weiiwang01/magi/README.md

> [!WARNING]  
> The magi project is still heavily in progress right now.
> A new version of magi is in the works.
