weiiwang01/magi/Magi.pdf

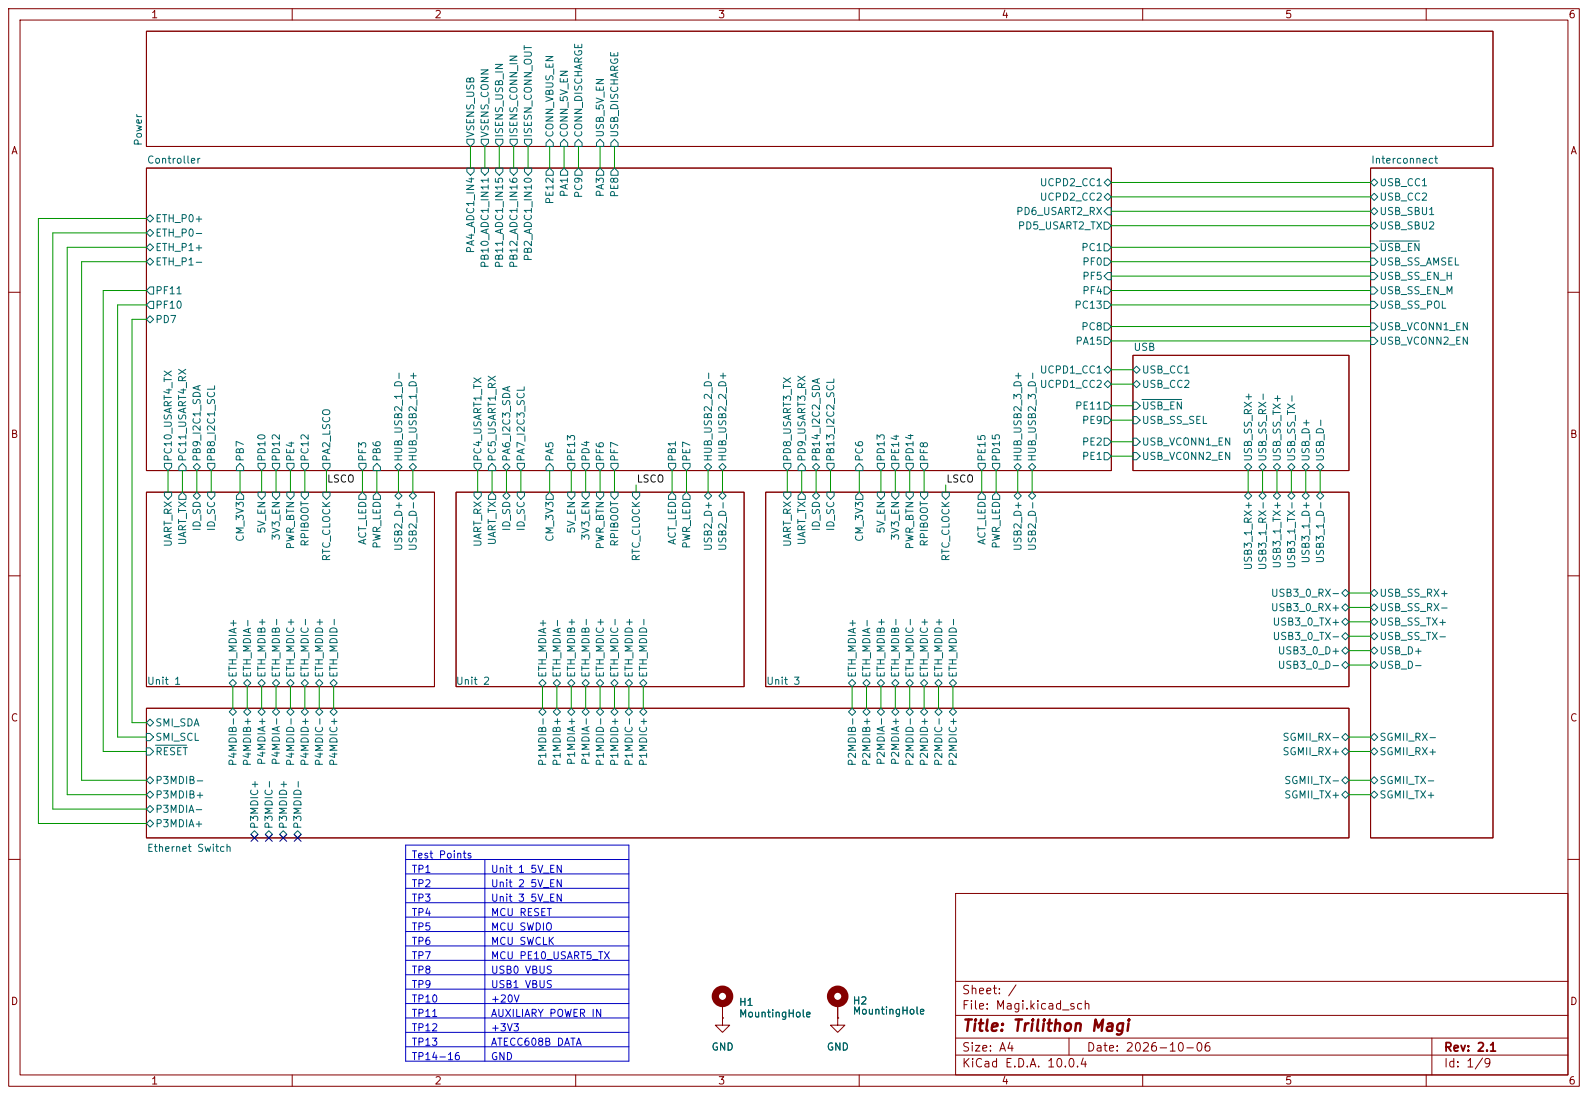
[picture p1: page 1]

TP1 | Unit 1 5V_EN
TP2 | Unit 2 5V_EN
TP3 | Unit 3 5V_EN
TP4 | MCU RESET
TP5 | MCU SWDIO
TP6 | MCU SWCLK
TP7 | MCU PE10_USART5_TX
TP8 | USB0 VBUS
TP9 | USB1 VBUS
TP10 | +20V
TP11 | AUXILIARY POWER IN

TP13 | ATECC608B DATA

Size: A4 | Rev: 2.1
KiCad E.D.A. 10.0.4 | Id: 1/9

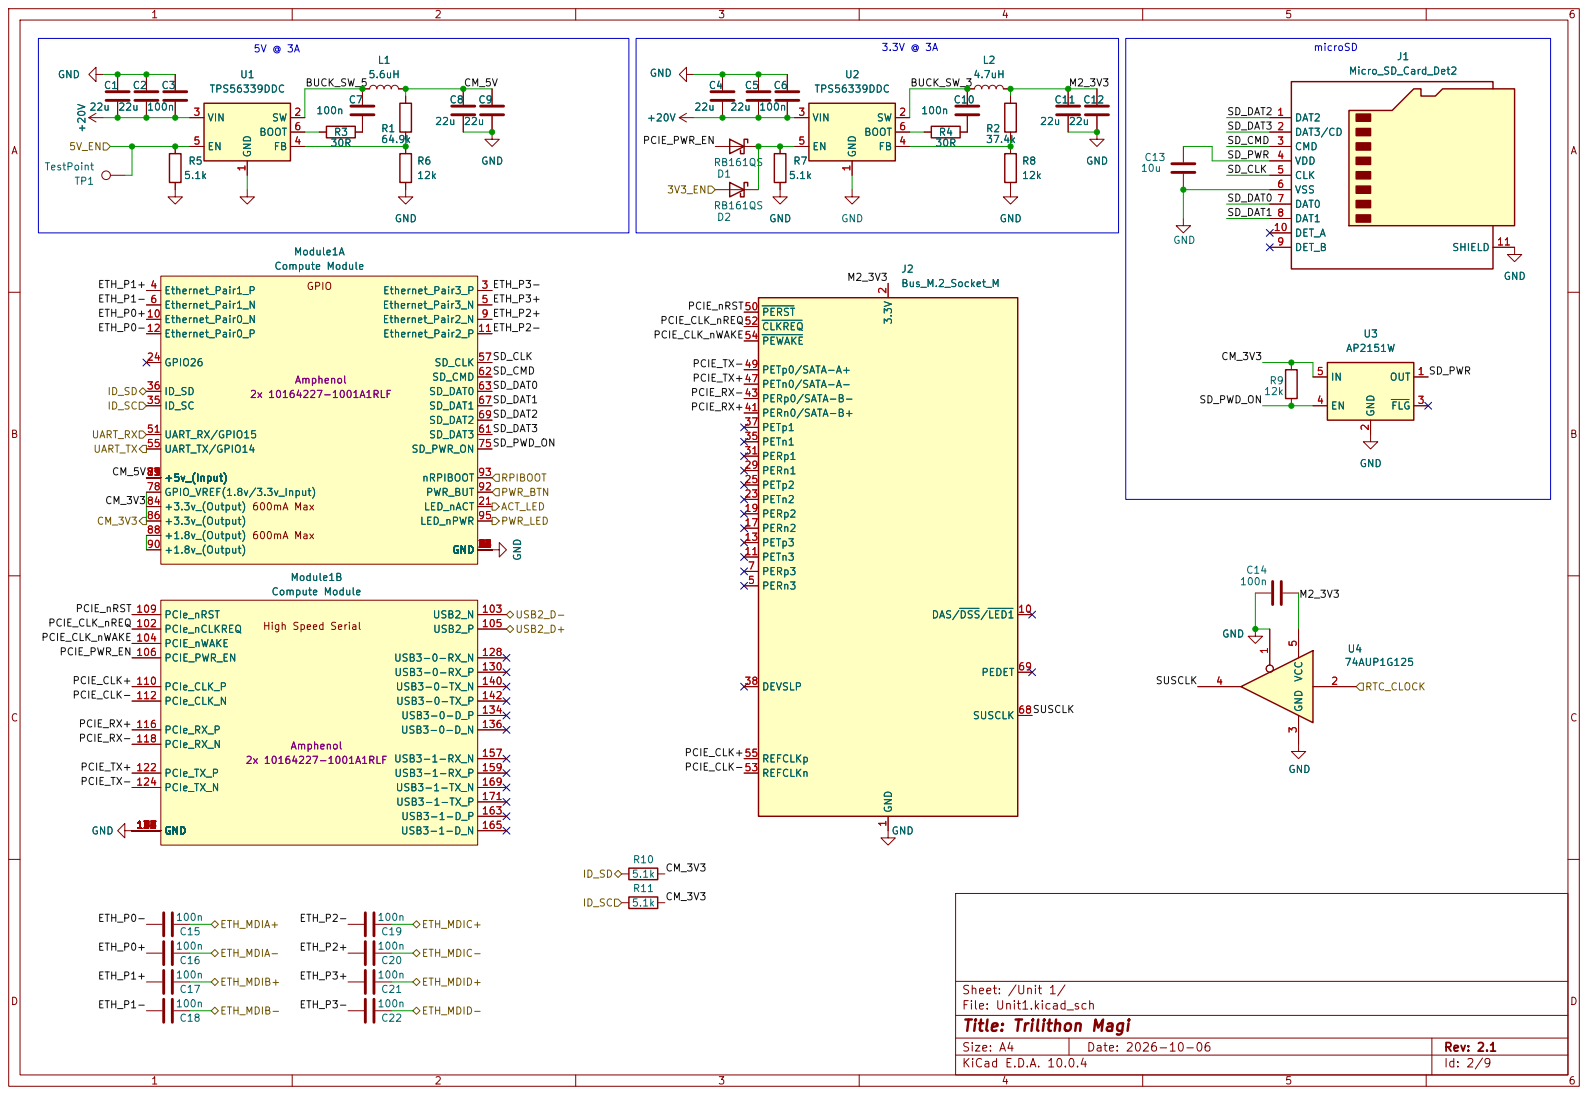
[picture p2: page 2]

1 3.3V 2 PERn3 5 PERp3 7 DAS/DSS/LED1 10 PETn3 11 PETp3 13 PERn2 17 PERp2 19 PETn2 23 PETp2 25 PERn1 29 PERp1 31 PETn1 35 PETp1 37 DEVSLP 38 PERn0/SATA-B+ 41 PERp0/SATA-B- 43 PETn0/SATA-A- 47 PETp0/SATA-A+ 49 PERST 50 CLKREQ 52 REFCLKn 53 PEWAKE 54 REFCLKp 55

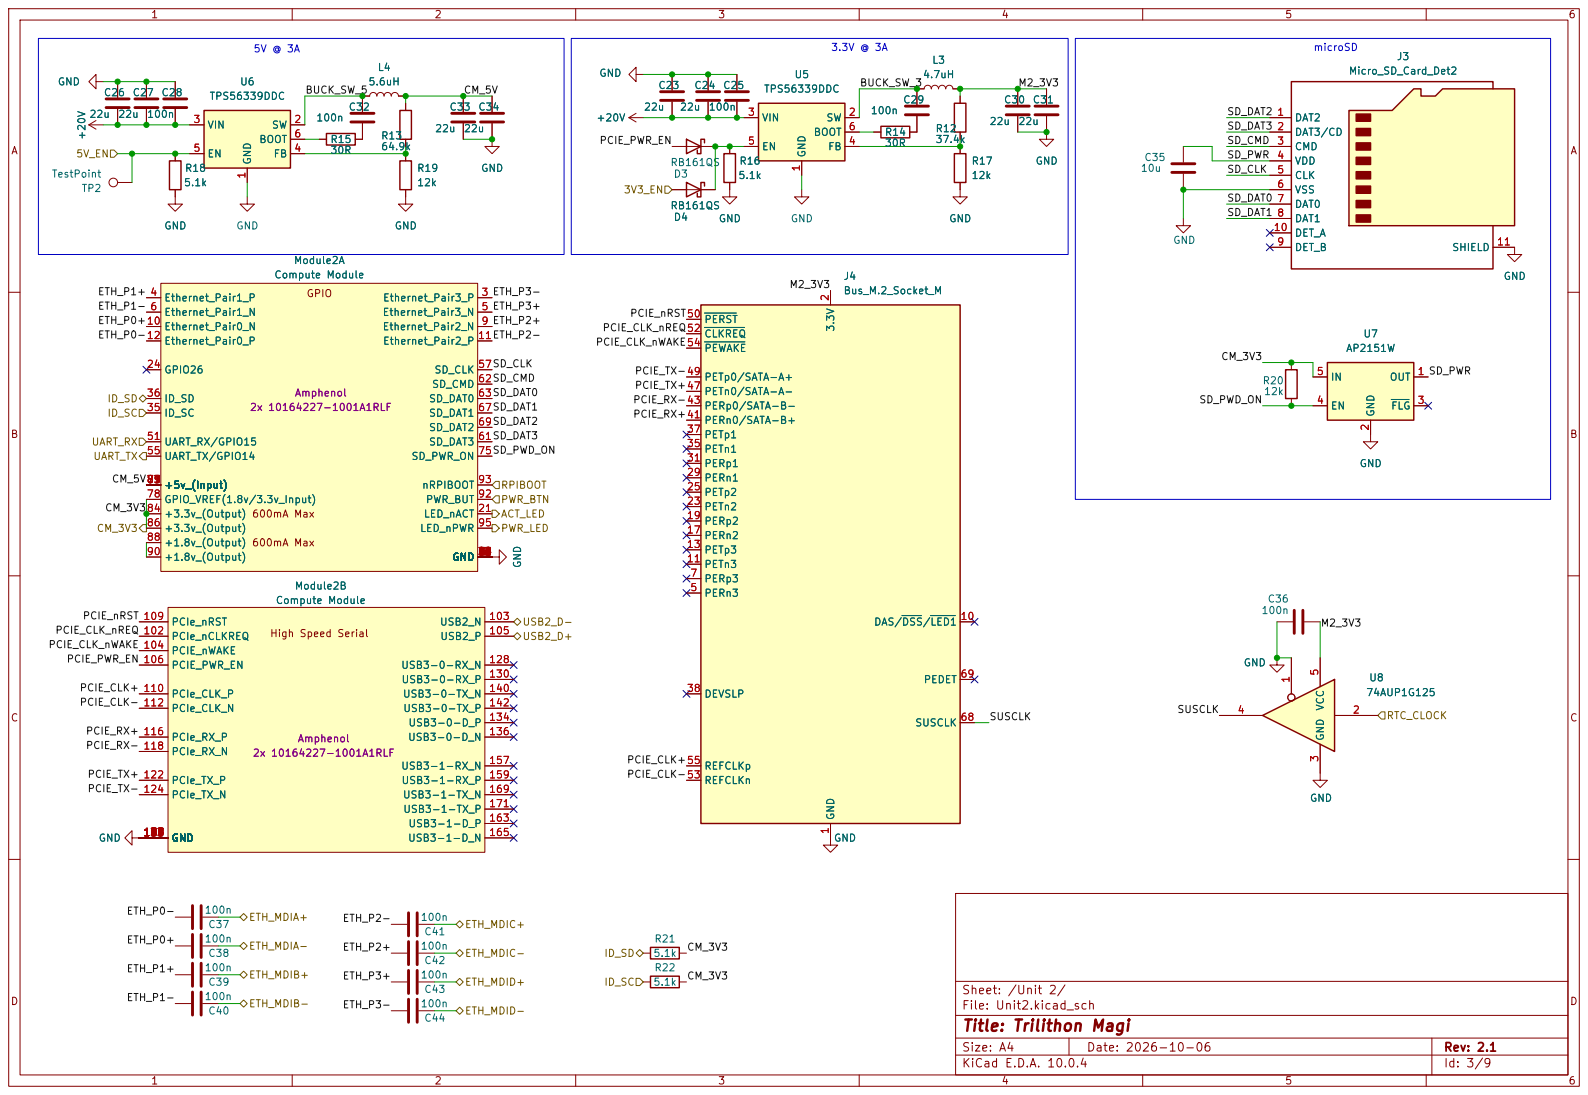
[picture p3: page 3]
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

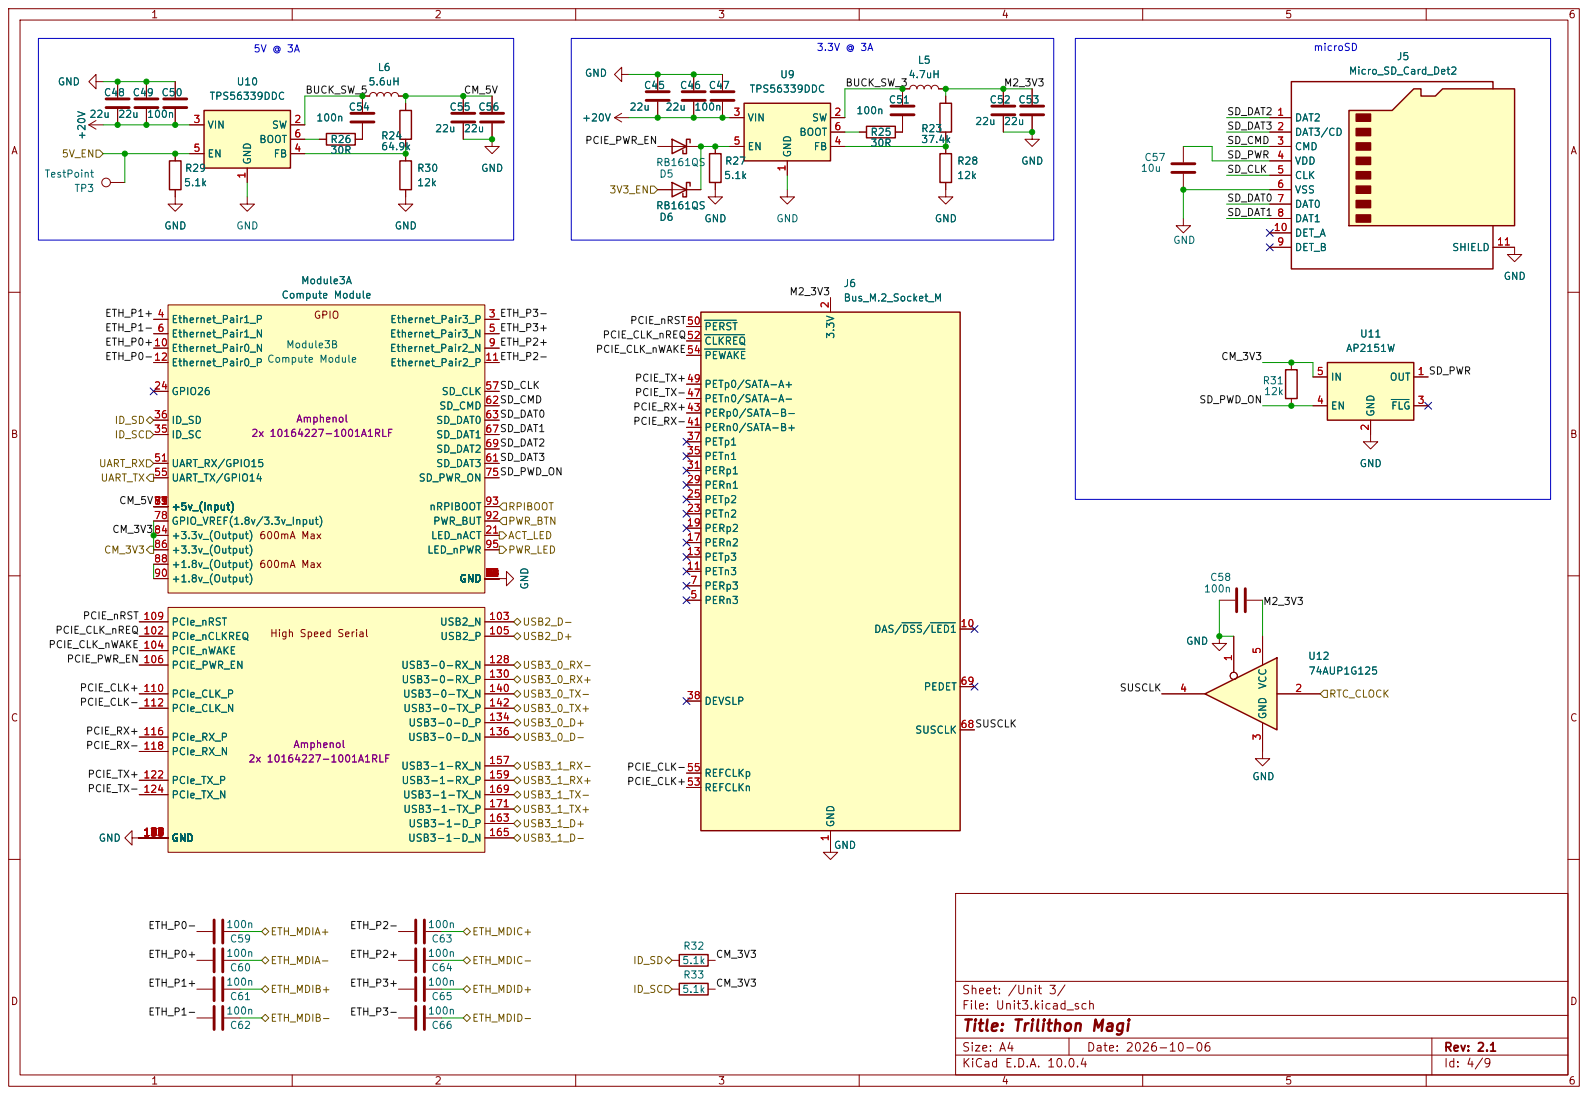
[picture p4: page 4]
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

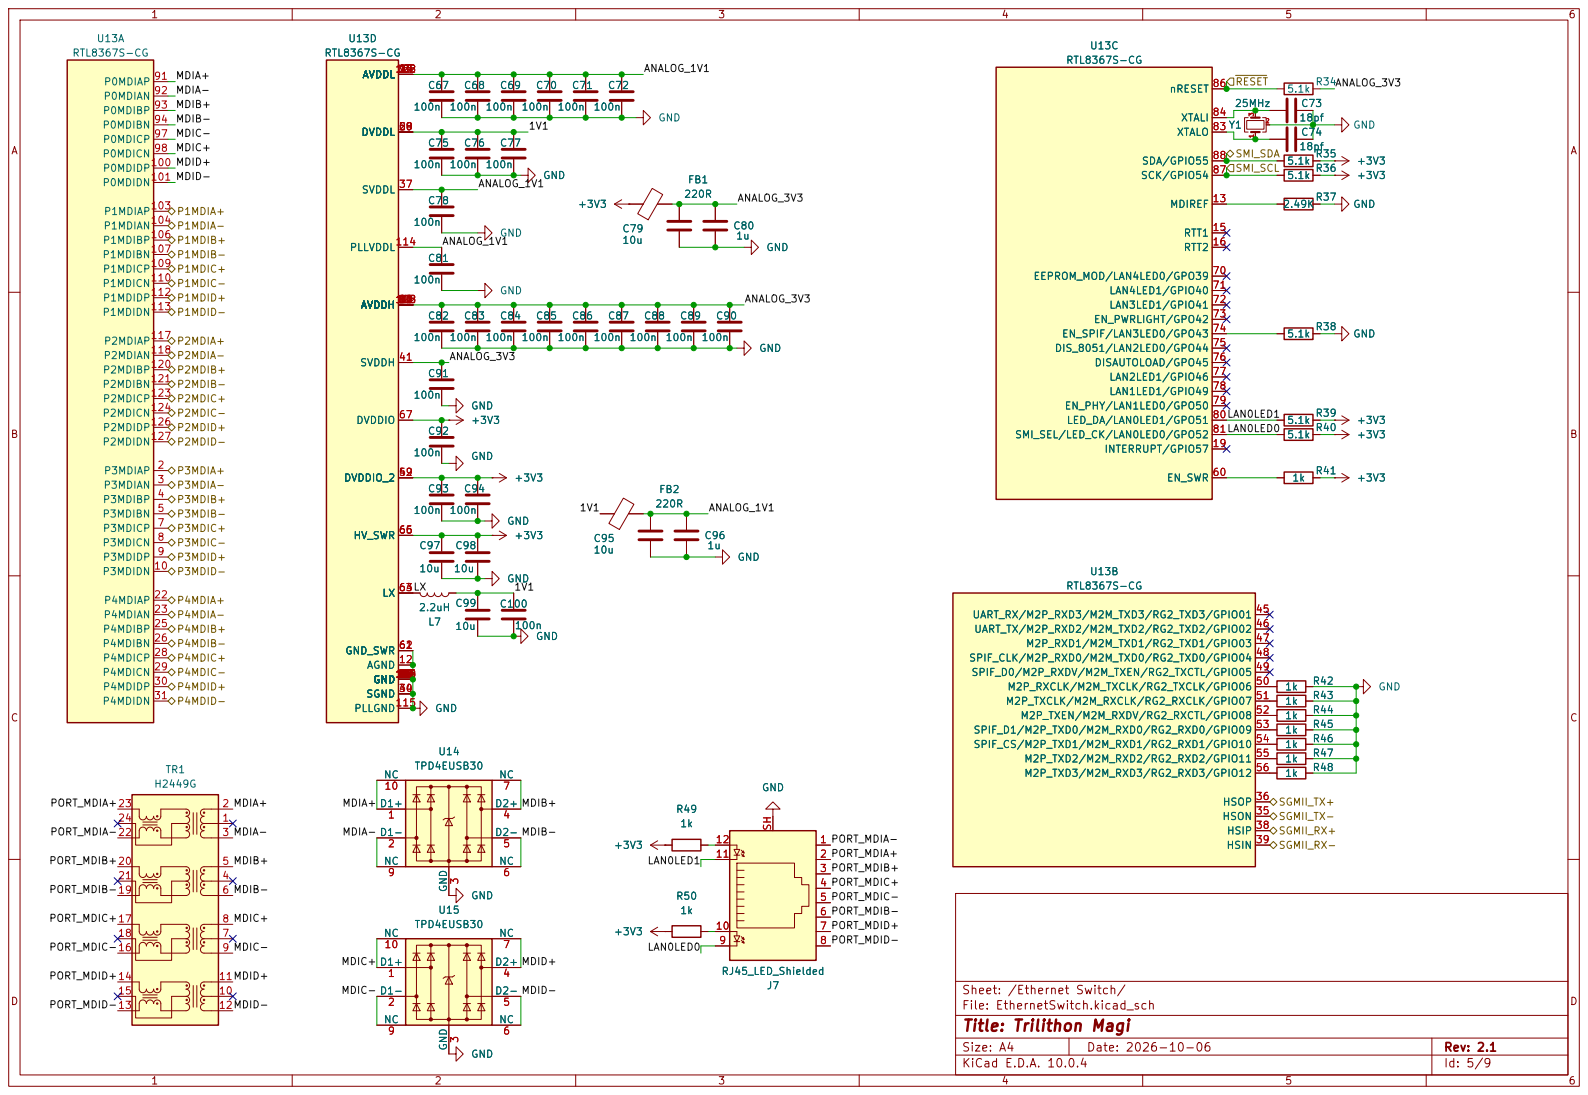
[picture p5: page 5]

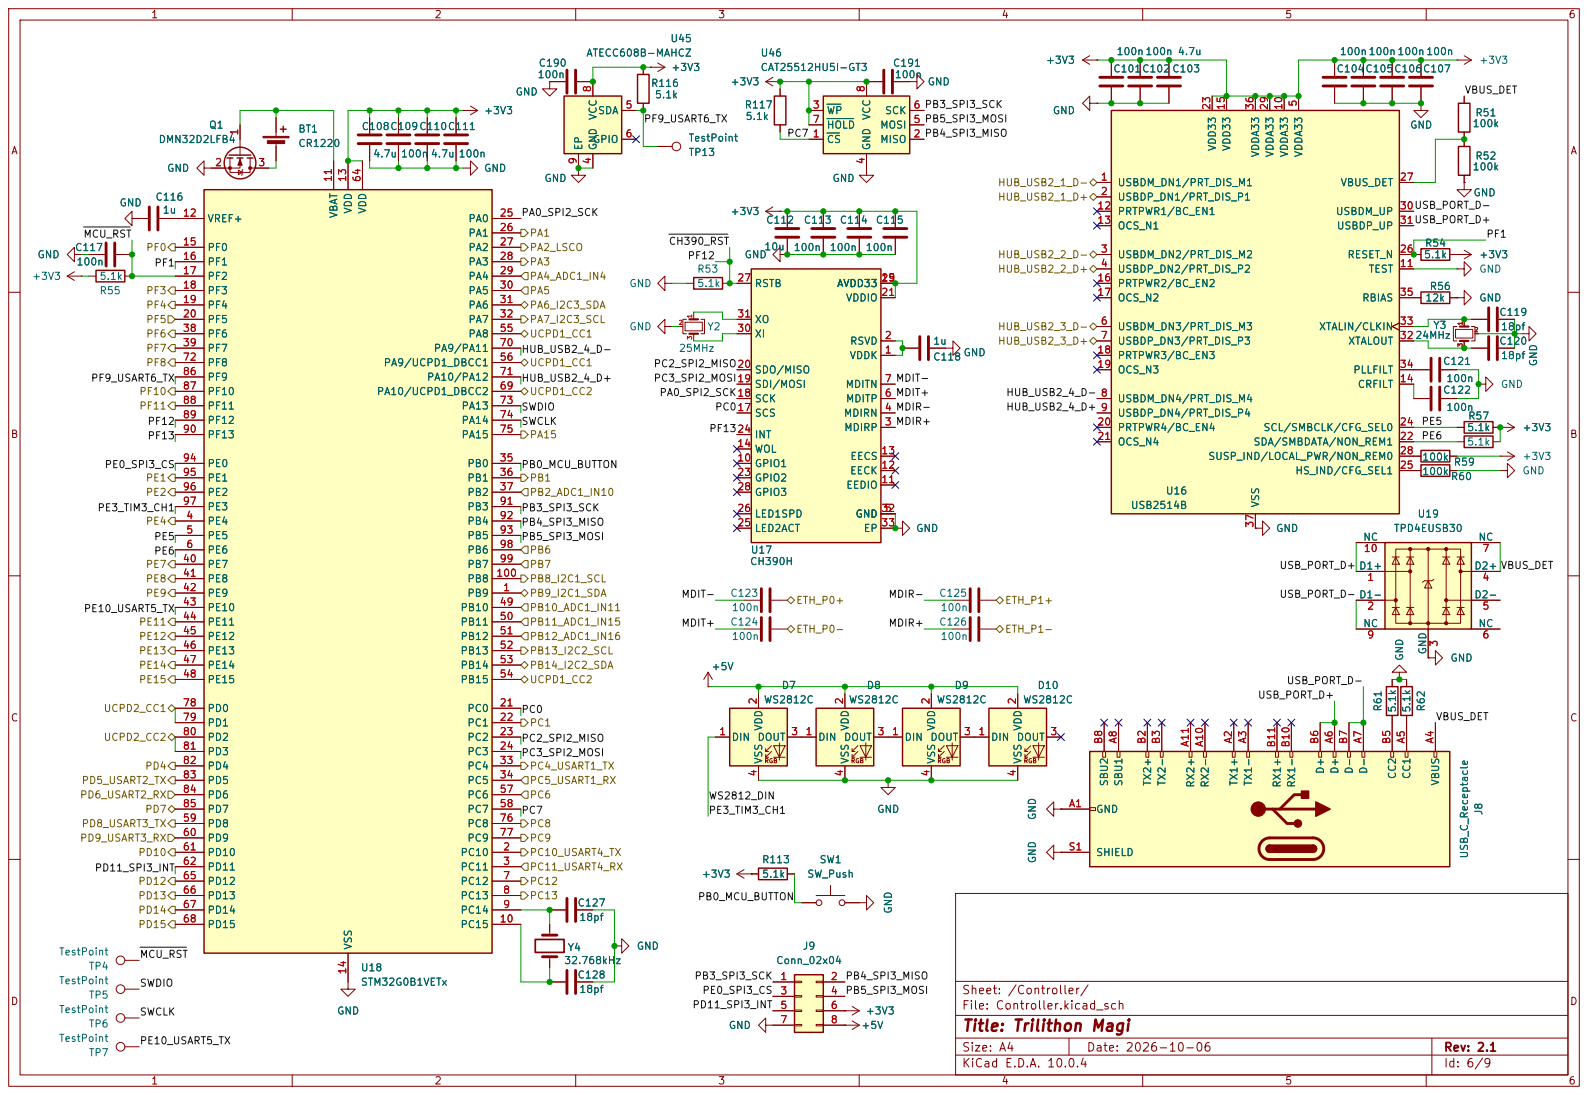
[picture p6: page 6]

SCS 17 SCK 18 SDI/MOSI 19 SDO/MISO 20

7 NC
D1+

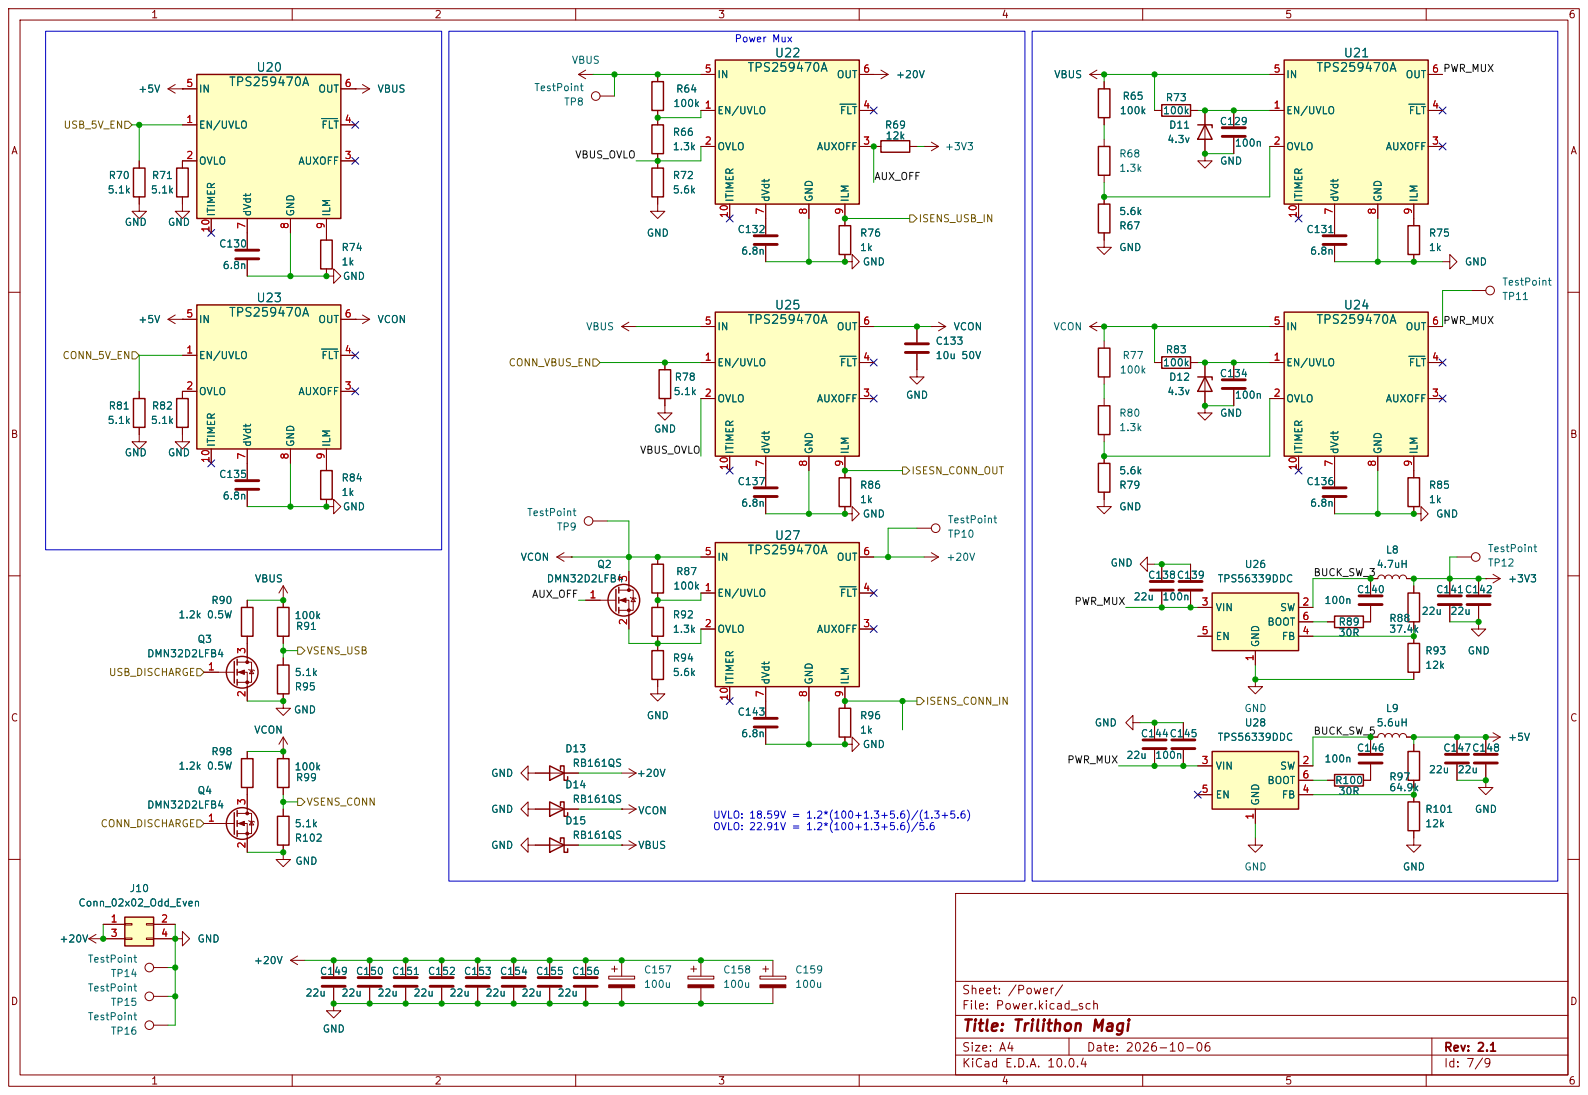
[picture p7: page 7]

PWR_MUX Power Mux UVLO: 18.59V = 1.2*(100+1.3+5.6)/(1.3+5.6) OVLO: 22.91V = 1.2*(100+1.3+5.6)/5.6
TestPoint +20V

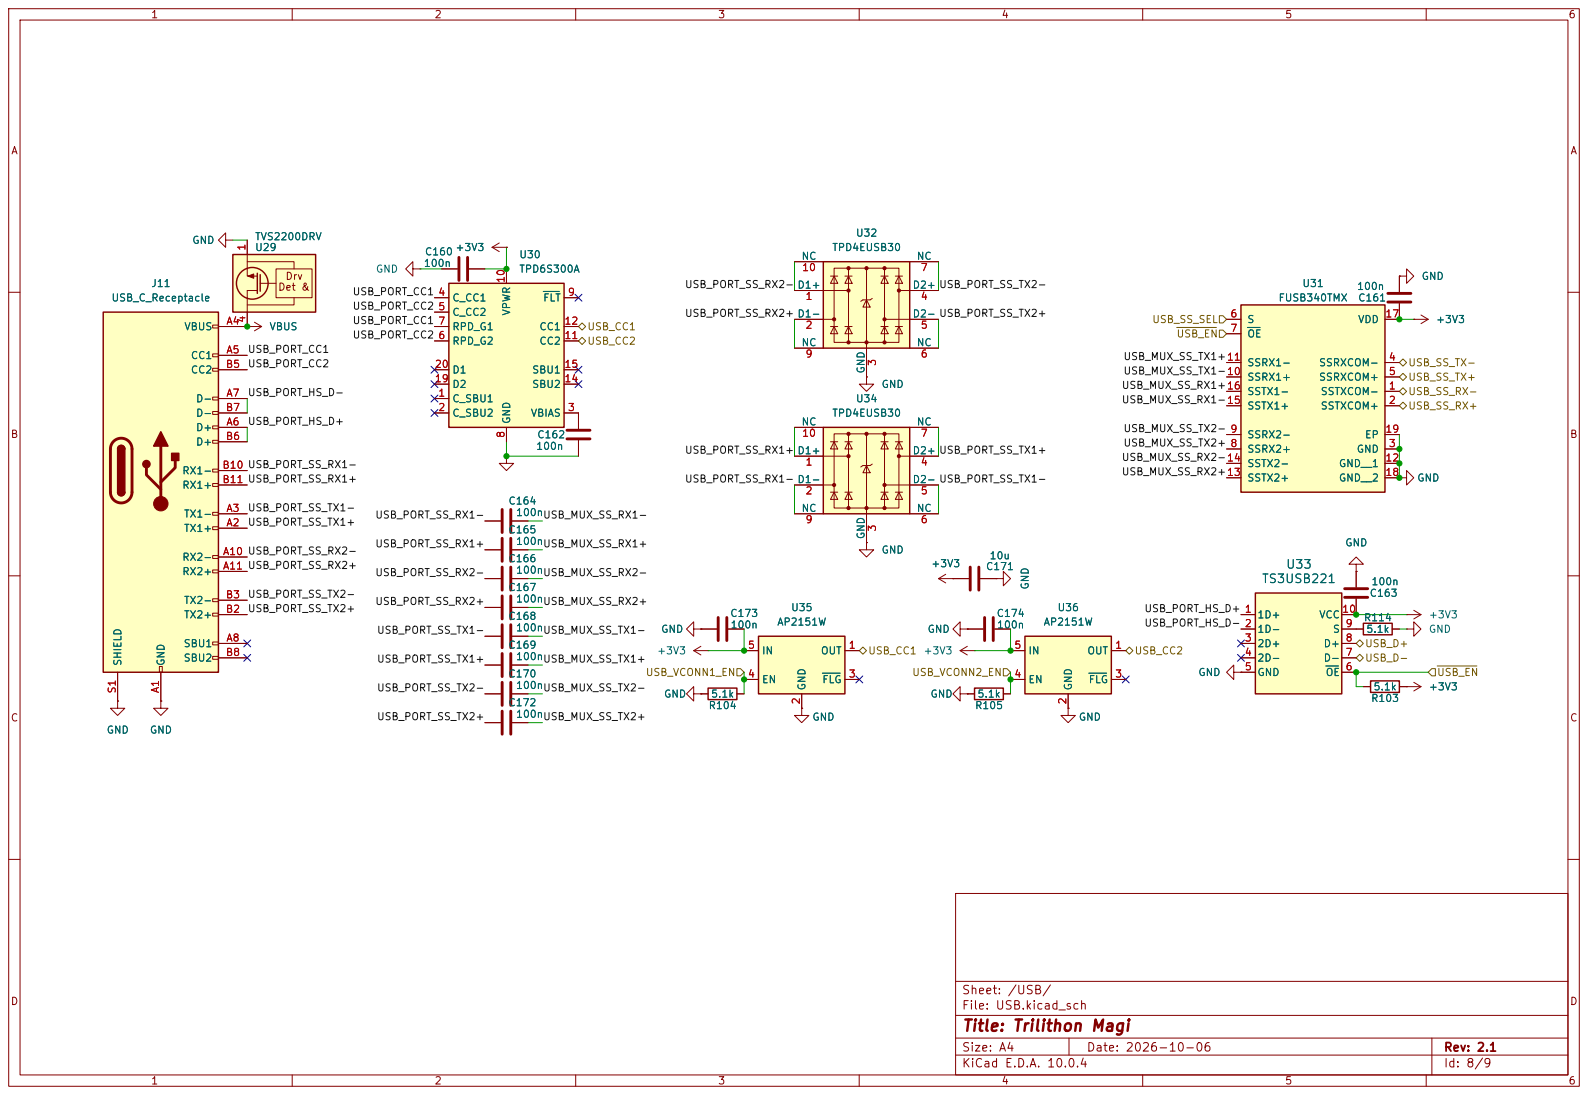
[picture p8: page 8]

TPD4EUSB30 GND | GND U34 | 7 NC

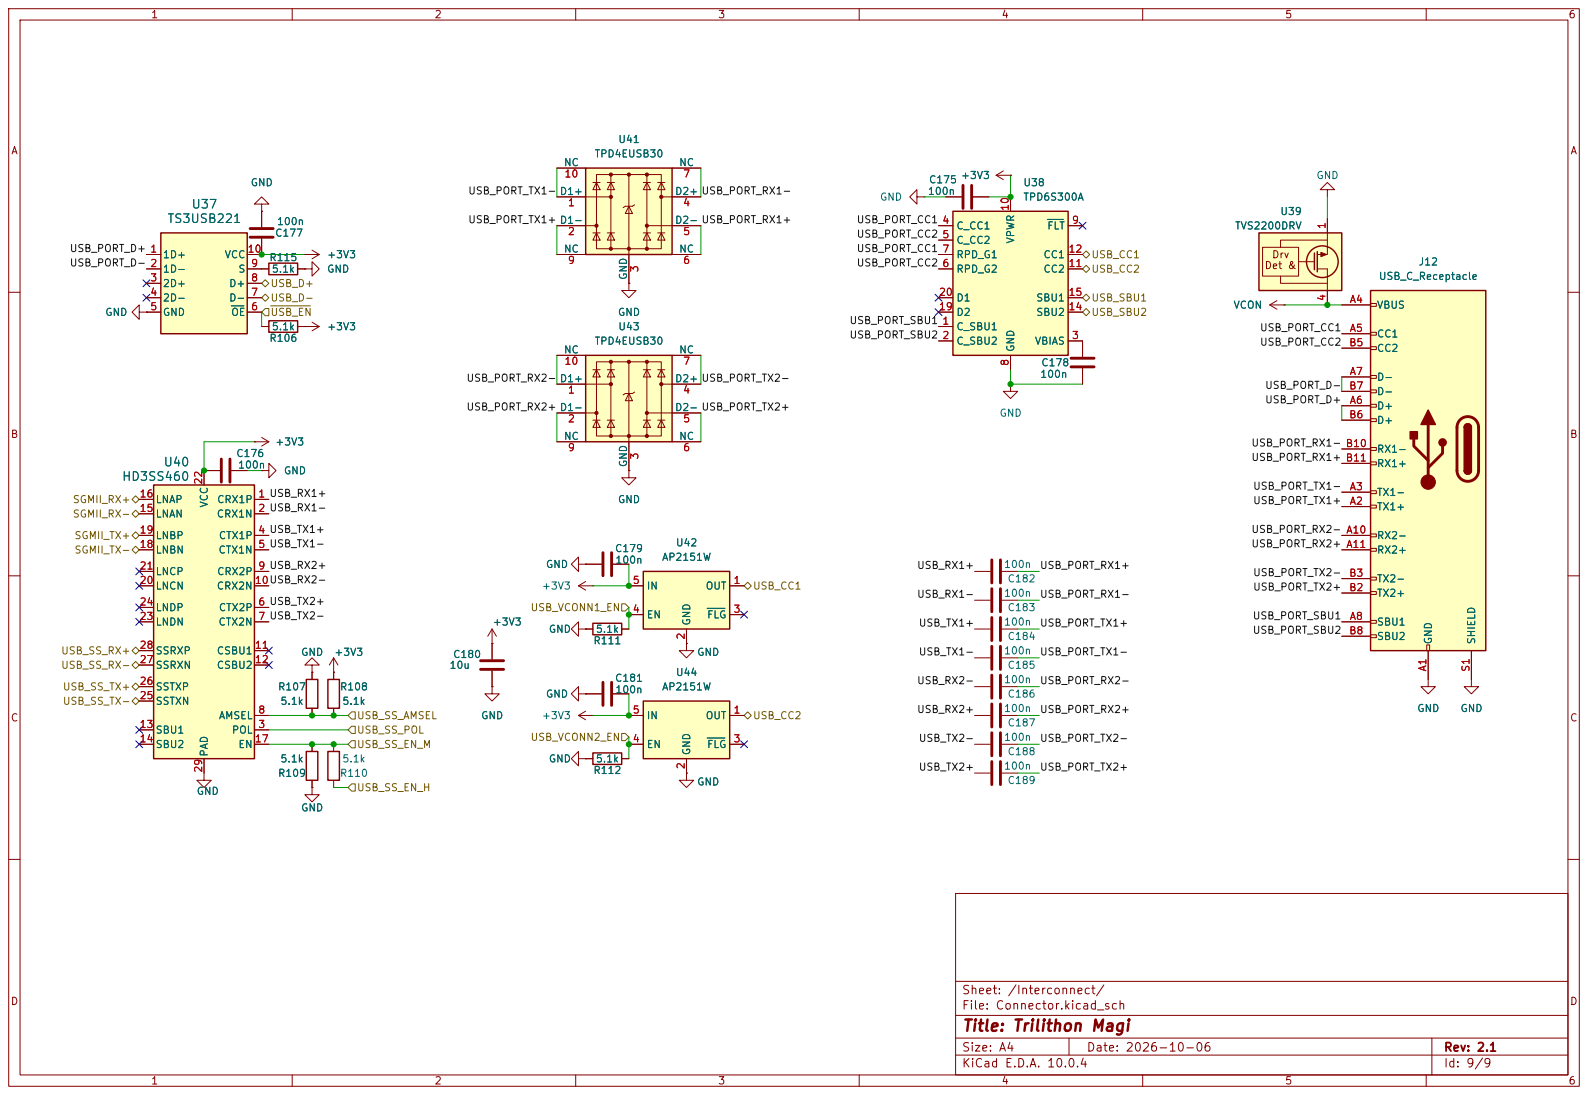
[picture p9: page 9]

7 NC
D1+
