weiiwang01/magi/Magi.kicad_pcb

## KiCad design Magi.kicad_pcb (2026-10-22)

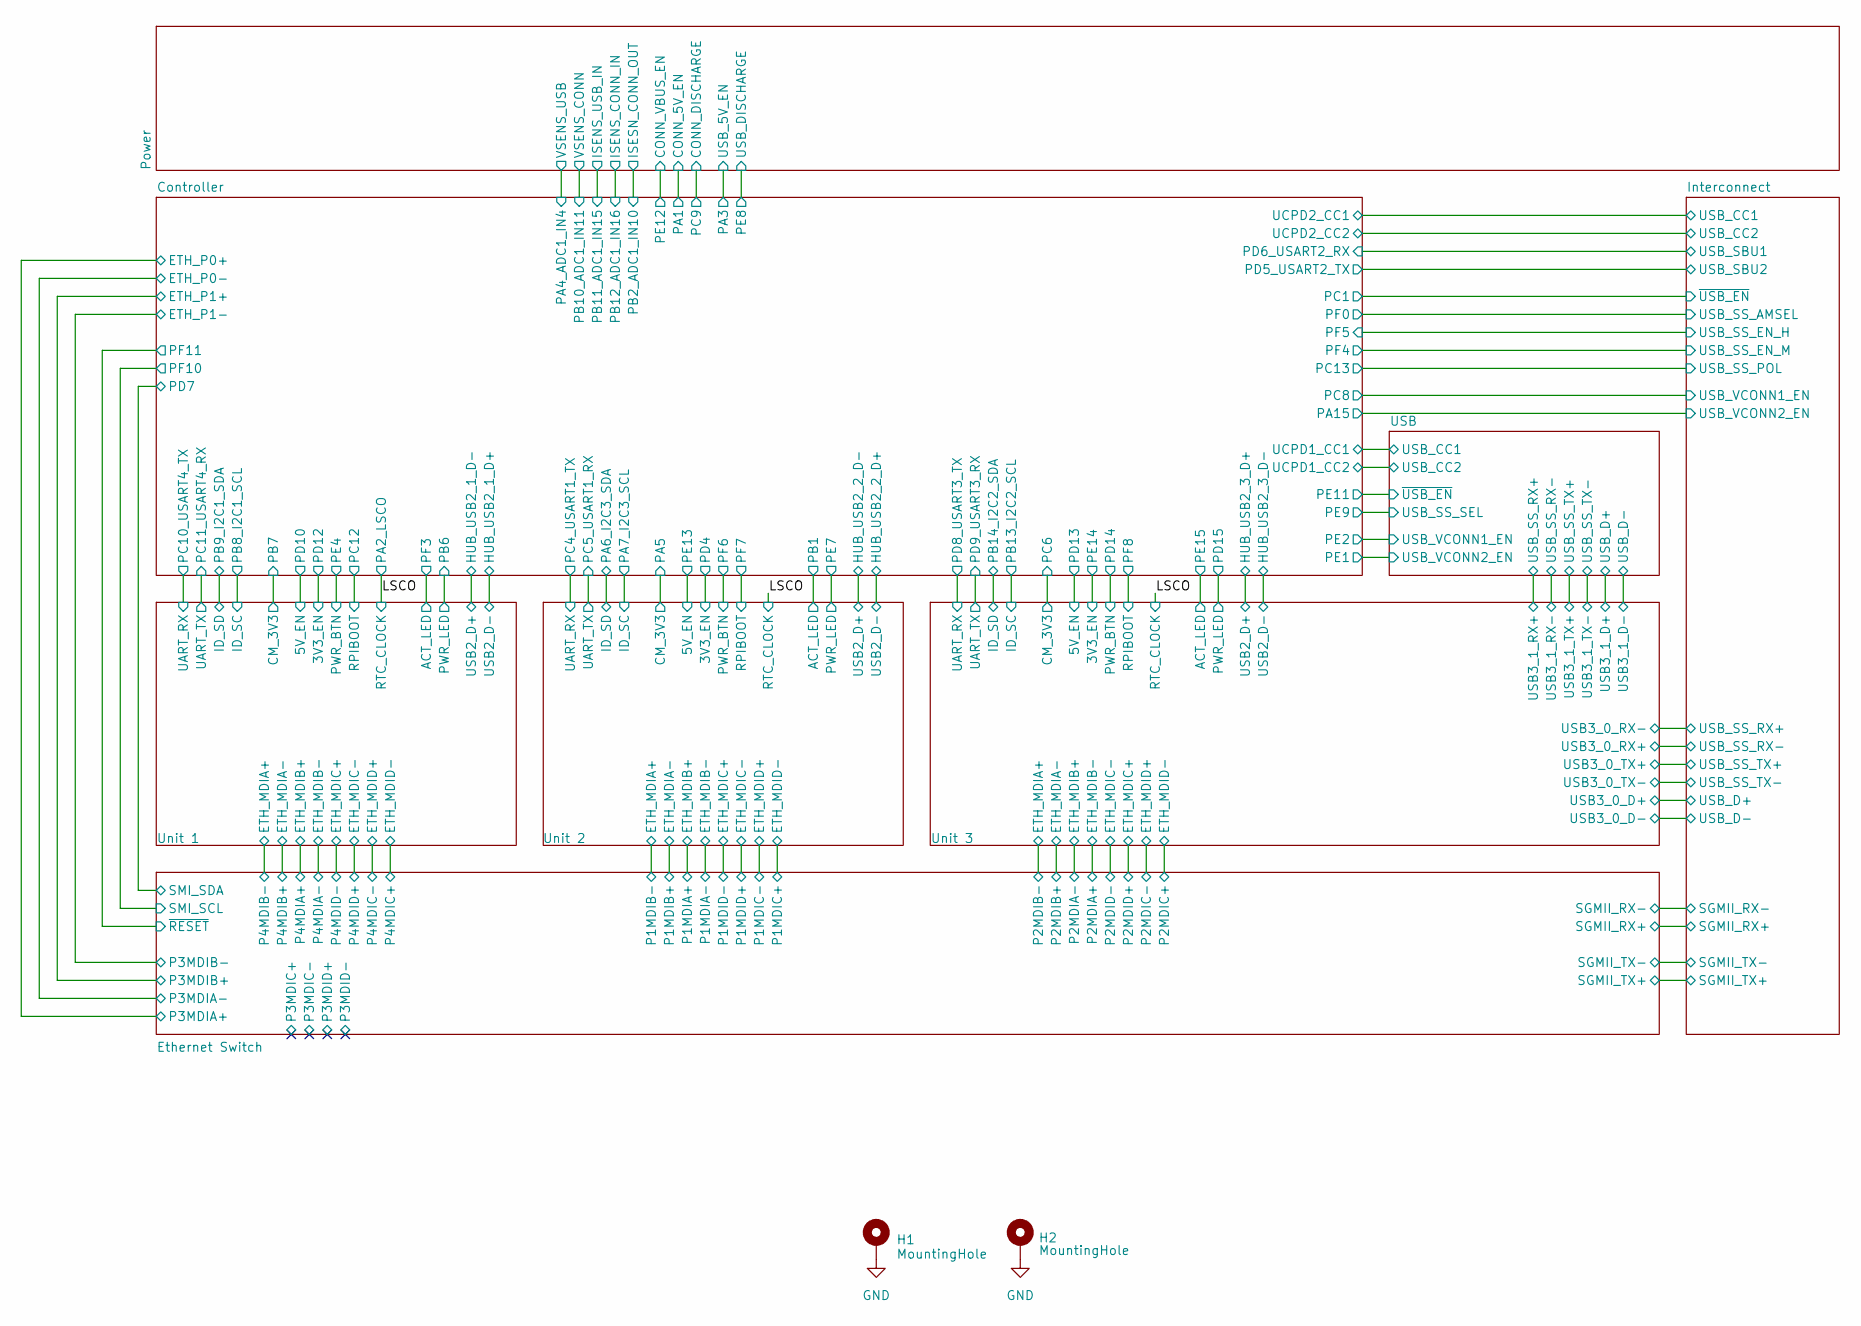
[picture p19: schematic Magi.kicad_sch, Trilithon Magi]

Parts:
H1, H2: MountingHole; MOUNTING-HOLE

Connections:
GND: H1.1 (1_1), H2.1 (1_1); also elsewhere on the board

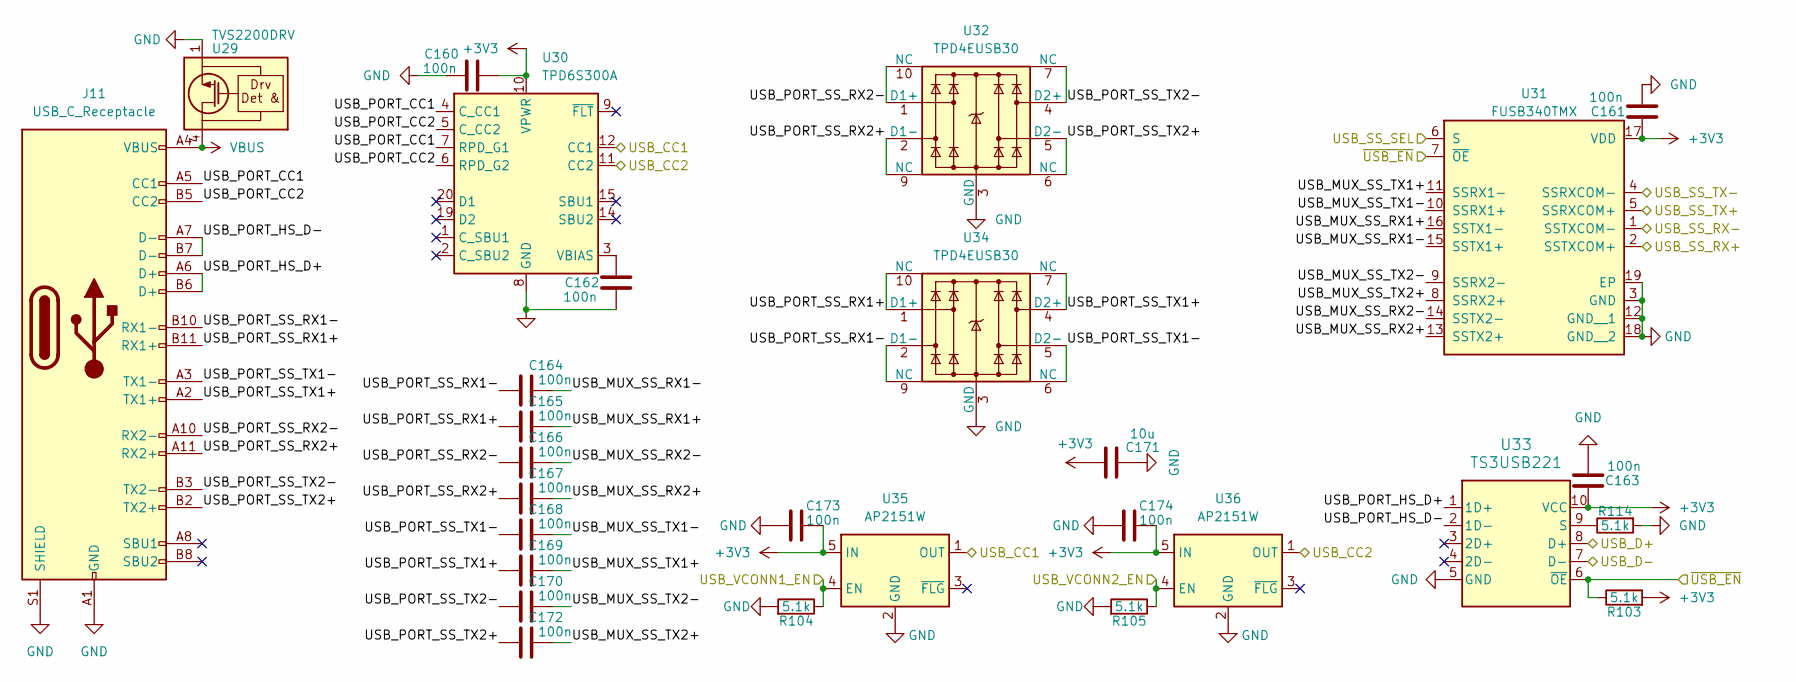
[picture p20: schematic USB.kicad_sch, Trilithon Magi]

Parts:
C160, C161, C162, C163, C164, C165, C166, C167, C168, C169, C170, C172, C173, C174: 100n; C_0402_1005Metric; MPN CL05B104KB54PNC; LCSC C307331
C171: 10u; C_0603_1608Metric; MPN CL10A106MA8NRNC; LCSC C96446
J11: USB_C_Receptacle; USB-C-SMD_TYPE-C-GT-USB-7007C; MPN GT-USB-9007A; LCSC C48533148
R103, R104, R105, R114: 5.1k; R_0402_1005Metric; MPN 0402WGF5101TCE; LCSC C25905
U29: TVS2200DRV; WSON-6-1EP_2x2mm_P0.65mm_EP1x1.6mm; MPN TVS2200DRVR; LCSC C523793
U30: TPD6S300A; WQFN-20-1EP_3x3mm_P0.4mm_EP1.7x1.7mm_ThermalVias; MPN TPD6S300A; LCSC C2876380
U31: FUSB340TMX; QFN-18-1EP_2x2.8mm_P0.4mm_EP1.05x1.85mm; MPN FUSB340TMX; LCSC C478457
U32, U34: TPD4EUSB30; USON-10_2.5x1.0mm_P0.5mm; MPN TPD4EUSB30DQAR; LCSC C90627
U33: TS3USB221; Texas_UQFN-10_1.5x2mm_P0.5mm; MPN TS3USB221ARSER; LCSC C128396
U35, U36: AP2151W; SOT-23-5; MPN AP2151WG-7; LCSC C110464

Connections:
+3V3: C160.1, C161.1, C163.1, C171.1, C173.1, C174.1, R103.2, U30.10 (VPWR), U31.17 (VDD), U33.10 (VCC), U35.5 (IN), U36.5 (IN); also elsewhere on the board
/Controller/PE1: R105.1, U36.4 (EN); also elsewhere on the board
/Controller/PE2: R104.1, U35.4 (EN); also elsewhere on the board
/Controller/PE9: U31.6 (S); also elsewhere on the board
/Controller/PE11: R103.1, U31.7 (~OE), U33.6 (~OE); also elsewhere on the board
/Controller/UCPD1_CC1: U30.12 (CC1), U35.1 (OUT); also elsewhere on the board
/Controller/UCPD1_CC2: U30.11 (CC2), U36.1 (OUT); also elsewhere on the board
/USB/USB_D+: U33.8 (D+); also elsewhere on the board
/USB/USB_D-: U33.7 (D-); also elsewhere on the board
/USB/USB_MUX_SS_RX1+: C165.2, U31.16 (SSTX1-)
/USB/USB_MUX_SS_RX1-: C164.2, U31.15 (SSTX1+)
/USB/USB_MUX_SS_RX2+: C167.2, U31.13 (SSTX2+)
/USB/USB_MUX_SS_RX2-: C166.2, U31.14 (SSTX2-)
/USB/USB_MUX_SS_TX1+: C169.2, U31.11 (SSRX1-)
/USB/USB_MUX_SS_TX1-: C168.2, U31.10 (SSRX1+)
/USB/USB_MUX_SS_TX2+: C172.2, U31.8 (SSRX2+)
/USB/USB_MUX_SS_TX2-: C170.2, U31.9 (SSRX2-)
/USB/USB_PORT_CC1: J11.A5 (CC1), U30.4 (C_CC1), U30.7 (RPD_G1)
/USB/USB_PORT_CC2: J11.B5 (CC2), U30.5 (C_CC2), U30.6 (RPD_G2)
/USB/USB_PORT_HS_D+: J11.A6 (D+), J11.B6 (D+), U33.1 (1D+)
/USB/USB_PORT_HS_D-: J11.A7 (D-), J11.B7 (D-), U33.2 (1D-)
/USB/USB_PORT_SS_RX1+: C165.1, J11.B11 (RX1+), U34.1 (D1+), U34.10 (NC)
/USB/USB_PORT_SS_RX1-: C164.1, J11.B10 (RX1-), U34.2 (D1-), U34.9 (NC)
/USB/USB_PORT_SS_RX2+: C167.1, J11.A11 (RX2+), U32.2 (D1-), U32.9 (NC)
/USB/USB_PORT_SS_RX2-: C166.1, J11.A10 (RX2-), U32.1 (D1+), U32.10 (NC)
/USB/USB_PORT_SS_TX1+: C169.1, J11.A2 (TX1+), U34.4 (D2+), U34.7 (NC)
/USB/USB_PORT_SS_TX1-: C168.1, J11.A3 (TX1-), U34.5 (D2-), U34.6 (NC)
/USB/USB_PORT_SS_TX2+: C172.1, J11.B2 (TX2+), U32.5 (D2-), U32.6 (NC)
/USB/USB_PORT_SS_TX2-: C170.1, J11.B3 (TX2-), U32.4 (D2+), U32.7 (NC)
/USB/USB_SS_RX+: U31.2 (SSTXCOM+); also elsewhere on the board
/USB/USB_SS_RX-: U31.1 (SSTXCOM-); also elsewhere on the board
/USB/USB_SS_TX+: U31.5 (SSRXCOM+); also elsewhere on the board
/USB/USB_SS_TX-: U31.4 (SSRXCOM-); also elsewhere on the board
GND: C160.2, C161.2, C162.2, C163.2, C171.2, C173.2, C174.2, J11.A1 (GND), J11.A12 (GND), J11.B1 (GND), J11.B12 (GND), J11.S1 (SHIELD), R104.2, R105.2, R114.2, U29.1 (GND), U29.2 (GND), U29.3 (GND), U29.7 (GND), U30.8 (GND), U30.13 (GND), U30.16 (GND), U30.17 (GND), U30.18 (GND), U30.21 (GND), U31.3 (GND), U31.12 (GND__1), U31.18 (GND__2), U31.19 (EP), U32.3 (GND), U32.8 (GND), U33.5 (GND), U34.3 (GND), U34.8 (GND), U35.2 (GND), U36.2 (GND); also elsewhere on the board
unnamed: C162.1, U30.3 (VBIAS)
unnamed: R114.1, U33.9 (S)
VBUS: J11.A4 (VBUS), J11.A9 (VBUS), J11.B4 (VBUS), J11.B9 (VBUS), U29.4 (IN), U29.5 (IN), U29.6 (IN); also elsewhere on the board

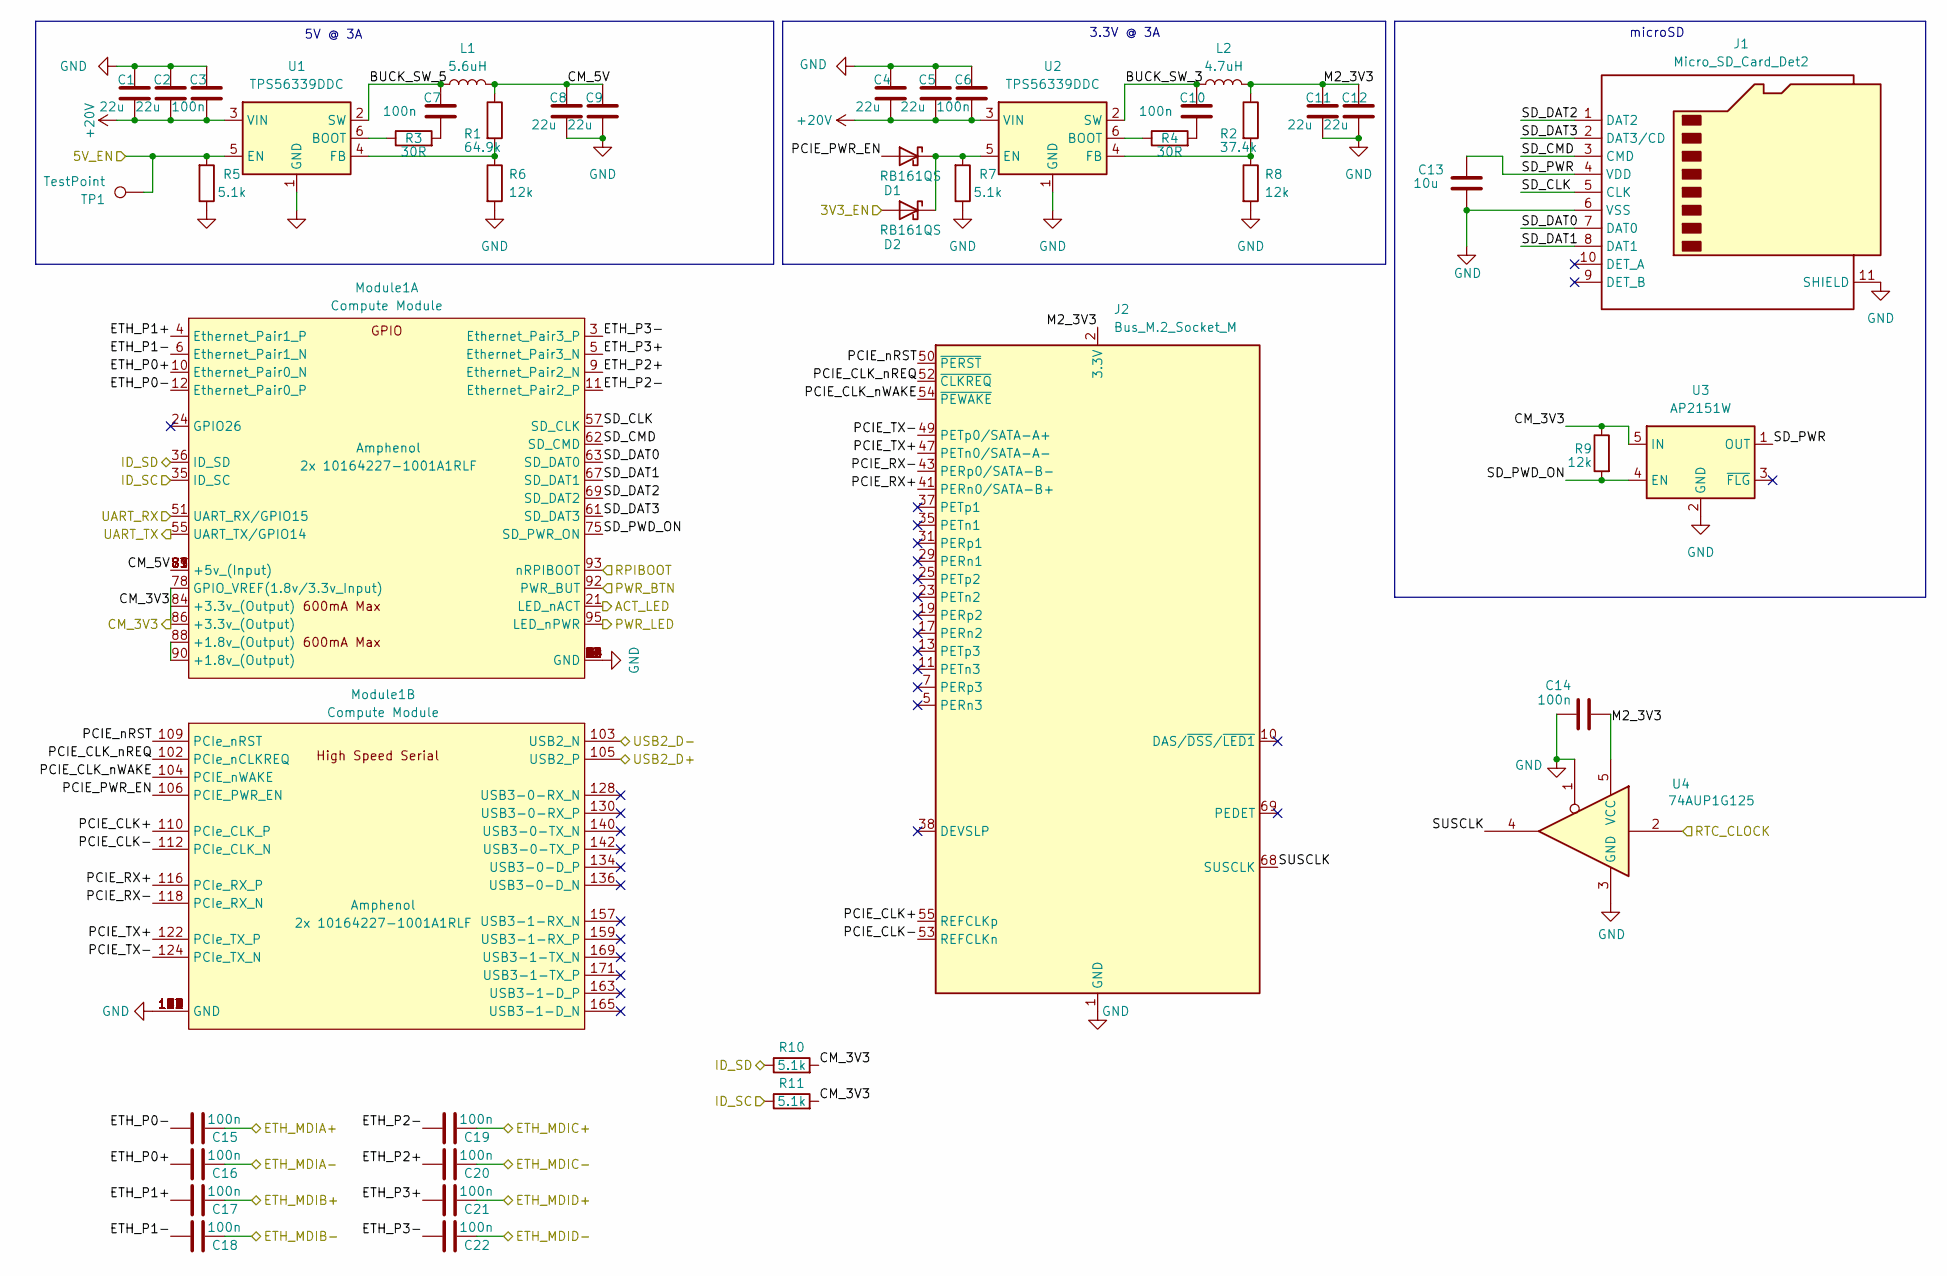
[picture p21: schematic Unit1.kicad_sch, Trilithon Magi]

Parts:
C1, C2, C4, C5, C8, C9, C11, C12: 22u; C_0805_2012Metric; MPN CL21A226MAQNNNE; LCSC C45783
C3, C6, C7, C10, C14, C15, C16, C17, C18, C19, C20, C21, C22: 100n; C_0402_1005Metric; MPN CL05B104KB54PNC; LCSC C307331
C13: 10u; C_0603_1608Metric; MPN CL10A106MA8NRNC; LCSC C96446
D1, D2: RB161QS; D_SOD-882; MPN RB161QS-40; LCSC C28646385
J1: Micro_SD_Card_Det2; SDCARD_MOLEX_503398-1892; MPN 5033981892; LCSC C428492
J2: Bus_M.2_Socket_M; CONN-SMD_APCI0146-P001A; MPN APCI0146-P001A; LCSC C841645
L1: 5.6uH; L_Changjiang_FTC404030S; MPN FTC404030S5R6MBCA; LCSC C53436374
L2: 4.7uH; L_Changjiang_FTC404030S; MPN FTC404030S4R7MGCA; LCSC C39676083
Module1: Compute Module; Raspberry-Pi-4-Compute-Module
R1: 64.9k; R_0402_1005Metric; MPN ERJ2RKF6492X; LCSC C416566
R2: 37.4k; R_0402_1005Metric; MPN RC0402FR-0737K4L; LCSC C185422
R3, R4: 30R; R_0402_1005Metric; MPN 0402WGF300JTCE; LCSC C270617
R5, R7, R10, R11: 5.1k; R_0402_1005Metric; MPN 0402WGF5101TCE; LCSC C25905
R6, R8, R9: 12k; R_0402_1005Metric; MPN 0402WGF1202TCE; LCSC C25752
TP1: TestPoint; TestPoint_Pad_D1.5mm
U1, U2: TPS56339DDC; SOT-23-6; MPN TPS56339DDCR; LCSC C2071106
U3: AP2151W; SOT-23-5; MPN AP2151WG-7; LCSC C110464
U4: 74AUP1G125; Texas_X2SON-5_0.8x0.8mm_P0.48mm; MPN SN74AUP1G125DPWR; LCSC C2861319

Connections:
+20V: C1.2, C2.2, C3.2, C4.2, C5.2, C6.2, U1.3 (VIN), U2.3 (VIN); also elsewhere on the board
/Controller/HUB_USB2_1_D+: Module1.103 (USB2_N); also elsewhere on the board
/Controller/HUB_USB2_1_D-: Module1.105 (USB2_P); also elsewhere on the board
/Controller/PB6: Module1.95 (LED_nPWR); also elsewhere on the board
/Controller/PB8_I2C1_SCL: Module1.35 (ID_SC), R11.1; also elsewhere on the board
/Controller/PB9_I2C1_SDA: Module1.36 (ID_SD), R10.1; also elsewhere on the board
/Controller/PC10_USART4_TX: Module1.51 (UART_RX/GPIO15); also elsewhere on the board
/Controller/PC11_USART4_RX: Module1.55 (UART_TX/GPIO14); also elsewhere on the board
/Controller/PC12: Module1.93 (nRPIBOOT); also elsewhere on the board
/Controller/PD10: R5.2, TP1.1 (1_1), U1.5 (EN); also elsewhere on the board
/Controller/PD12: D2.2 (A); also elsewhere on the board
/Controller/PE4: Module1.92 (PWR_BUT); also elsewhere on the board
/Controller/PF3: Module1.21 (LED_nACT); also elsewhere on the board
/Ethernet Switch/P4MDIA+: C17.1; also elsewhere on the board
/Ethernet Switch/P4MDIA-: C18.1; also elsewhere on the board
/Ethernet Switch/P4MDIB+: C16.1; also elsewhere on the board
/Ethernet Switch/P4MDIB-: C15.1; also elsewhere on the board
/Ethernet Switch/P4MDIC+: C22.1; also elsewhere on the board
/Ethernet Switch/P4MDIC-: C21.1; also elsewhere on the board
/Ethernet Switch/P4MDID+: C20.1; also elsewhere on the board
/Ethernet Switch/P4MDID-: C19.1; also elsewhere on the board
/LSCO: U4.2; also elsewhere on the board
/Unit 1/BUCK_SW_3: C10.1, L2.1, U2.2 (SW)
/Unit 1/BUCK_SW_5: C7.1, L1.1, U1.2 (SW)
/Unit 1/CM_3V3: Module1.78 (GPIO_VREF(1.8v/3.3v_Input)), Module1.84 (+3.3v_(Output)), Module1.86 (+3.3v_(Output)), R9.1, R10.2, R11.2, U3.5 (IN); also elsewhere on the board
/Unit 1/CM_5V: C8.1, C9.1, L1.2, Module1.77 (+5v_(Input)), Module1.79 (+5v_(Input)), Module1.81 (+5v_(Input)), Module1.83 (+5v_(Input)), Module1.85 (+5v_(Input)), Module1.87 (+5v_(Input)), R1.1
/Unit 1/ETH_P0+: C16.2, Module1.10 (Ethernet_Pair0_N)
/Unit 1/ETH_P0-: C15.2, Module1.12 (Ethernet_Pair0_P)
/Unit 1/ETH_P1+: C17.2, Module1.4 (Ethernet_Pair1_P)
/Unit 1/ETH_P1-: C18.2, Module1.6 (Ethernet_Pair1_N)
/Unit 1/ETH_P2+: C20.2, Module1.9 (Ethernet_Pair2_N)
/Unit 1/ETH_P2-: C19.2, Module1.11 (Ethernet_Pair2_P)
/Unit 1/ETH_P3+: C21.2, Module1.5 (Ethernet_Pair3_N)
/Unit 1/ETH_P3-: C22.2, Module1.3 (Ethernet_Pair3_P)
/Unit 1/M2_3V3: C11.1, C12.1, C14.2, J2.2 (3.3V), J2.4 (3.3V), J2.12 (3.3V), J2.14 (3.3V), J2.16 (3.3V), J2.18 (3.3V), J2.70 (3.3V), J2.72 (3.3V), J2.74 (3.3V), L2.2, R2.1, U4.5 (VCC)
/Unit 1/PCIE_CLK+: J2.55 (REFCLKp), Module1.110 (PCIe_CLK_P)
/Unit 1/PCIE_CLK-: J2.53 (REFCLKn), Module1.112 (PCIe_CLK_N)
/Unit 1/PCIE_CLK_nREQ: J2.52 (~CLKREQ), Module1.102 (PCIe_nCLKREQ)
/Unit 1/PCIE_CLK_nWAKE: J2.54 (~PEWAKE), Module1.104 (PCIE_nWAKE)
/Unit 1/PCIE_PWR_EN: D1.2 (A), Module1.106 (PCIE_PWR_EN)
/Unit 1/PCIE_RX+: J2.41 (PERn0/SATA-B+), Module1.116 (PCIe_RX_P)
/Unit 1/PCIE_RX-: J2.43 (PERp0/SATA-B-), Module1.118 (PCIe_RX_N)
/Unit 1/PCIE_TX+: J2.47 (PETn0/SATA-A-), Module1.122 (PCIe_TX_P)
/Unit 1/PCIE_TX-: J2.49 (PETp0/SATA-A+), Module1.124 (PCIe_TX_N)
/Unit 1/PCIE_nRST: J2.50 (~PERST), Module1.109 (PCIe_nRST)
/Unit 1/SD_CLK: J1.5 (CLK), Module1.57 (SD_CLK)
/Unit 1/SD_CMD: J1.3 (CMD), Module1.62 (SD_CMD)
/Unit 1/SD_DAT0: J1.7 (DAT0), Module1.63 (SD_DAT0)
/Unit 1/SD_DAT1: J1.8 (DAT1), Module1.67 (SD_DAT1)
/Unit 1/SD_DAT2: J1.1 (DAT2), Module1.69 (SD_DAT2)
/Unit 1/SD_DAT3: J1.2 (DAT3/CD), Module1.61 (SD_DAT3)
/Unit 1/SD_PWD_ON: Module1.75 (SD_PWR_ON), R9.2, U3.4 (EN)
/Unit 1/SD_PWR: C13.1, J1.4 (VDD), U3.1 (OUT)
/Unit 1/SUSCLK: J2.68 (SUSCLK), U4.4
GND: C1.1, C2.1, C3.1, C4.1, C5.1, C6.1, C8.2, C9.2, C11.2, C12.2, C13.2, C14.1, J1.6 (VSS), J1.11 (SHIELD), J2.1 (GND), J2.3 (GND), J2.9 (GND), J2.15 (GND), J2.21 (GND), J2.27 (GND), J2.33 (GND), J2.39 (GND), J2.45 (GND), J2.51 (GND), J2.57 (GND), J2.71 (GND), J2.73 (GND), J2.75 (GND), Module1.1 (GND), Module1.2 (GND), Module1.7 (GND), Module1.8 (GND), Module1.13 (GND), Module1.14 (GND), Module1.22 (GND), Module1.23 (GND), Module1.32 (GND), Module1.33 (GND), Module1.42 (GND), Module1.43 (GND), Module1.52 (GND), Module1.53 (GND), Module1.59 (GND), Module1.60 (GND), Module1.65 (GND), Module1.66 (GND), Module1.71 (GND), Module1.74 (GND), Module1.98 (GND), Module1.107 (GND), Module1.108 (GND), Module1.113 (GND), Module1.114 (GND), Module1.119 (GND), Module1.120 (GND), Module1.125 (GND), Module1.126 (GND), Module1.131 (GND), Module1.132 (GND), Module1.137 (GND), Module1.138 (GND), Module1.144 (GND), Module1.150 (GND), Module1.155 (GND), Module1.156 (GND), Module1.161 (GND), Module1.162 (GND), Module1.167 (GND), Module1.168 (GND), Module1.173 (GND), Module1.174 (GND), Module1.179 (GND), Module1.180 (GND), Module1.185 (GND), Module1.186 (GND), Module1.191 (GND), Module1.192 (GND), Module1.197 (GND), Module1.198 (GND), R5.1, R6.2, R7.1, R8.2, U1.1 (GND), U2.1 (GND), U3.2 (GND), U4.1, U4.3 (GND); also elsewhere on the board
unnamed: C7.2, R3.2
unnamed: C10.2, R4.2
unnamed: D1.1 (K), D2.1 (K), Module1.56 (GPIO3), R7.2, U2.5 (EN)
unnamed: Module1.88 (+1.8v_(Output)), Module1.90 (+1.8v_(Output))
unnamed: R3.1, U1.6 (BOOT)
unnamed: R1.2, R6.1, U1.4 (FB)
unnamed: R4.1, U2.6 (BOOT)
unnamed: R2.2, R8.1, U2.4 (FB)

Notes on the sheet:
5V @ 3A
3.3V @ 3A
microSD

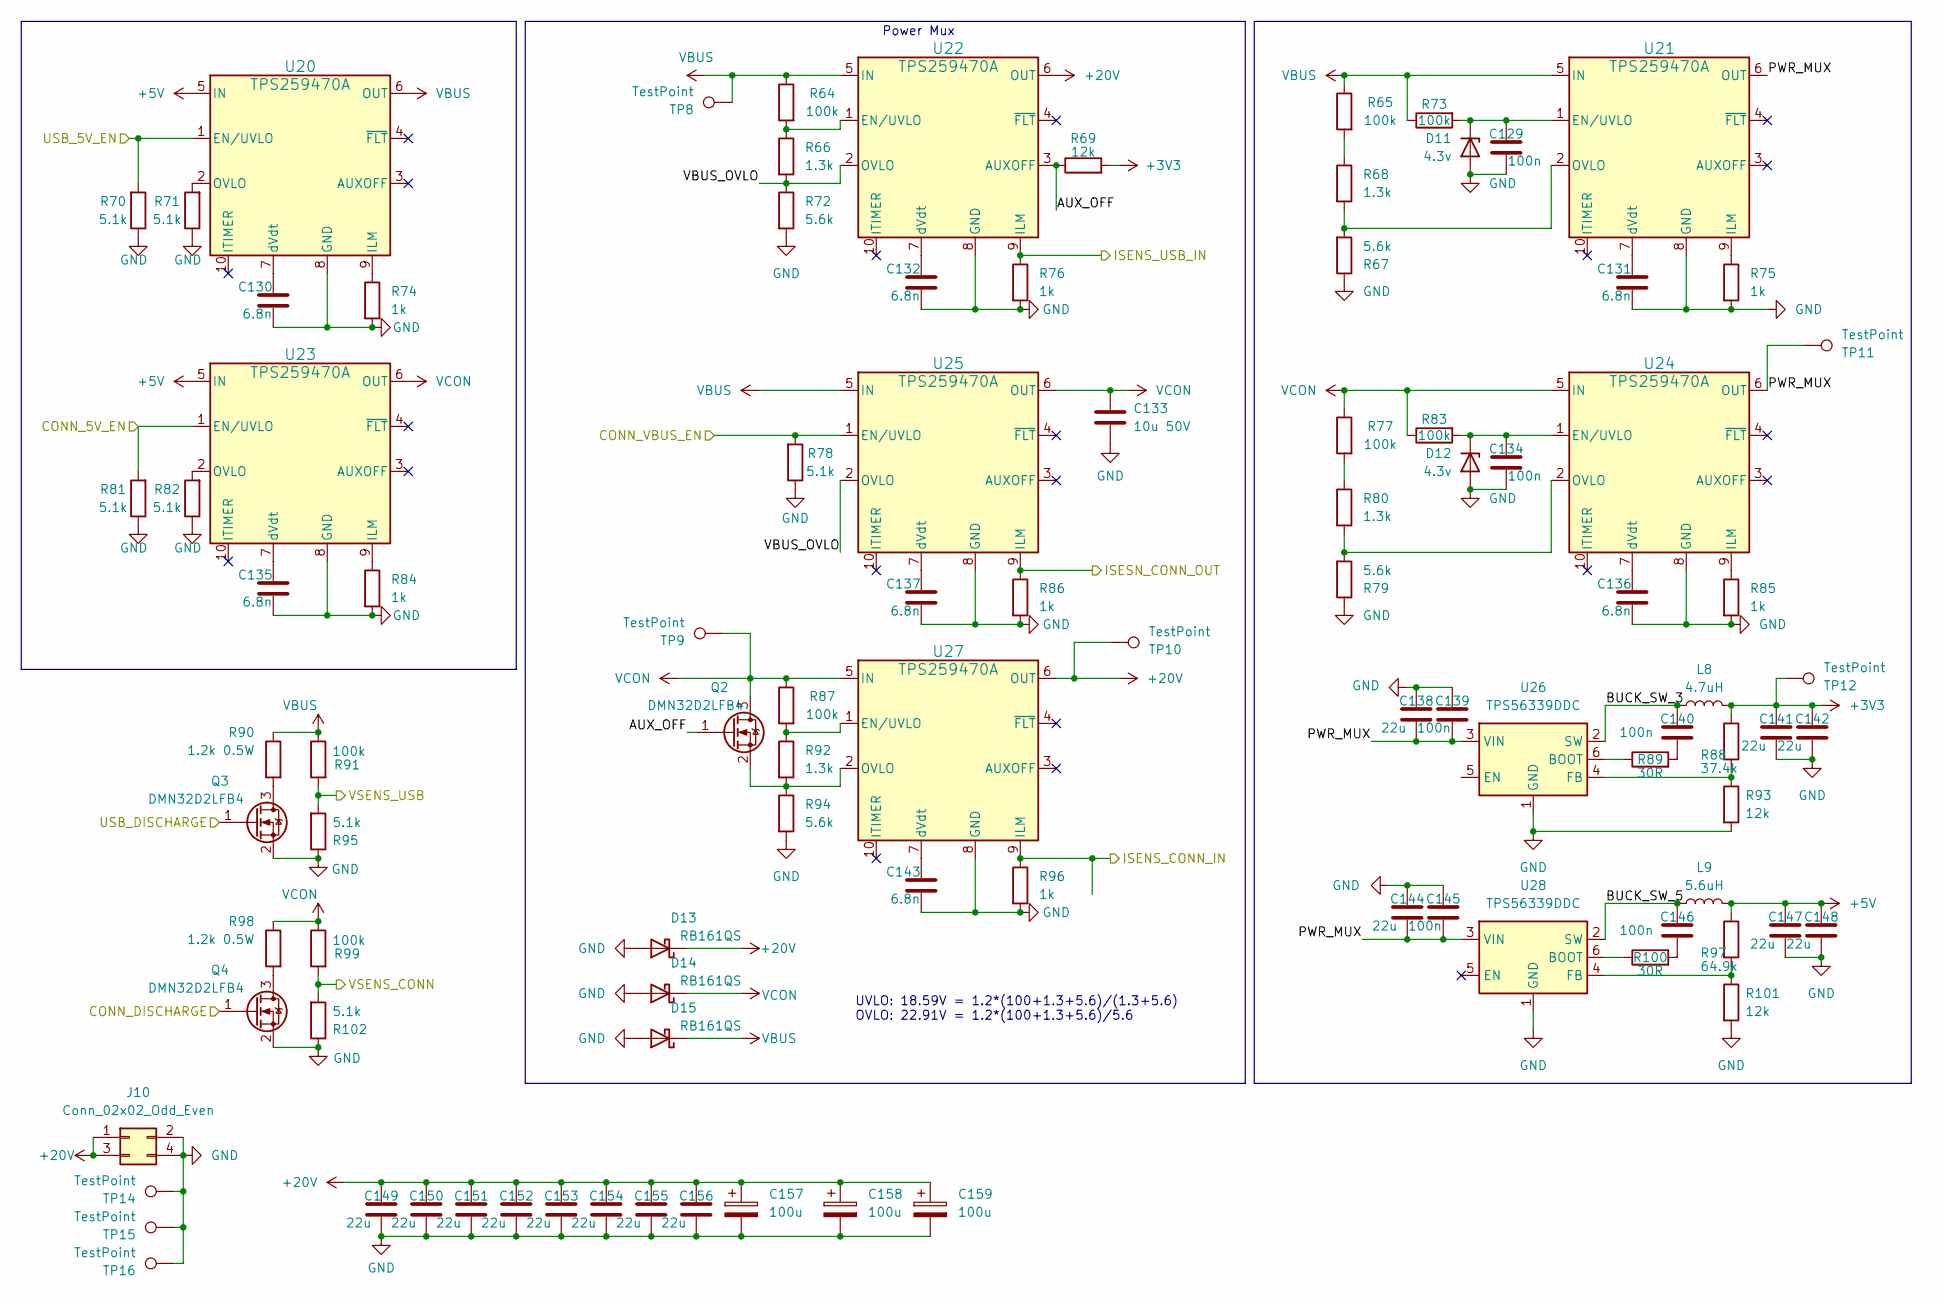
[picture p22: schematic Power.kicad_sch, Trilithon Magi]

Parts:
C129, C134, C139, C140, C145, C146: 100n; C_0402_1005Metric; MPN CL05B104KB54PNC; LCSC C307331
C130, C131, C132, C135, C136, C137, C143: 6.8n; C_0402_1005Metric; MPN GRM1555C1H682JE01D; LCSC C1518206
C133: 10u 50V; C_1210_3225Metric; MPN GCM32EC71H106KA03L; LCSC C126612
C138, C141, C142, C144, C147, C148, C149, C150, C151, C152, C153, C154, C155, C156: 22u; C_0805_2012Metric; MPN CL21A226MAQNNNE; LCSC C45783
C157, C158, C159: 100u; CP_Elec_6.3x5.7; MPN A768EB107M1ELAS036; LCSC C1517616
D11, D12: 4.3v; D_SOD-523; MPN BZX584C4V3; LCSC C46641695
D13, D14, D15: RB161QS; D_SOD-882; MPN RB161QS-40; LCSC C28646385
J10: Conn_02x02_Odd_Even; PinHeader_2x02_P2.54mm_Vertical
L8: 4.7uH; L_Changjiang_FTC404030S; MPN FTC404030S4R7MGCA; LCSC C39676083
L9: 5.6uH; L_Changjiang_FTC404030S; MPN FTC404030S5R6MBCA; LCSC C53436374
Q2, Q3, Q4: DMN32D2LFB4; Diodes_DFN1006-3; MPN DMN32D2LFB4-7; LCSC C151382
R64, R65, R73, R77, R83, R87, R91, R99: 100k; R_0402_1005Metric; MPN 0402WGF1003TCE; LCSC C25741
R66, R68, R80, R92: 1.3k; R_0402_1005Metric; MPN 0402WGF1301TCE; LCSC C25866
R67, R72, R79, R94: 5.6k; R_0402_1005Metric; MPN RC0402FR-075K6L; LCSC C409920
R69, R93, R101: 12k; R_0402_1005Metric; MPN 0402WGF1202TCE; LCSC C25752
R70, R71, R78, R81, R82, R95, R102: 5.1k; R_0402_1005Metric; MPN 0402WGF5101TCE; LCSC C25905
R74, R75, R76, R84, R85, R86, R96: 1k; R_0402_1005Metric; MPN 0402WGF1001TCE; LCSC C11702
R88: 37.4k; R_0402_1005Metric; MPN RC0402FR-0737K4L; LCSC C185422
R89, R100: 30R; R_0402_1005Metric; MPN 0402WGF300JTCE; LCSC C270617
R90, R98: 1.2k 0.5W; R_1206_3216Metric; MPN FRP1206F1201TS; LCSC C7468365
R97: 64.9k; R_0402_1005Metric; MPN ERJ2RKF6492X; LCSC C416566
TP8, TP9, TP10, TP11, TP12, TP14, TP15, TP16: TestPoint; TestPoint_Pad_D1.5mm
U20, U21, U22, U23, U24, U25, U27: TPS259470A; RPW0010A-MFG; MPN TPS259470ARPWR; LCSC C3662799
U26, U28: TPS56339DDC; SOT-23-6; MPN TPS56339DDCR; LCSC C2071106

Connections:
+3V3: C141.1, C142.1, L8.2, R69.2, R88.1, TP12.1 (1_1); also elsewhere on the board
+5V: C147.1, C148.1, L9.2, R97.1, U20.5 (IN), U23.5 (IN); also elsewhere on the board
+20V: C149.1, C150.1, C151.1, C152.1, C153.1, C154.1, C155.1, C156.1, C157.1, C158.1, C159.1, D13.1 (K), J10.1, J10.3, TP10.1 (1_1), U22.6 (OUT), U27.6 (OUT); also elsewhere on the board
/Controller/PA1: R81.2, U23.1 (EN/UVLO); also elsewhere on the board
/Controller/PA3: R70.2, U20.1 (EN/UVLO); also elsewhere on the board
/Controller/PA4_ADC1_IN4: R91.2, R95.2; also elsewhere on the board
/Controller/PB2_ADC1_IN10: R86.1, U25.9 (ILM); also elsewhere on the board
/Controller/PB10_ADC1_IN11: R99.2, R102.2; also elsewhere on the board
/Controller/PB11_ADC1_IN15: R76.1, U22.9 (ILM); also elsewhere on the board
/Controller/PB12_ADC1_IN16: R96.1, U27.9 (ILM); also elsewhere on the board
/Controller/PC9: Q4.1 (G); also elsewhere on the board
/Controller/PE8: Q3.1 (G); also elsewhere on the board
/Controller/PE12: R78.2, U25.1 (EN/UVLO); also elsewhere on the board
/Power/AUX_OFF: Q2.1 (G), R69.1, U22.3 (AUXOFF)
/Power/BUCK_SW_3: C140.1, L8.1, U26.2 (SW)
/Power/BUCK_SW_5: C146.1, L9.1, U28.2 (SW)
/Power/PWR_MUX: C138.2, C139.2, C144.2, C145.2, TP11.1 (1_1), U21.6 (OUT), U24.6 (OUT), U26.3 (VIN), U28.3 (VIN)
/Power/VBUS_OVLO: R66.2, R72.1, U22.2 (OVLO), U25.2 (OVLO)
GND: C129.2, C130.2, C131.2, C132.2, C133.2, C134.2, C135.2, C136.2, C137.2, C138.1, C139.1, C141.2, C142.2, C143.2, C144.1, C145.1, C147.2, C148.2, C149.2, C150.2, C151.2, C152.2, C153.2, C154.2, C155.2, C156.2, C157.2, C158.2, C159.2, D11.2 (A), D12.2 (A), D13.2 (A), D14.2 (A), D15.2 (A), J10.2, J10.4, Q3.2 (S), Q4.2 (S), R67.1, R70.1, R71.1, R72.2, R74.2, R75.2, R76.2, R78.1, R79.1, R81.1, R82.1, R84.2, R85.2, R86.2, R93.2, R94.2, R95.1, R96.2, R101.2, R102.1, TP14.1 (1_1), TP15.1 (1_1), TP16.1 (1_1), U20.8 (GND), U21.8 (GND), U22.8 (GND), U23.8 (GND), U24.8 (GND), U25.8 (GND), U26.1 (GND), U27.8 (GND), U28.1 (GND); also elsewhere on the board
unnamed: C140.2, R89.2
unnamed: C146.2, R100.2
unnamed: C129.1, D11.1 (K), R73.2, U21.1 (EN/UVLO)
unnamed: C134.1, D12.1 (K), R83.2, U24.1 (EN/UVLO)
unnamed: Q2.2 (S), R92.2, R94.1, U27.2 (OVLO)
unnamed: Q3.3 (D), R90.2
unnamed: Q4.3 (D), R98.2
unnamed: R65.2, R68.1
unnamed: R77.2, R80.1
unnamed: R74.1, U20.9 (ILM)
unnamed: R71.2, U20.2 (OVLO)
unnamed: C130.1, U20.7 (dVdt)
unnamed: R75.1, U21.9 (ILM)
unnamed: R67.2, R68.2, U21.2 (OVLO)
unnamed: C131.1, U21.7 (dVdt)
unnamed: R64.2, R66.1, U22.1 (EN/UVLO)
unnamed: C132.1, U22.7 (dVdt)
unnamed: R84.1, U23.9 (ILM)
unnamed: R82.2, U23.2 (OVLO)
unnamed: C135.1, U23.7 (dVdt)
unnamed: R85.1, U24.9 (ILM)
unnamed: R79.2, R80.2, U24.2 (OVLO)
unnamed: C136.1, U24.7 (dVdt)
unnamed: C137.1, U25.7 (dVdt)
unnamed: R89.1, U26.6 (BOOT)
unnamed: R88.2, R93.1, U26.4 (FB)
unnamed: R87.2, R92.1, U27.1 (EN/UVLO)
unnamed: C143.1, U27.7 (dVdt)
unnamed: R100.1, U28.6 (BOOT)
unnamed: R97.2, R101.1, U28.4 (FB)
VBUS: D15.1 (K), R64.1, R65.1, R73.1, R90.1, R91.1, TP8.1 (1_1), U20.6 (OUT), U21.5 (IN), U22.5 (IN), U25.5 (IN); also elsewhere on the board
VCON: C133.1, D14.1 (K), Q2.3 (D), R77.1, R83.1, R87.1, R98.1, R99.1, TP9.1 (1_1), U23.6 (OUT), U24.5 (IN), U25.6 (OUT), U27.5 (IN); also elsewhere on the board

Notes on the sheet:
UVLO: 18.59V = 1.2*(100+1.3+5.6)/(1.3+5.6) OVLO: 22.91V = 1.2*(100+1.3+5.6)/5.6
Power Mux
