weiiwang01/magi/Magi.kicad_pcb

## KiCad design Magi.kicad_pcb (continued)

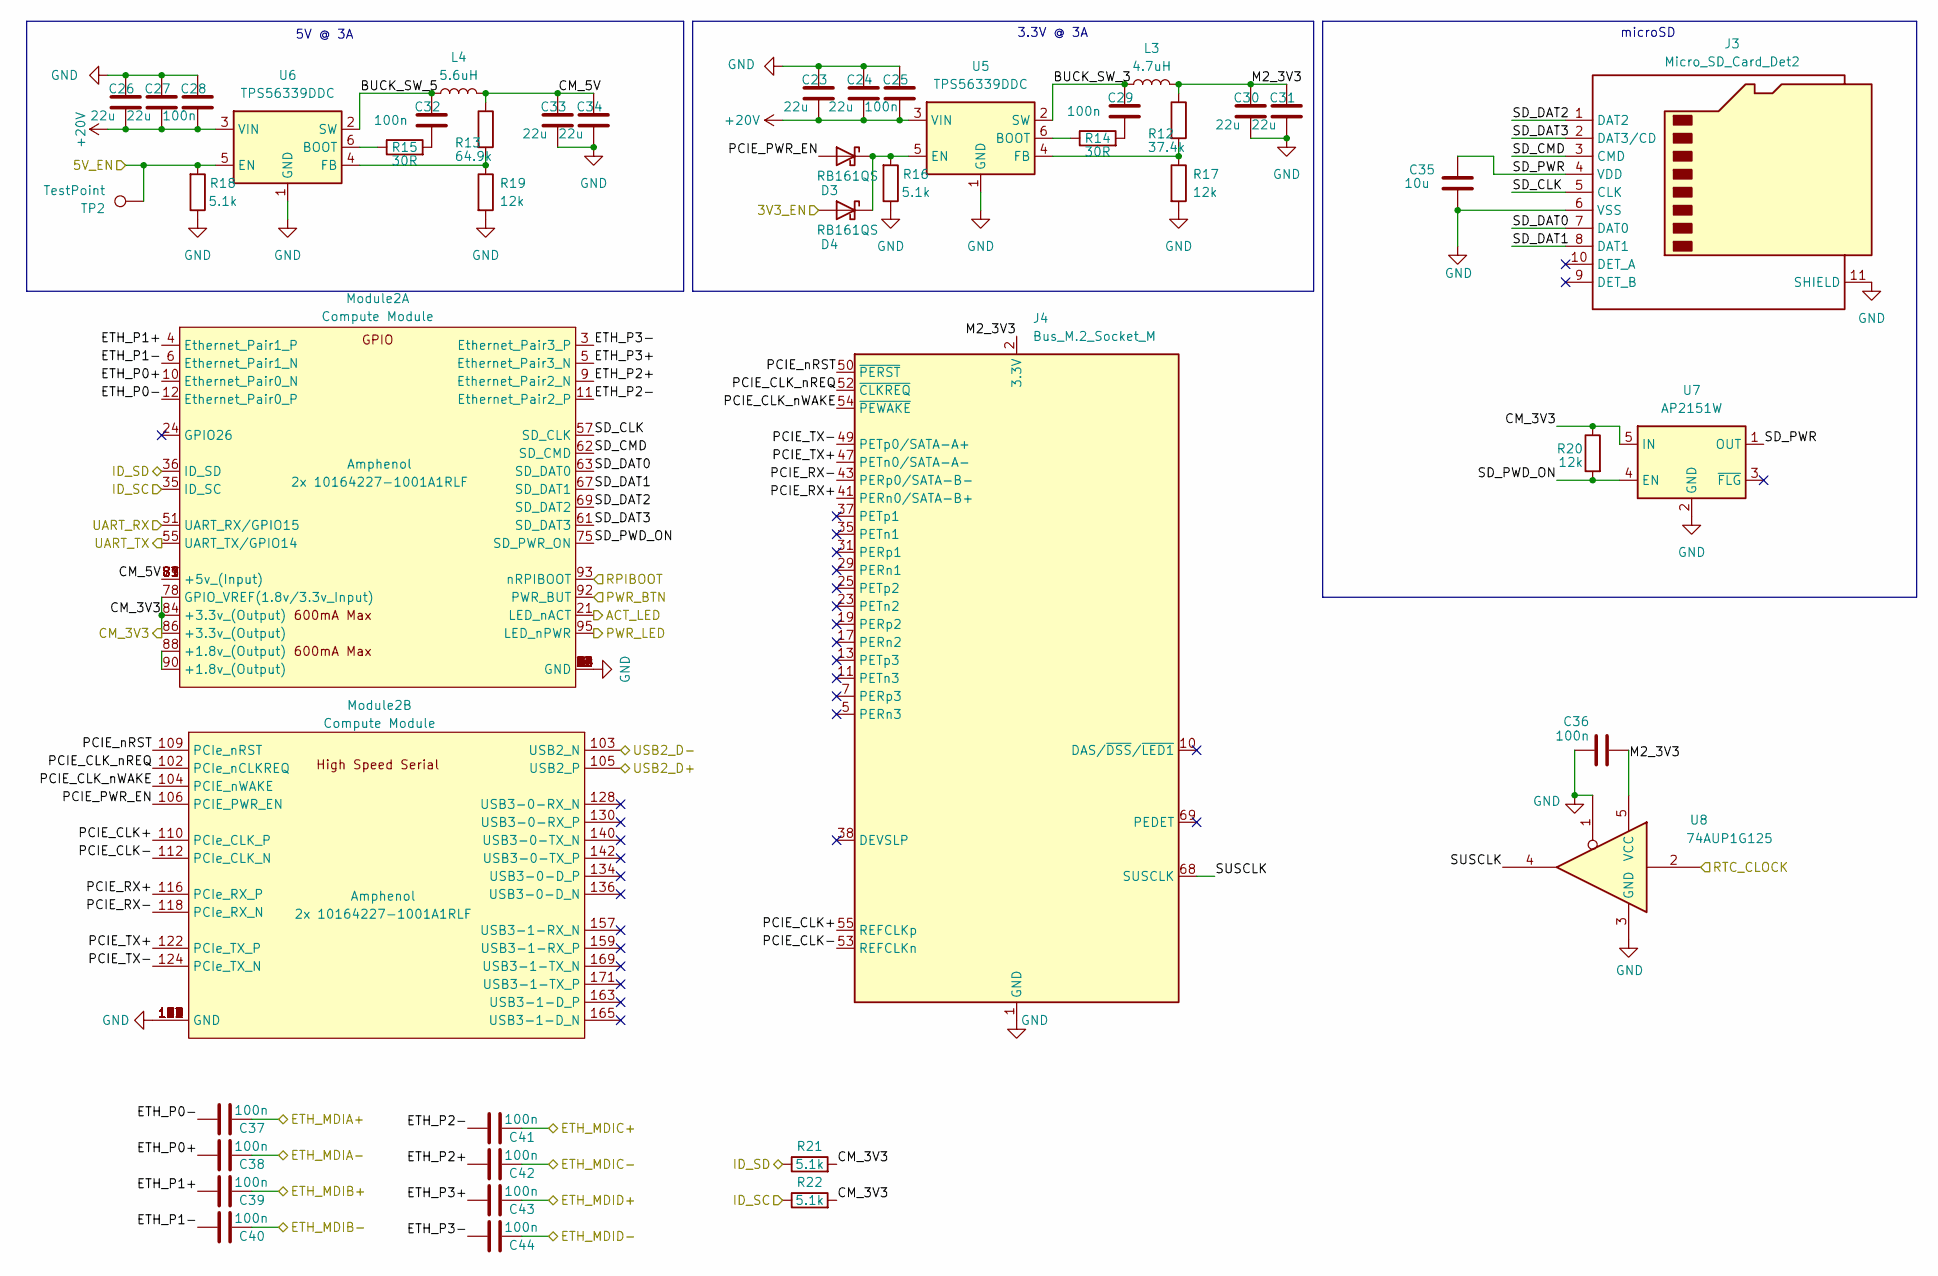
[picture p23: schematic Unit2.kicad_sch, Trilithon Magi]

Parts:
C23, C24, C26, C27, C30, C31, C33, C34: 22u; C_0805_2012Metric; MPN CL21A226MAQNNNE; LCSC C45783
C25, C28, C29, C32, C36, C37, C38, C39, C40, C41, C42, C43, C44: 100n; C_0402_1005Metric; MPN CL05B104KB54PNC; LCSC C307331
C35: 10u; C_0603_1608Metric; MPN CL10A106MA8NRNC; LCSC C96446
D3, D4: RB161QS; D_SOD-882; MPN RB161QS-40; LCSC C28646385
J3: Micro_SD_Card_Det2; SDCARD_MOLEX_503398-1892; MPN 5033981892; LCSC C428492
J4: Bus_M.2_Socket_M; CONN-SMD_APCI0146-P001A; MPN APCI0146-P001A; LCSC C841645
L3: 4.7uH; L_Changjiang_FTC404030S; MPN FTC404030S4R7MGCA; LCSC C39676083
L4: 5.6uH; L_Changjiang_FTC404030S; MPN FTC404030S5R6MBCA; LCSC C53436374
Module2: Compute Module; Raspberry-Pi-4-Compute-Module
R12: 37.4k; R_0402_1005Metric; MPN RC0402FR-0737K4L; LCSC C185422
R13: 64.9k; R_0402_1005Metric; MPN ERJ2RKF6492X; LCSC C416566
R14, R15: 30R; R_0402_1005Metric; MPN 0402WGF300JTCE; LCSC C270617
R16, R18, R21, R22: 5.1k; R_0402_1005Metric; MPN 0402WGF5101TCE; LCSC C25905
R17, R19, R20: 12k; R_0402_1005Metric; MPN 0402WGF1202TCE; LCSC C25752
TP2: TestPoint; TestPoint_Pad_D1.5mm
U5, U6: TPS56339DDC; SOT-23-6; MPN TPS56339DDCR; LCSC C2071106
U7: AP2151W; SOT-23-5; MPN AP2151WG-7; LCSC C110464
U8: 74AUP1G125; Texas_X2SON-5_0.8x0.8mm_P0.48mm; MPN SN74AUP1G125DPWR; LCSC C2861319

Connections:
+20V: C23.2, C24.2, C25.2, C26.2, C27.2, C28.2, U5.3 (VIN), U6.3 (VIN); also elsewhere on the board
/Controller/HUB_USB2_2_D+: Module2.103 (USB2_N); also elsewhere on the board
/Controller/HUB_USB2_2_D-: Module2.105 (USB2_P); also elsewhere on the board
/Controller/PA6_I2C3_SDA: Module2.36 (ID_SD), R21.1; also elsewhere on the board
/Controller/PA7_I2C3_SCL: Module2.35 (ID_SC), R22.1; also elsewhere on the board
/Controller/PB1: Module2.21 (LED_nACT); also elsewhere on the board
/Controller/PC4_USART1_TX: Module2.51 (UART_RX/GPIO15); also elsewhere on the board
/Controller/PC5_USART1_RX: Module2.55 (UART_TX/GPIO14); also elsewhere on the board
/Controller/PD4: D4.2 (A); also elsewhere on the board
/Controller/PE7: Module2.95 (LED_nPWR); also elsewhere on the board
/Controller/PE13: R18.2, TP2.1 (1_1), U6.5 (EN); also elsewhere on the board
/Controller/PF6: Module2.92 (PWR_BUT); also elsewhere on the board
/Controller/PF7: Module2.93 (nRPIBOOT); also elsewhere on the board
/Ethernet Switch/P1MDIA+: C39.1; also elsewhere on the board
/Ethernet Switch/P1MDIA-: C40.1; also elsewhere on the board
/Ethernet Switch/P1MDIB+: C38.1; also elsewhere on the board
/Ethernet Switch/P1MDIB-: C37.1; also elsewhere on the board
/Ethernet Switch/P1MDIC+: C44.1; also elsewhere on the board
/Ethernet Switch/P1MDIC-: C43.1; also elsewhere on the board
/Ethernet Switch/P1MDID+: C42.1; also elsewhere on the board
/Ethernet Switch/P1MDID-: C41.1; also elsewhere on the board
/LSCO: U8.2; also elsewhere on the board
/Unit 2/BUCK_SW_3: C29.1, L3.1, U5.2 (SW)
/Unit 2/BUCK_SW_5: C32.1, L4.1, U6.2 (SW)
/Unit 2/CM_3V3: Module2.78 (GPIO_VREF(1.8v/3.3v_Input)), Module2.84 (+3.3v_(Output)), Module2.86 (+3.3v_(Output)), R20.1, R21.2, R22.2, U7.5 (IN); also elsewhere on the board
/Unit 2/CM_5V: C33.1, C34.1, L4.2, Module2.77 (+5v_(Input)), Module2.79 (+5v_(Input)), Module2.81 (+5v_(Input)), Module2.83 (+5v_(Input)), Module2.85 (+5v_(Input)), Module2.87 (+5v_(Input)), R13.1
/Unit 2/ETH_P0+: C38.2, Module2.10 (Ethernet_Pair0_N)
/Unit 2/ETH_P0-: C37.2, Module2.12 (Ethernet_Pair0_P)
/Unit 2/ETH_P1+: C39.2, Module2.4 (Ethernet_Pair1_P)
/Unit 2/ETH_P1-: C40.2, Module2.6 (Ethernet_Pair1_N)
/Unit 2/ETH_P2+: C42.2, Module2.9 (Ethernet_Pair2_N)
/Unit 2/ETH_P2-: C41.2, Module2.11 (Ethernet_Pair2_P)
/Unit 2/ETH_P3+: C43.2, Module2.5 (Ethernet_Pair3_N)
/Unit 2/ETH_P3-: C44.2, Module2.3 (Ethernet_Pair3_P)
/Unit 2/M2_3V3: C30.1, C31.1, C36.2, J4.2 (3.3V), J4.4 (3.3V), J4.12 (3.3V), J4.14 (3.3V), J4.16 (3.3V), J4.18 (3.3V), J4.70 (3.3V), J4.72 (3.3V), J4.74 (3.3V), L3.2, R12.1, U8.5 (VCC)
/Unit 2/PCIE_CLK+: J4.55 (REFCLKp), Module2.110 (PCIe_CLK_P)
/Unit 2/PCIE_CLK-: J4.53 (REFCLKn), Module2.112 (PCIe_CLK_N)
/Unit 2/PCIE_CLK_nREQ: J4.52 (~CLKREQ), Module2.102 (PCIe_nCLKREQ)
/Unit 2/PCIE_CLK_nWAKE: J4.54 (~PEWAKE), Module2.104 (PCIE_nWAKE)
/Unit 2/PCIE_PWR_EN: D3.2 (A), Module2.106 (PCIE_PWR_EN)
/Unit 2/PCIE_RX+: J4.41 (PERn0/SATA-B+), Module2.116 (PCIe_RX_P)
/Unit 2/PCIE_RX-: J4.43 (PERp0/SATA-B-), Module2.118 (PCIe_RX_N)
/Unit 2/PCIE_TX+: J4.47 (PETn0/SATA-A-), Module2.122 (PCIe_TX_P)
/Unit 2/PCIE_TX-: J4.49 (PETp0/SATA-A+), Module2.124 (PCIe_TX_N)
/Unit 2/PCIE_nRST: J4.50 (~PERST), Module2.109 (PCIe_nRST)
/Unit 2/SD_CLK: J3.5 (CLK), Module2.57 (SD_CLK)
/Unit 2/SD_CMD: J3.3 (CMD), Module2.62 (SD_CMD)
/Unit 2/SD_DAT0: J3.7 (DAT0), Module2.63 (SD_DAT0)
/Unit 2/SD_DAT1: J3.8 (DAT1), Module2.67 (SD_DAT1)
/Unit 2/SD_DAT2: J3.1 (DAT2), Module2.69 (SD_DAT2)
/Unit 2/SD_DAT3: J3.2 (DAT3/CD), Module2.61 (SD_DAT3)
/Unit 2/SD_PWD_ON: Module2.75 (SD_PWR_ON), R20.2, U7.4 (EN)
/Unit 2/SD_PWR: C35.1, J3.4 (VDD), U7.1 (OUT)
/Unit 2/SUSCLK: J4.68 (SUSCLK), U8.4
GND: C23.1, C24.1, C25.1, C26.1, C27.1, C28.1, C30.2, C31.2, C33.2, C34.2, C35.2, C36.1, J3.6 (VSS), J3.11 (SHIELD), J4.1 (GND), J4.3 (GND), J4.9 (GND), J4.15 (GND), J4.21 (GND), J4.27 (GND), J4.33 (GND), J4.39 (GND), J4.45 (GND), J4.51 (GND), J4.57 (GND), J4.71 (GND), J4.73 (GND), J4.75 (GND), Module2.1 (GND), Module2.2 (GND), Module2.7 (GND), Module2.8 (GND), Module2.13 (GND), Module2.14 (GND), Module2.22 (GND), Module2.23 (GND), Module2.32 (GND), Module2.33 (GND), Module2.42 (GND), Module2.43 (GND), Module2.52 (GND), Module2.53 (GND), Module2.59 (GND), Module2.60 (GND), Module2.65 (GND), Module2.66 (GND), Module2.71 (GND), Module2.74 (GND), Module2.98 (GND), Module2.107 (GND), Module2.108 (GND), Module2.113 (GND), Module2.114 (GND), Module2.119 (GND), Module2.120 (GND), Module2.125 (GND), Module2.126 (GND), Module2.131 (GND), Module2.132 (GND), Module2.137 (GND), Module2.138 (GND), Module2.144 (GND), Module2.150 (GND), Module2.155 (GND), Module2.156 (GND), Module2.161 (GND), Module2.162 (GND), Module2.167 (GND), Module2.168 (GND), Module2.173 (GND), Module2.174 (GND), Module2.179 (GND), Module2.180 (GND), Module2.185 (GND), Module2.186 (GND), Module2.191 (GND), Module2.192 (GND), Module2.197 (GND), Module2.198 (GND), R16.1, R17.2, R18.1, R19.2, U5.1 (GND), U6.1 (GND), U7.2 (GND), U8.1, U8.3 (GND); also elsewhere on the board
unnamed: C29.2, R14.2
unnamed: C32.2, R15.2
unnamed: D3.1 (K), D4.1 (K), R16.2, U5.5 (EN)
unnamed: Module2.88 (+1.8v_(Output)), Module2.90 (+1.8v_(Output))
unnamed: R14.1, U5.6 (BOOT)
unnamed: R12.2, R17.1, U5.4 (FB)
unnamed: R15.1, U6.6 (BOOT)
unnamed: R13.2, R19.1, U6.4 (FB)

Notes on the sheet:
microSD
5V @ 3A
3.3V @ 3A

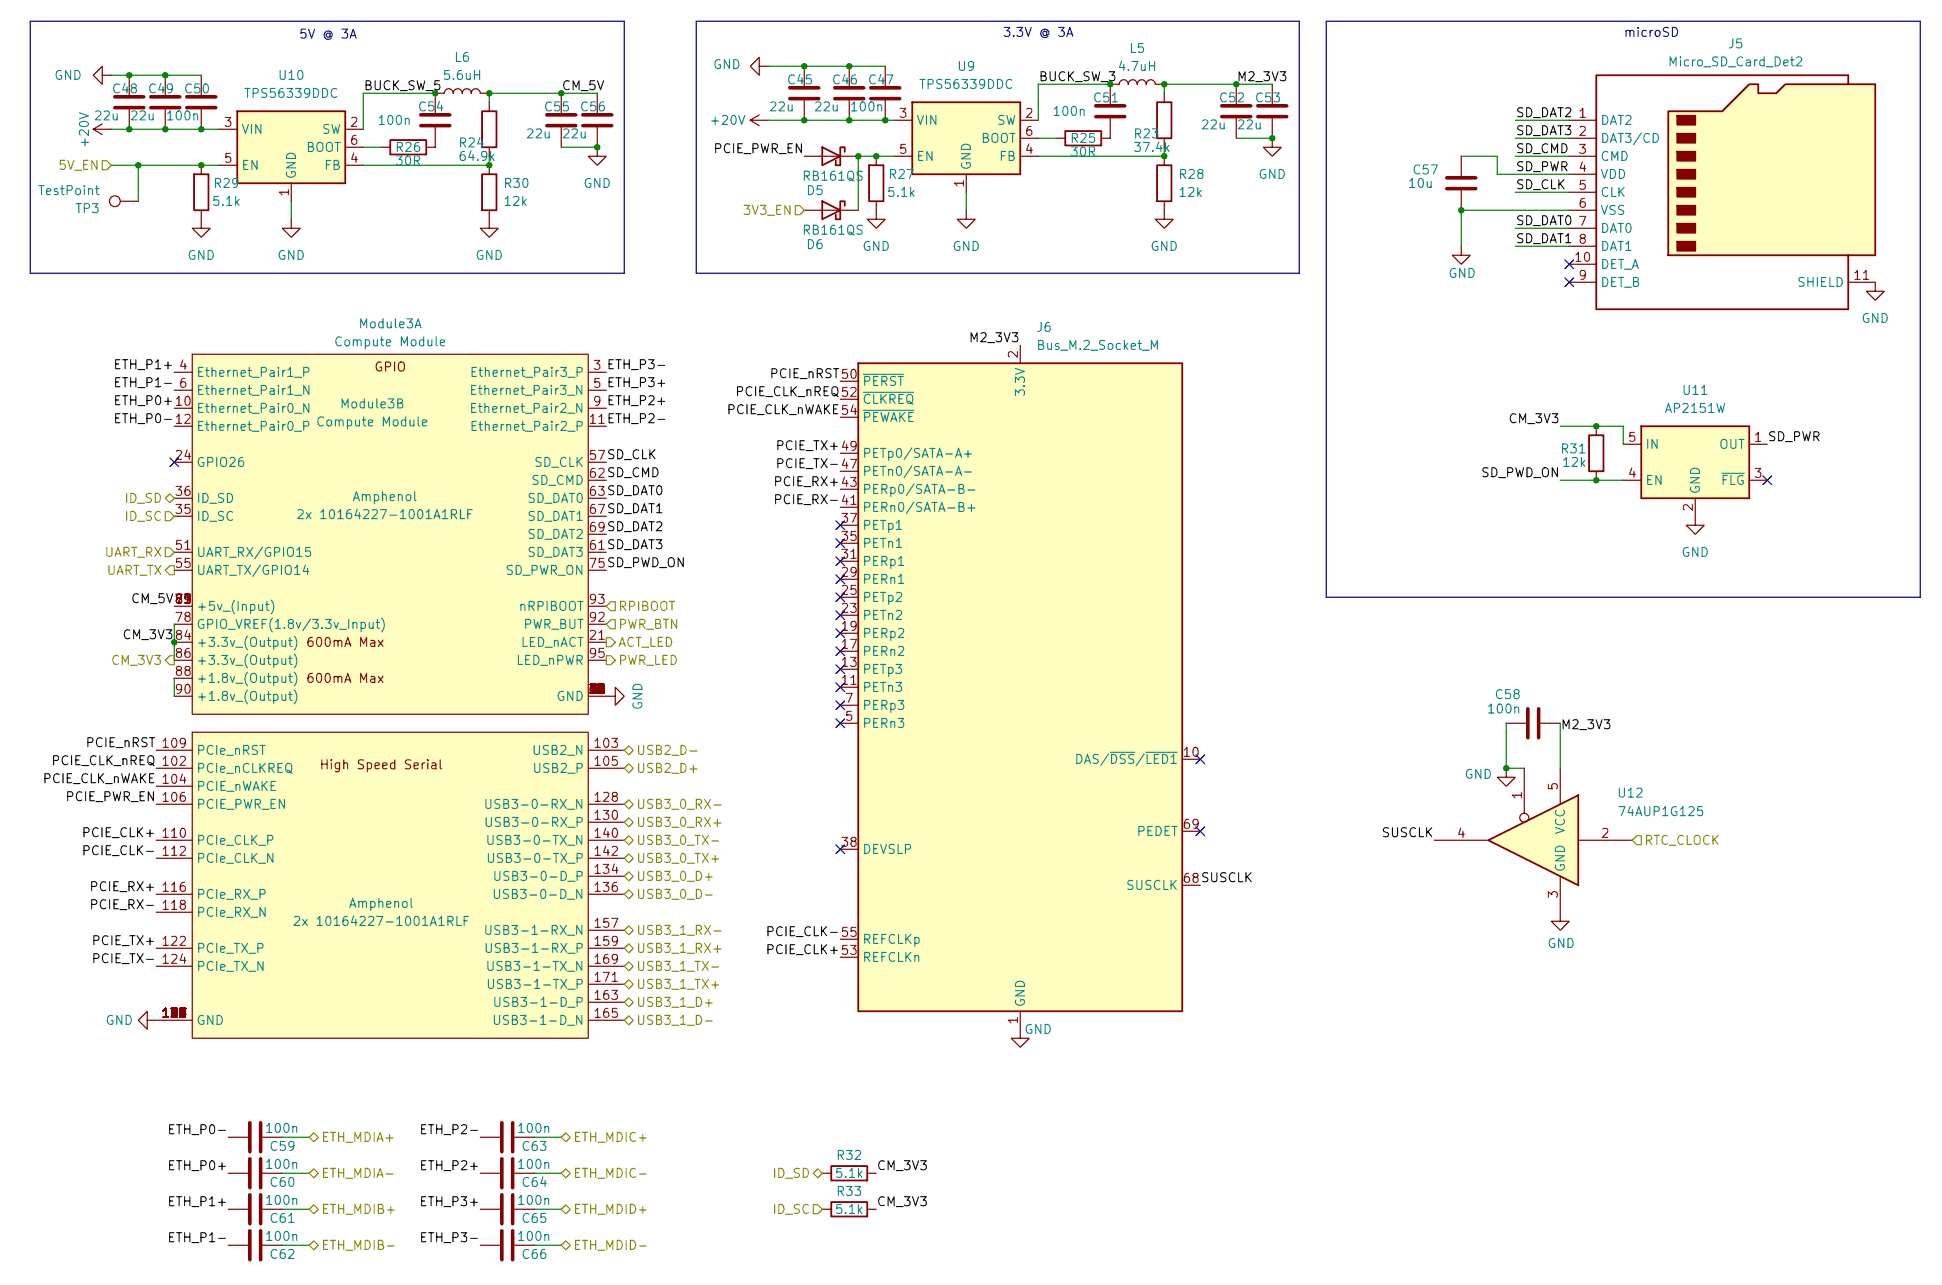
[picture p24: schematic Unit3.kicad_sch, Trilithon Magi]

Parts:
C45, C46, C48, C49, C52, C53, C55, C56: 22u; C_0805_2012Metric; MPN CL21A226MAQNNNE; LCSC C45783
C47, C50, C51, C54, C58, C59, C60, C61, C62, C63, C64, C65, C66: 100n; C_0402_1005Metric; MPN CL05B104KB54PNC; LCSC C307331
C57: 10u; C_0603_1608Metric; MPN CL10A106MA8NRNC; LCSC C96446
D5, D6: RB161QS; D_SOD-882; MPN RB161QS-40; LCSC C28646385
J5: Micro_SD_Card_Det2; SDCARD_MOLEX_503398-1892; MPN 5033981892; LCSC C428492
J6: Bus_M.2_Socket_M; CONN-SMD_APCI0146-P001A; MPN APCI0146-P001A; LCSC C841645
L5: 4.7uH; L_Changjiang_FTC404030S; MPN FTC404030S4R7MGCA; LCSC C39676083
L6: 5.6uH; L_Changjiang_FTC404030S; MPN FTC404030S5R6MBCA; LCSC C53436374
Module3: Compute Module; Raspberry-Pi-4-Compute-Module
R23: 37.4k; R_0402_1005Metric; MPN RC0402FR-0737K4L; LCSC C185422
R24: 64.9k; R_0402_1005Metric; MPN ERJ2RKF6492X; LCSC C416566
R25, R26: 30R; R_0402_1005Metric; MPN 0402WGF300JTCE; LCSC C270617
R27, R29, R32, R33: 5.1k; R_0402_1005Metric; MPN 0402WGF5101TCE; LCSC C25905
R28, R30, R31: 12k; R_0402_1005Metric; MPN 0402WGF1202TCE; LCSC C25752
TP3: TestPoint; TestPoint_Pad_D1.5mm
U9, U10: TPS56339DDC; SOT-23-6; MPN TPS56339DDCR; LCSC C2071106
U11: AP2151W; SOT-23-5; MPN AP2151WG-7; LCSC C110464
U12: 74AUP1G125; Texas_X2SON-5_0.8x0.8mm_P0.48mm; MPN SN74AUP1G125DPWR; LCSC C2861319

Connections:
+20V: C45.2, C46.2, C47.2, C48.2, C49.2, C50.2, U9.3 (VIN), U10.3 (VIN); also elsewhere on the board
/Controller/HUB_USB2_3_D+: Module3.105 (USB2_P); also elsewhere on the board
/Controller/HUB_USB2_3_D-: Module3.103 (USB2_N); also elsewhere on the board
/Controller/PB13_I2C2_SCL: Module3.35 (ID_SC), R33.1; also elsewhere on the board
/Controller/PB14_I2C2_SDA: Module3.36 (ID_SD), R32.1; also elsewhere on the board
/Controller/PD8_USART3_TX: Module3.51 (UART_RX/GPIO15); also elsewhere on the board
/Controller/PD9_USART3_RX: Module3.55 (UART_TX/GPIO14); also elsewhere on the board
/Controller/PD13: R29.2, TP3.1 (1_1), U10.5 (EN); also elsewhere on the board
/Controller/PD14: Module3.92 (PWR_BUT); also elsewhere on the board
/Controller/PD15: Module3.95 (LED_nPWR); also elsewhere on the board
/Controller/PE14: D6.2 (A); also elsewhere on the board
/Controller/PE15: Module3.21 (LED_nACT); also elsewhere on the board
/Controller/PF8: Module3.93 (nRPIBOOT); also elsewhere on the board
/Ethernet Switch/P2MDIA+: C62.1; also elsewhere on the board
/Ethernet Switch/P2MDIA-: C61.1; also elsewhere on the board
/Ethernet Switch/P2MDIB+: C60.1; also elsewhere on the board
/Ethernet Switch/P2MDIB-: C59.1; also elsewhere on the board
/Ethernet Switch/P2MDIC+: C66.1; also elsewhere on the board
/Ethernet Switch/P2MDIC-: C65.1; also elsewhere on the board
/Ethernet Switch/P2MDID+: C63.1; also elsewhere on the board
/Ethernet Switch/P2MDID-: C64.1; also elsewhere on the board
/Interconnect/USB_D+: Module3.134 (USB3-0-D_P); also elsewhere on the board
/Interconnect/USB_D-: Module3.136 (USB3-0-D_N); also elsewhere on the board
/Interconnect/USB_SS_RX+: Module3.128 (USB3-0-RX_N); also elsewhere on the board
/Interconnect/USB_SS_RX-: Module3.130 (USB3-0-RX_P); also elsewhere on the board
/Interconnect/USB_SS_TX+: Module3.142 (USB3-0-TX_P); also elsewhere on the board
/Interconnect/USB_SS_TX-: Module3.140 (USB3-0-TX_N); also elsewhere on the board
/LSCO: U12.2; also elsewhere on the board
/USB/USB_D+: Module3.163 (USB3-1-D_P); also elsewhere on the board
/USB/USB_D-: Module3.165 (USB3-1-D_N); also elsewhere on the board
/USB/USB_SS_RX+: Module3.159 (USB3-1-RX_P); also elsewhere on the board
/USB/USB_SS_RX-: Module3.157 (USB3-1-RX_N); also elsewhere on the board
/USB/USB_SS_TX+: Module3.171 (USB3-1-TX_P); also elsewhere on the board
/USB/USB_SS_TX-: Module3.169 (USB3-1-TX_N); also elsewhere on the board
/Unit 3/BUCK_SW_3: C51.1, L5.1, U9.2 (SW)
/Unit 3/BUCK_SW_5: C54.1, L6.1, U10.2 (SW)
/Unit 3/CM_3V3: Module3.78 (GPIO_VREF(1.8v/3.3v_Input)), Module3.84 (+3.3v_(Output)), Module3.86 (+3.3v_(Output)), R31.1, R32.2, R33.2, U11.5 (IN); also elsewhere on the board
/Unit 3/CM_5V: C55.1, C56.1, L6.2, Module3.77 (+5v_(Input)), Module3.79 (+5v_(Input)), Module3.81 (+5v_(Input)), Module3.83 (+5v_(Input)), Module3.85 (+5v_(Input)), Module3.87 (+5v_(Input)), R24.1
/Unit 3/ETH_P0+: C60.2, Module3.10 (Ethernet_Pair0_N)
/Unit 3/ETH_P0-: C59.2, Module3.12 (Ethernet_Pair0_P)
/Unit 3/ETH_P1+: C61.2, Module3.4 (Ethernet_Pair1_P)
/Unit 3/ETH_P1-: C62.2, Module3.6 (Ethernet_Pair1_N)
/Unit 3/ETH_P2+: C64.2, Module3.9 (Ethernet_Pair2_N)
/Unit 3/ETH_P2-: C63.2, Module3.11 (Ethernet_Pair2_P)
/Unit 3/ETH_P3+: C65.2, Module3.5 (Ethernet_Pair3_N)
/Unit 3/ETH_P3-: C66.2, Module3.3 (Ethernet_Pair3_P)
/Unit 3/M2_3V3: C52.1, C53.1, C58.2, J6.2 (3.3V), J6.4 (3.3V), J6.12 (3.3V), J6.14 (3.3V), J6.16 (3.3V), J6.18 (3.3V), J6.70 (3.3V), J6.72 (3.3V), J6.74 (3.3V), L5.2, R23.1, U12.5 (VCC)
/Unit 3/PCIE_CLK+: J6.53 (REFCLKn), Module3.110 (PCIe_CLK_P)
/Unit 3/PCIE_CLK-: J6.55 (REFCLKp), Module3.112 (PCIe_CLK_N)
/Unit 3/PCIE_CLK_nREQ: J6.52 (~CLKREQ), Module3.102 (PCIe_nCLKREQ)
/Unit 3/PCIE_CLK_nWAKE: J6.54 (~PEWAKE), Module3.104 (PCIE_nWAKE)
/Unit 3/PCIE_PWR_EN: D5.2 (A), Module3.106 (PCIE_PWR_EN)
/Unit 3/PCIE_RX+: J6.43 (PERp0/SATA-B-), Module3.116 (PCIe_RX_P)
/Unit 3/PCIE_RX-: J6.41 (PERn0/SATA-B+), Module3.118 (PCIe_RX_N)
/Unit 3/PCIE_TX+: J6.49 (PETp0/SATA-A+), Module3.122 (PCIe_TX_P)
/Unit 3/PCIE_TX-: J6.47 (PETn0/SATA-A-), Module3.124 (PCIe_TX_N)
/Unit 3/PCIE_nRST: J6.50 (~PERST), Module3.109 (PCIe_nRST)
/Unit 3/SD_CLK: J5.5 (CLK), Module3.57 (SD_CLK)
/Unit 3/SD_CMD: J5.3 (CMD), Module3.62 (SD_CMD)
/Unit 3/SD_DAT0: J5.7 (DAT0), Module3.63 (SD_DAT0)
/Unit 3/SD_DAT1: J5.8 (DAT1), Module3.67 (SD_DAT1)
/Unit 3/SD_DAT2: J5.1 (DAT2), Module3.69 (SD_DAT2)
/Unit 3/SD_DAT3: J5.2 (DAT3/CD), Module3.61 (SD_DAT3)
/Unit 3/SD_PWD_ON: Module3.75 (SD_PWR_ON), R31.2, U11.4 (EN)
/Unit 3/SD_PWR: C57.1, J5.4 (VDD), U11.1 (OUT)
/Unit 3/SUSCLK: J6.68 (SUSCLK), U12.4
GND: C45.1, C46.1, C47.1, C48.1, C49.1, C50.1, C52.2, C53.2, C55.2, C56.2, C57.2, C58.1, J5.6 (VSS), J5.11 (SHIELD), J6.1 (GND), J6.3 (GND), J6.9 (GND), J6.15 (GND), J6.21 (GND), J6.27 (GND), J6.33 (GND), J6.39 (GND), J6.45 (GND), J6.51 (GND), J6.57 (GND), J6.71 (GND), J6.73 (GND), J6.75 (GND), Module3.1 (GND), Module3.2 (GND), Module3.7 (GND), Module3.8 (GND), Module3.13 (GND), Module3.14 (GND), Module3.22 (GND), Module3.23 (GND), Module3.32 (GND), Module3.33 (GND), Module3.42 (GND), Module3.43 (GND), Module3.52 (GND), Module3.53 (GND), Module3.56 (GPIO3), Module3.58 (GPIO2), Module3.59 (GND), Module3.60 (GND), Module3.65 (GND), Module3.66 (GND), Module3.71 (GND), Module3.74 (GND), Module3.98 (GND), Module3.107 (GND), Module3.108 (GND), Module3.113 (GND), Module3.114 (GND), Module3.119 (GND), Module3.120 (GND), Module3.125 (GND), Module3.126 (GND), Module3.131 (GND), Module3.132 (GND), Module3.137 (GND), Module3.138 (GND), Module3.144 (GND), Module3.150 (GND), Module3.155 (GND), Module3.156 (GND), Module3.161 (GND), Module3.162 (GND), Module3.167 (GND), Module3.168 (GND), Module3.173 (GND), Module3.174 (GND), Module3.179 (GND), Module3.180 (GND), Module3.185 (GND), Module3.186 (GND), Module3.191 (GND), Module3.192 (GND), Module3.197 (GND), Module3.198 (GND), R27.1, R28.2, R29.1, R30.2, U9.1 (GND), U10.1 (GND), U11.2 (GND), U12.1, U12.3 (GND); also elsewhere on the board
unnamed: C51.2, R25.2
unnamed: C54.2, R26.2
unnamed: D5.1 (K), D6.1 (K), R27.2, U9.5 (EN)
unnamed: Module3.88 (+1.8v_(Output)), Module3.90 (+1.8v_(Output))
unnamed: R25.1, U9.6 (BOOT)
unnamed: R23.2, R28.1, U9.4 (FB)
unnamed: R26.1, U10.6 (BOOT)
unnamed: R24.2, R30.1, U10.4 (FB)

Notes on the sheet:
microSD
3.3V @ 3A
5V @ 3A

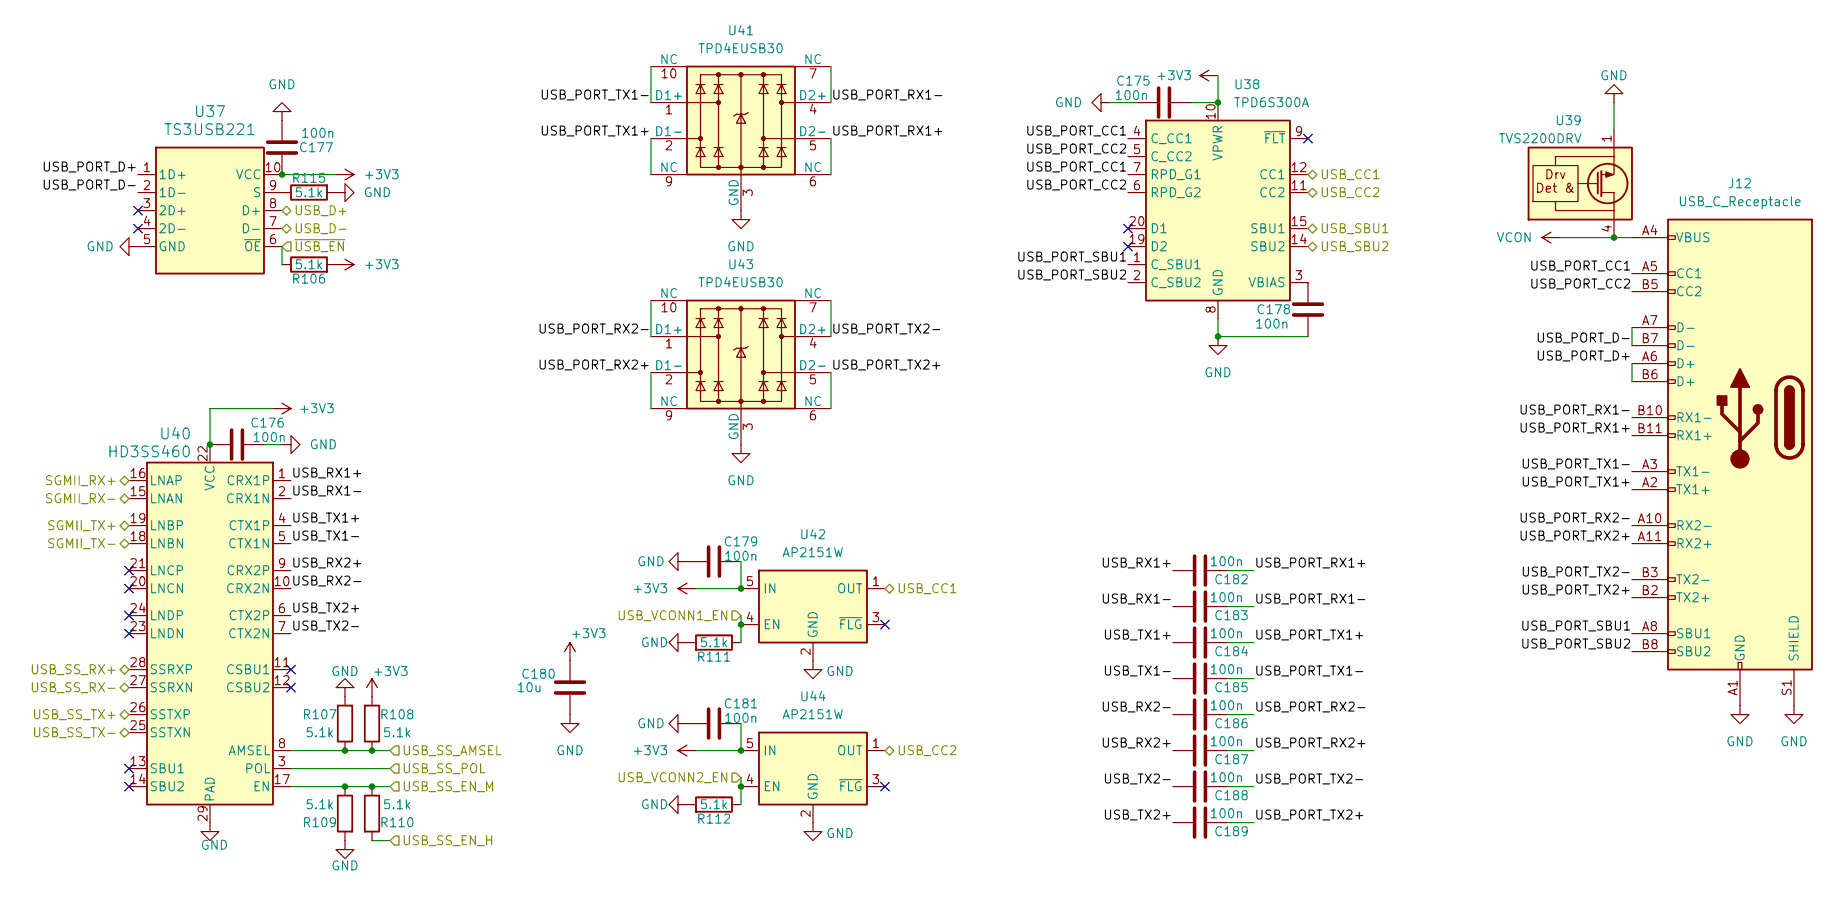
[picture p25: schematic Connector.kicad_sch, Trilithon Magi]

Parts:
C175, C176, C177, C178, C179, C181, C182, C183, C184, C185, C186, C187, C188, C189: 100n; C_0402_1005Metric; MPN CL05B104KB54PNC; LCSC C307331
C180: 10u; C_0603_1608Metric; MPN CL10A106MA8NRNC; LCSC C96446
J12: USB_C_Receptacle; USB-C-SMD_TYPE-C-GT-USB-7007C; MPN GT-USB-9007A; LCSC C48533148
R106, R107, R108, R109, R110, R111, R112, R115: 5.1k; R_0402_1005Metric; MPN 0402WGF5101TCE; LCSC C25905
U37: TS3USB221; Texas_UQFN-10_1.5x2mm_P0.5mm; MPN TS3USB221ARSER; LCSC C128396
U38: TPD6S300A; WQFN-20-1EP_3x3mm_P0.4mm_EP1.7x1.7mm_ThermalVias; MPN TPD6S300A; LCSC C2876380
U39: TVS2200DRV; WSON-6-1EP_2x2mm_P0.65mm_EP1x1.6mm; MPN TVS2200DRVR; LCSC C523793
U40: HD3SS460; WQFN-28-1EP_3.5x5.5mm_P0.5mm_EP2.05x4.05mm_ThermalVias_Sing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; MPN HD3SS460RHRT; LCSC C2150882
U41, U43: TPD4EUSB30; USON-10_2.5x1.0mm_P0.5mm; MPN TPD4EUSB30DQAR; LCSC C90627
U42, U44: AP2151W; SOT-23-5; MPN AP2151WG-7; LCSC C110464

Connections:
+3V3: C175.1, C176.1, C177.1, C179.1, C180.1, C181.1, R106.2, R108.2, U37.10 (VCC), U38.10 (VPWR), U40.22 (VCC), U42.5 (IN), U44.5 (IN); also elsewhere on the board
/Controller/PA15: R112.1, U44.4 (EN); also elsewhere on the board
/Controller/PC1: R106.1, U37.6 (~OE); also elsewhere on the board
/Controller/PC8: R111.1, U42.4 (EN); also elsewhere on the board
/Controller/PC13: U40.3 (POL); also elsewhere on the board
/Controller/PD5_USART2_TX: U38.14 (SBU2); also elsewhere on the board
/Controller/PD6_USART2_RX: U38.15 (SBU1); also elsewhere on the board
/Controller/PF0: R107.1, R108.1, U40.8 (AMSEL); also elsewhere on the board
/Controller/PF4: R109.1, R110.1, U40.17 (EN); also elsewhere on the board
/Controller/PF5: R110.2; also elsewhere on the board
/Controller/UCPD2_CC1: U38.12 (CC1), U42.1 (OUT); also elsewhere on the board
/Controller/UCPD2_CC2: U38.11 (CC2), U44.1 (OUT); also elsewhere on the board
/Ethernet Switch/SGMII_RX+: U40.16 (LNAP); also elsewhere on the board
/Ethernet Switch/SGMII_RX-: U40.15 (LNAN); also elsewhere on the board
/Ethernet Switch/SGMII_TX+: U40.19 (LNBP); also elsewhere on the board
/Ethernet Switch/SGMII_TX-: U40.18 (LNBN); also elsewhere on the board
/Interconnect/USB_D+: U37.8 (D+); also elsewhere on the board
/Interconnect/USB_D-: U37.7 (D-); also elsewhere on the board
/Interconnect/USB_PORT_CC1: J12.A5 (CC1), U38.4 (C_CC1), U38.7 (RPD_G1)
/Interconnect/USB_PORT_CC2: J12.B5 (CC2), U38.5 (C_CC2), U38.6 (RPD_G2)
/Interconnect/USB_PORT_D+: J12.A6 (D+), J12.B6 (D+), U37.1 (1D+)
/Interconnect/USB_PORT_D-: J12.A7 (D-), J12.B7 (D-), U37.2 (1D-)
/Interconnect/USB_PORT_RX1+: C182.1, J12.B11 (RX1+), U41.5 (D2-), U41.6 (NC)
/Interconnect/USB_PORT_RX1-: C183.1, J12.B10 (RX1-), U41.4 (D2+), U41.7 (NC)
/Interconnect/USB_PORT_RX2+: C187.1, J12.A11 (RX2+), U43.2 (D1-), U43.9 (NC)
/Interconnect/USB_PORT_RX2-: C186.1, J12.A10 (RX2-), U43.1 (D1+), U43.10 (NC)
/Interconnect/USB_PORT_SBU1: J12.A8 (SBU1), U38.1 (C_SBU1)
/Interconnect/USB_PORT_SBU2: J12.B8 (SBU2), U38.2 (C_SBU2)
/Interconnect/USB_PORT_TX1+: C184.1, J12.A2 (TX1+), U41.2 (D1-), U41.9 (NC)
/Interconnect/USB_PORT_TX1-: C185.1, J12.A3 (TX1-), U41.1 (D1+), U41.10 (NC)
/Interconnect/USB_PORT_TX2+: C189.1, J12.B2 (TX2+), U43.5 (D2-), U43.6 (NC)
/Interconnect/USB_PORT_TX2-: C188.1, J12.B3 (TX2-), U43.4 (D2+), U43.7 (NC)
/Interconnect/USB_RX1+: C182.2, U40.1 (CRX1P)
/Interconnect/USB_RX1-: C183.2, U40.2 (CRX1N)
/Interconnect/USB_RX2+: C187.2, U40.9 (CRX2P)
/Interconnect/USB_RX2-: C186.2, U40.10 (CRX2N)
/Interconnect/USB_SS_RX+: U40.28 (SSRXP); also elsewhere on the board
/Interconnect/USB_SS_RX-: U40.27 (SSRXN); also elsewhere on the board
/Interconnect/USB_SS_TX+: U40.26 (SSTXP); also elsewhere on the board
/Interconnect/USB_SS_TX-: U40.25 (SSTXN); also elsewhere on the board
/Interconnect/USB_TX1+: C184.2, U40.4 (CTX1P)
/Interconnect/USB_TX1-: C185.2, U40.5 (CTX1N)
/Interconnect/USB_TX2+: C189.2, U40.6 (CTX2P)
/Interconnect/USB_TX2-: C188.2, U40.7 (CTX2N)
GND: C175.2, C176.2, C177.2, C178.2, C179.2, C180.2, C181.2, J12.A1 (GND), J12.A12 (GND), J12.B1 (GND), J12.B12 (GND), J12.S1 (SHIELD), R107.2, R109.2, R111.2, R112.2, R115.2, U37.5 (GND), U38.8 (GND), U38.13 (GND), U38.16 (GND), U38.17 (GND), U38.18 (GND), U38.21 (GND), U39.1 (GND), U39.2 (GND), U39.3 (GND), U39.7 (GND), U40.29 (PAD), U41.3 (GND), U41.8 (GND), U42.2 (GND), U43.3 (GND), U43.8 (GND), U44.2 (GND); also elsewhere on the board
unnamed: R115.1, U37.9 (S)
unnamed: C178.1, U38.3 (VBIAS)
VCON: J12.A4 (VBUS), J12.A9 (VBUS), J12.B4 (VBUS), J12.B9 (VBUS), U39.4 (IN), U39.5 (IN), U39.6 (IN); also elsewhere on the board
