weiiwang01/magi/Magi.kicad_pcb

## KiCad design Magi.kicad_pcb (continued)

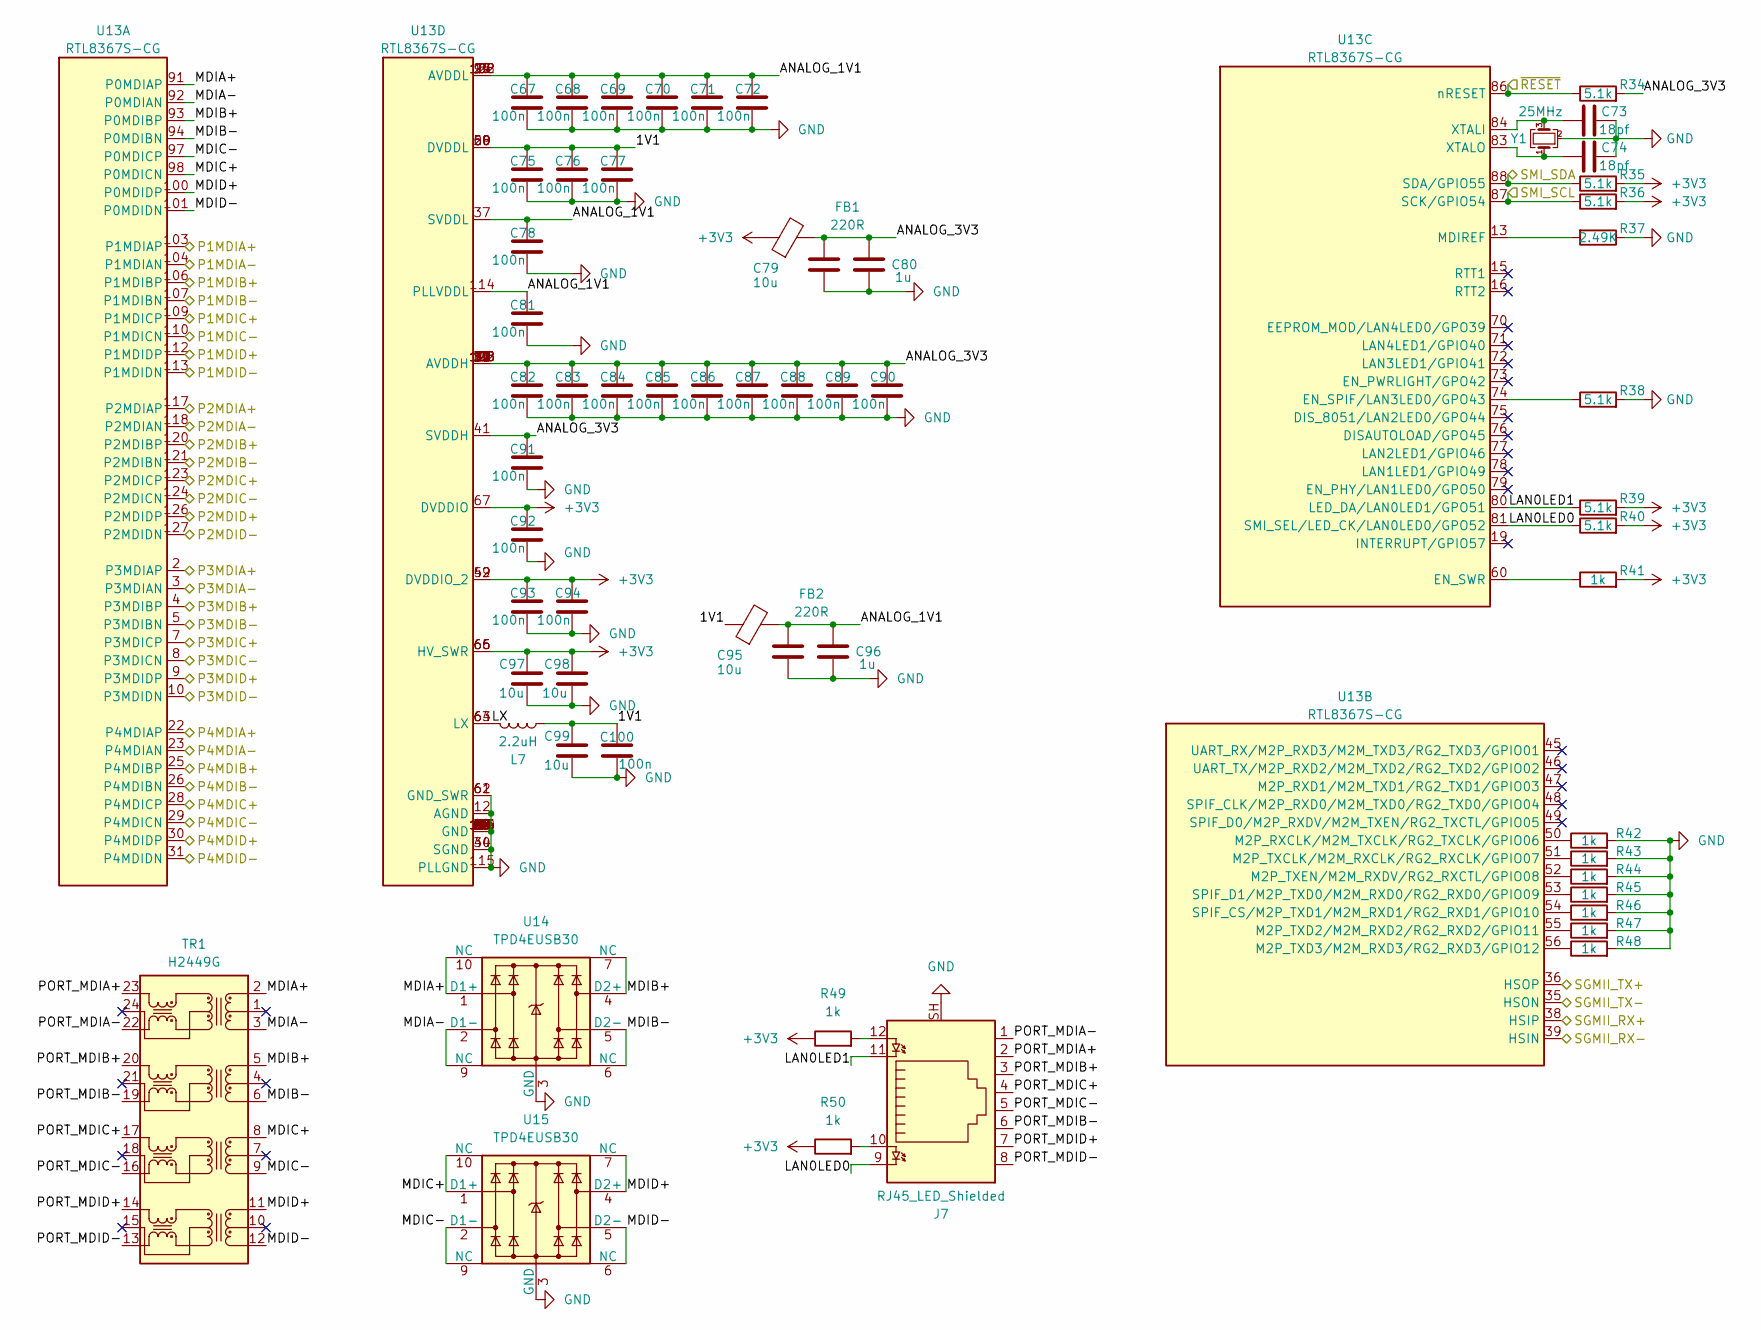
[picture p26: schematic EthernetSwitch.kicad_sch, Trilithon Magi]

Parts:
C67, C68, C69, C70, C71, C72, C75, C76, C77, C78, C81, C82, C83, C84, C85, C86, C87, C88, C89, C90, C91, C92, C93, C94, C100: 100n; C_0402_1005Metric; MPN CL05B104KB54PNC; LCSC C307331
C73, C74: 18pf; C_0402_1005Metric; MPN 0402CG180J500NT; LCSC C1549
C79, C95, C97, C98, C99: 10u; C_0603_1608Metric; MPN CL10A106MA8NRNC; LCSC C96446
C80, C96: 1u; C_0402_1005Metric; MPN CL05A105KO5NNNC; LCSC C29266
FB1, FB2: 220R; L_0603_1608Metric; MPN BLM18PG121SN1D; LCSC C14709
J7: RJ45_LED_Shielded; RJ45-TH_RJ45-005-202-11; MPN RJ45-005-202-11; LCSC C7421405
L7: 2.2uH; L_Changjiang_FTC404030S; MPN FTC404030S2R2MGCA; LCSC C39676081
R34, R35, R36, R38, R39, R40: 5.1k; R_0402_1005Metric; MPN 0402WGF5101TCE; LCSC C25905
R37: 2.49K; R_0402_1005Metric; MPN 0402WGF2491TCE; LCSC C25884
R41, R42, R43, R44, R45, R46, R47, R48, R49, R50: 1k; R_0402_1005Metric; MPN 0402WGF1001TCE; LCSC C11702
TR1: H2449G; RJ45-SMD_24P_L15.6-W8.7_H24308C; MPN H2449G; LCSC C5464748
U13: RTL8367S-CG; LQFP-128_14x14mm_P0.4mm; MPN RTL8367S-CG; LCSC C2760849
U14, U15: TPD4EUSB30; USON-10_2.5x1.0mm_P0.5mm; MPN TPD4EUSB30DQAR; LCSC C90627
Y1: 25MHz; Crystal_SMD_2016-4Pin_2.0x1.6mm; MPN XL7EL89COI-111YLC-25M; LCSC C20617996

Connections:
+3V3: C92.1, C93.1, C94.1, C97.1, C98.1, FB1.1, R35.2, R36.2, R39.2, R40.2, R41.2, R49.1, R50.1, U13.42 (DVDDIO_2), U13.59 (DVDDIO_2), U13.65 (HV_SWR), U13.66 (HV_SWR), U13.67 (DVDDIO); also elsewhere on the board
/Controller/ETH_P0+: U13.2 (P3MDIAP); also elsewhere on the board
/Controller/ETH_P0-: U13.3 (P3MDIAN); also elsewhere on the board
/Controller/ETH_P1+: U13.4 (P3MDIBP); also elsewhere on the board
/Controller/ETH_P1-: U13.5 (P3MDIBN); also elsewhere on the board
/Controller/PD7: R35.1, U13.88 (SDA/GPIO55); also elsewhere on the board
/Controller/PF10: R36.1, U13.87 (SCK/GPIO54); also elsewhere on the board
/Controller/PF11: R34.1, U13.86 (nRESET); also elsewhere on the board
/Ethernet Switch/1V1: C75.1, C76.1, C77.1, C99.1, C100.1, FB2.1, L7.2, U13.20 (DVDDL), U13.58 (DVDDL), U13.69 (DVDDL)
/Ethernet Switch/ANALOG_1V1: C67.1, C68.1, C69.1, C70.1, C71.1, C72.1, C78.1, C81.1, C95.1, C96.1, FB2.2, U13.6 (AVDDL), U13.14 (AVDDL), U13.27 (AVDDL), U13.37 (SVDDL), U13.95 (AVDDL), U13.108 (AVDDL), U13.114 (PLLVDDL), U13.122 (AVDDL)
/Ethernet Switch/ANALOG_3V3: C79.1, C80.1, C82.1, C83.1, C84.1, C85.1, C86.1, C87.1, C88.1, C89.1, C90.1, C91.1, FB1.2, R34.2, U13.11 (AVDDH), U13.17 (AVDDH), U13.21 (AVDDH), U13.33 (AVDDH), U13.41 (SVDDH), U13.82 (AVDDH), U13.90 (AVDDH), U13.102 (AVDDH), U13.116 (AVDDH), U13.128 (AVDDH)
/Ethernet Switch/LAN0LED0: J7.9, R40.1, U13.81 (SMI_SEL/LED_CK/LAN0LED0/GPO52)
/Ethernet Switch/LAN0LED1: J7.11, R39.1, U13.80 (LED_DA/LAN0LED1/GPO51)
/Ethernet Switch/LX: L7.1, U13.63 (LX), U13.64 (LX)
/Ethernet Switch/MDIA+: TR1.2 (TD1+), U13.91 (P0MDIAP), U14.1 (D1+), U14.10 (NC)
/Ethernet Switch/MDIA-: TR1.3 (TD1-), U13.92 (P0MDIAN), U14.2 (D1-), U14.9 (NC)
/Ethernet Switch/MDIB+: TR1.5 (TD2+), U13.93 (P0MDIBP), U14.4 (D2+), U14.7 (NC)
/Ethernet Switch/MDIB-: TR1.6 (TD2-), U13.94 (P0MDIBN), U14.5 (D2-), U14.6 (NC)
/Ethernet Switch/MDIC+: TR1.8 (TD3+), U13.98 (P0MDICN), U15.1 (D1+), U15.10 (NC)
/Ethernet Switch/MDIC-: TR1.9 (TD3-), U13.97 (P0MDICP), U15.2 (D1-), U15.9 (NC)
/Ethernet Switch/MDID+: TR1.11 (TD4+), U13.100 (P0MDIDP), U15.4 (D2+), U15.7 (NC)
/Ethernet Switch/MDID-: TR1.12 (TD4-), U13.101 (P0MDIDN), U15.5 (D2-), U15.6 (NC)
/Ethernet Switch/P1MDIA+: U13.103 (P1MDIAP); also elsewhere on the board
/Ethernet Switch/P1MDIA-: U13.104 (P1MDIAN); also elsewhere on the board
/Ethernet Switch/P1MDIB+: U13.106 (P1MDIBP); also elsewhere on the board
/Ethernet Switch/P1MDIB-: U13.107 (P1MDIBN); also elsewhere on the board
/Ethernet Switch/P1MDIC+: U13.109 (P1MDICP); also elsewhere on the board
/Ethernet Switch/P1MDIC-: U13.110 (P1MDICN); also elsewhere on the board
/Ethernet Switch/P1MDID+: U13.112 (P1MDIDP); also elsewhere on the board
/Ethernet Switch/P1MDID-: U13.113 (P1MDIDN); also elsewhere on the board
/Ethernet Switch/P2MDIA+: U13.117 (P2MDIAP); also elsewhere on the board
/Ethernet Switch/P2MDIA-: U13.118 (P2MDIAN); also elsewhere on the board
/Ethernet Switch/P2MDIB+: U13.120 (P2MDIBP); also elsewhere on the board
/Ethernet Switch/P2MDIB-: U13.121 (P2MDIBN); also elsewhere on the board
/Ethernet Switch/P2MDIC+: U13.123 (P2MDICP); also elsewhere on the board
/Ethernet Switch/P2MDIC-: U13.124 (P2MDICN); also elsewhere on the board
/Ethernet Switch/P2MDID+: U13.126 (P2MDIDP); also elsewhere on the board
/Ethernet Switch/P2MDID-: U13.127 (P2MDIDN); also elsewhere on the board
/Ethernet Switch/P3MDIC+: U13.7 (P3MDICP)
/Ethernet Switch/P3MDIC-: U13.8 (P3MDICN)
/Ethernet Switch/P3MDID+: U13.9 (P3MDIDP)
/Ethernet Switch/P3MDID-: U13.10 (P3MDIDN)
/Ethernet Switch/P4MDIA+: U13.22 (P4MDIAP); also elsewhere on the board
/Ethernet Switch/P4MDIA-: U13.23 (P4MDIAN); also elsewhere on the board
/Ethernet Switch/P4MDIB+: U13.25 (P4MDIBP); also elsewhere on the board
/Ethernet Switch/P4MDIB-: U13.26 (P4MDIBN); also elsewhere on the board
/Ethernet Switch/P4MDIC+: U13.28 (P4MDICP); also elsewhere on the board
/Ethernet Switch/P4MDIC-: U13.29 (P4MDICN); also elsewhere on the board
/Ethernet Switch/P4MDID+: U13.30 (P4MDIDP); also elsewhere on the board
/Ethernet Switch/P4MDID-: U13.31 (P4MDIDN); also elsewhere on the board
/Ethernet Switch/PORT_MDIA+: J7.2, TR1.23 (MX1+)
/Ethernet Switch/PORT_MDIA-: J7.1, TR1.22 (MX1-)
/Ethernet Switch/PORT_MDIB+: J7.3, TR1.20 (MX2+)
/Ethernet Switch/PORT_MDIB-: J7.6, TR1.19 (MX2-)
/Ethernet Switch/PORT_MDIC+: J7.4, TR1.17 (MX3+)
/Ethernet Switch/PORT_MDIC-: J7.5, TR1.16 (MX3-)
/Ethernet Switch/PORT_MDID+: J7.7, TR1.14 (MX4+)
/Ethernet Switch/PORT_MDID-: J7.8, TR1.13 (MX4-)
/Ethernet Switch/SGMII_RX+: U13.38 (HSIP); also elsewhere on the board
/Ethernet Switch/SGMII_RX-: U13.39 (HSIN); also elsewhere on the board
/Ethernet Switch/SGMII_TX+: U13.36 (HSOP); also elsewhere on the board
/Ethernet Switch/SGMII_TX-: U13.35 (HSON); also elsewhere on the board
GND: C67.2, C68.2, C69.2, C70.2, C71.2, C72.2, C73.1, C74.1, C75.2, C76.2, C77.2, C78.2, C79.2, C80.2, C81.2, C82.2, C83.2, C84.2, C85.2, C86.2, C87.2, C88.2, C89.2, C90.2, C91.2, C92.2, C93.2, C94.2, C95.2, C96.2, C97.2, C98.2, C99.2, C100.2, J7.SH, R37.1, R38.2, R42.2, R43.2, R44.2, R45.2, R46.2, R47.2, R48.2, U13.1 (GND), U13.12 (AGND), U13.18 (GND), U13.24 (GND), U13.32 (GND), U13.34 (SGND), U13.40 (SGND), U13.43 (GND), U13.44 (GND), U13.57 (GND), U13.61 (GND_SWR), U13.62 (GND_SWR), U13.68 (GND), U13.85 (GND), U13.89 (GND), U13.96 (GND), U13.99 (GND), U13.105 (GND), U13.111 (GND), U13.115 (PLLGND), U13.119 (GND), U13.125 (GND), U14.3 (GND), U14.8 (GND), U15.3 (GND), U15.8 (GND), Y1.2 (G), Y1.4 (G); also elsewhere on the board
unnamed: J7.10, R50.2
unnamed: J7.12, R49.2
unnamed: R42.1, U13.50 (M2P_RXCLK/M2M_TXCLK/RG2_TXCLK/GPIO06)
unnamed: R43.1, U13.51 (M2P_TXCLK/M2M_RXCLK/RG2_RXCLK/GPIO07)
unnamed: R47.1, U13.55 (M2P_TXD2/M2M_RXD2/RG2_RXD2/GPIO11)
unnamed: R48.1, U13.56 (M2P_TXD3/M2M_RXD3/RG2_RXD3/GPIO12)
unnamed: R44.1, U13.52 (M2P_TXEN/M2M_RXDV/RG2_RXCTL/GPIO08)
unnamed: R46.1, U13.54 (SPIF_CS/M2P_TXD1/M2M_RXD1/RG2_RXD1/GPIO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)
unnamed: R45.1, U13.53 (SPIF_D1/M2P_TXD0/M2M_RXD0/RG2_RXD0/GPIO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)
unnamed: R38.1, U13.74 (EN_SPIF/LAN3LED0/GPO43)
unnamed: R41.1, U13.60 (EN_SWR)
unnamed: R37.2, U13.13 (MDIREF)
unnamed: C73.2, U13.84 (XTALI), Y1.3
unnamed: C74.2, U13.83 (XTALO), Y1.1

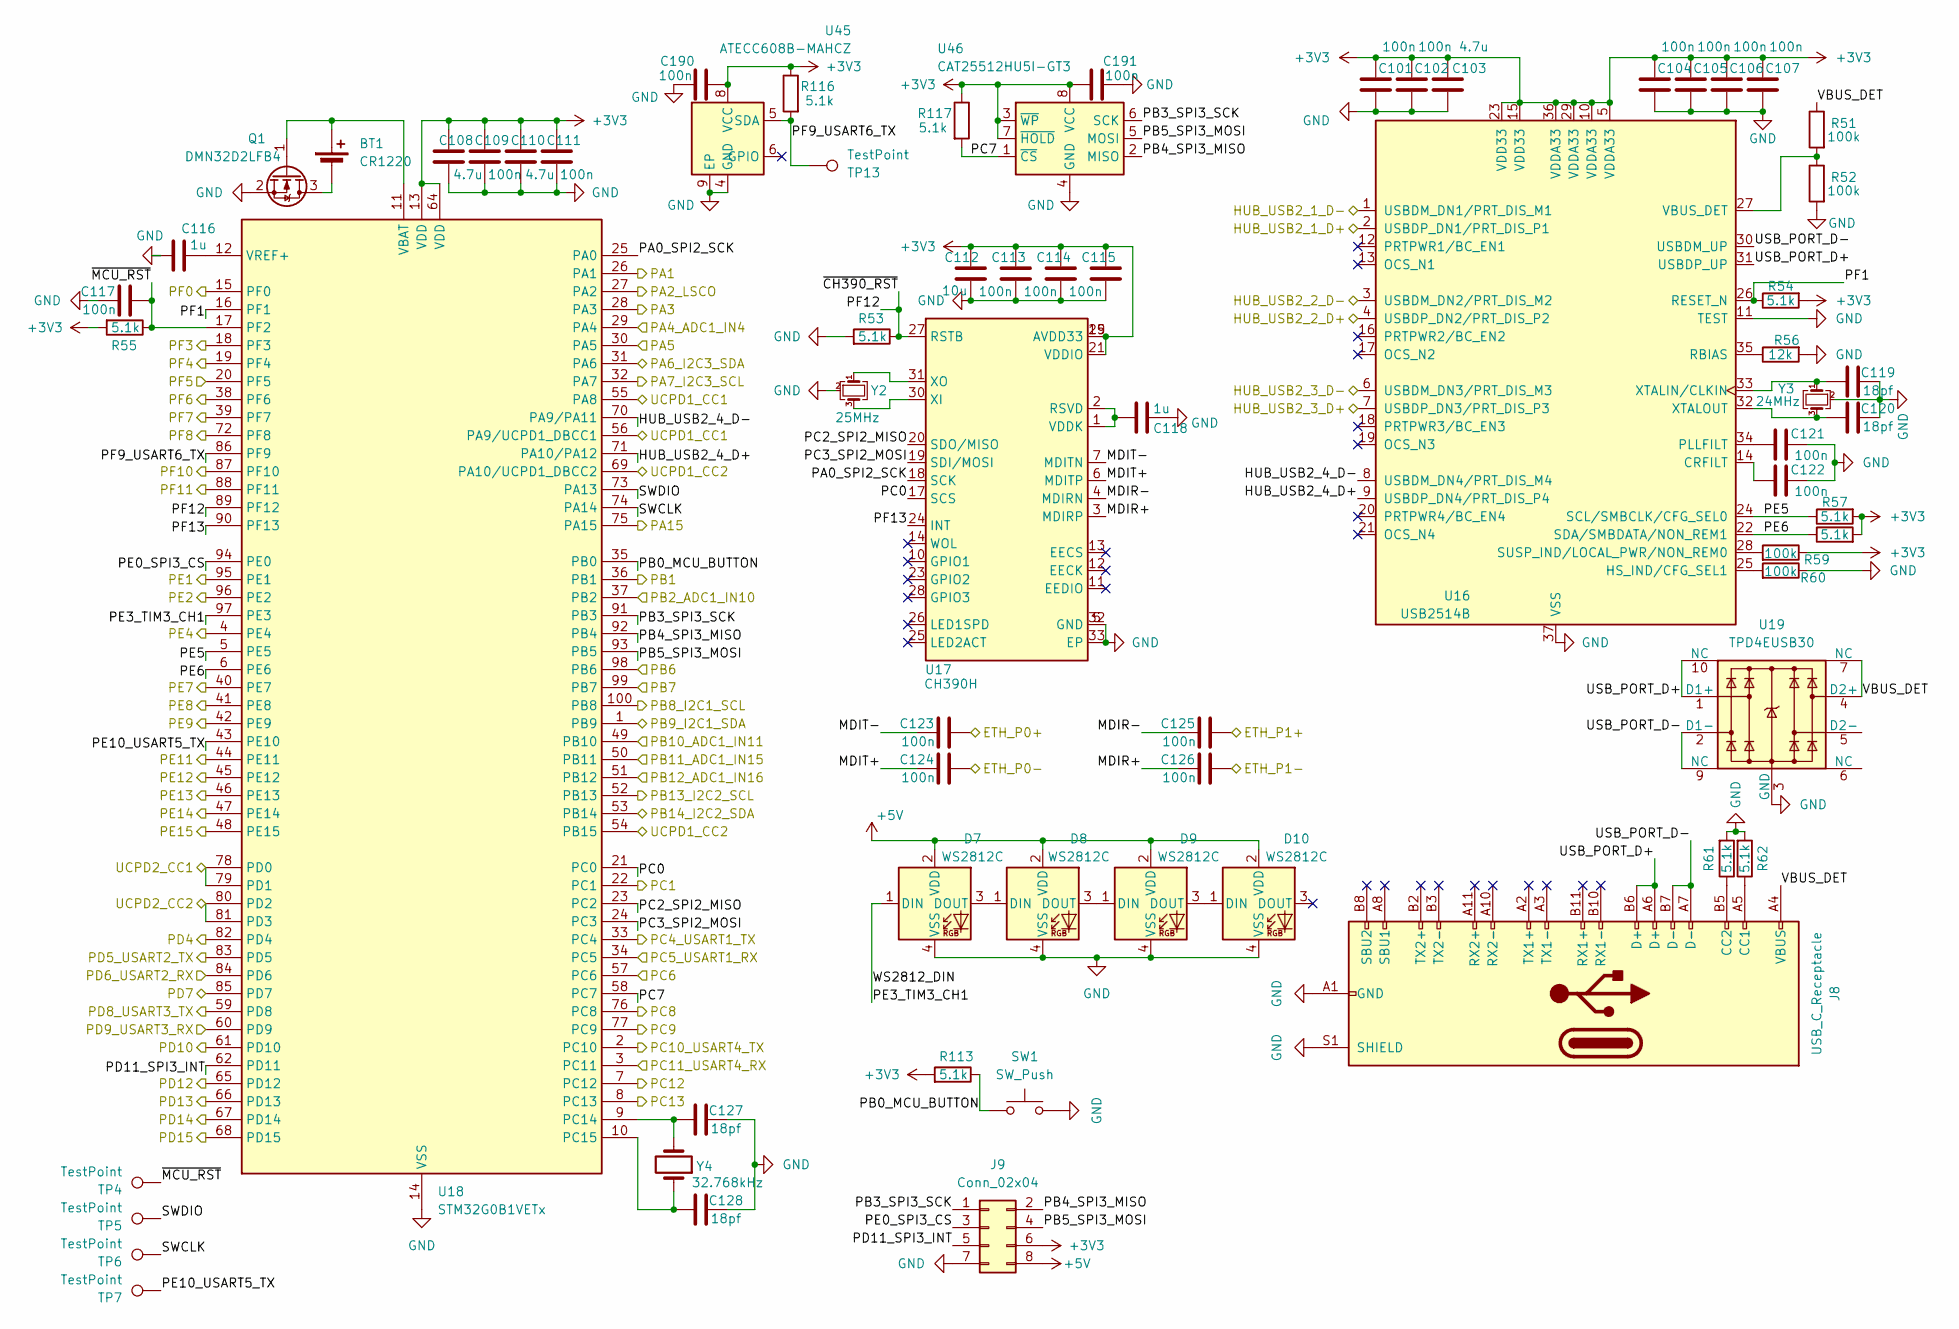
[picture p27: schematic Controller.kicad_sch, Trilithon Magi]

Parts:
BT1: CR1220; BAT-SMD_MY-1220-03; MPN MY-1220-04; LCSC C2979172
C101, C102, C104, C105, C106, C107, C109, C111, C113, C114, C115, C117, C121, C122, C123, C124, C125, C126, C190, C191: 100n; C_0402_1005Metric; MPN CL05B104KB54PNC; LCSC C307331
C103, C108, C110: 4.7u; C_0603_1608Metric; MPN CL10A475KO8NNNC; LCSC C19666
C112: 10u; C_0603_1608Metric; MPN CL10A106MA8NRNC; LCSC C96446
C116, C118: 1u; C_0402_1005Metric; MPN CL05A105KO5NNNC; LCSC C29266
C119, C120, C127, C128: 18pf; C_0402_1005Metric; MPN 0402CG180J500NT; LCSC C1549
D7, D8, D9, D10: WS2812C; LED-SMD_4P-L4.0-W1.7_DCS; MPN WS2812C-4020-V6; LCSC C55109523
J8: USB_C_Receptacle; USB-C-SMD_TYPE-C-GT-USB-7007C; MPN GT-USB-9007A; LCSC C48533148
J9: Conn_02x04; PinHeader_2x04_P1.27mm_Vertical_SMD_MountingPegs; MPN HX PZ1.27-2x4P TP-D; LCSC C42454109
Q1: DMN32D2LFB4; Diodes_DFN1006-3; MPN DMN32D2LFB4-7; LCSC C151382
R51, R52, R59, R60: 100k; R_0402_1005Metric; MPN 0402WGF1003TCE; LCSC C25741
R53, R54, R55, R57, R58, R61, R62, R113, R116, R117: 5.1k; R_0402_1005Metric; MPN 0402WGF5101TCE; LCSC C25905
R56: 12k; R_0402_1005Metric; MPN 0402WGF1202TCE; LCSC C25752
SW1: SW_Push; SW-SMD_L4.7-W3.5-P3.35-EH; MPN GT-TC018B-H0375-L1; LCSC C2762970
TP4, TP5, TP6, TP7, TP13: TestPoint; TestPoint_Pad_D1.5mm
U16: USB2514B; QFN-36-1EP_6x6mm_P0.5mm_EP3.7x3.7mm; MPN USB2514B-AEZC-TR; LCSC C16251
U17: CH390H; QFN-32-1EP_5x5mm_P0.5mm_EP3.45x3.45mm; MPN CH390H; LCSC C7498452
U18: STM32G0B1VETx; LQFP-100_14x14mm_P0.5mm; MPN STM32G0B1VET6; LCSC C2829192
U19: TPD4EUSB30; USON-10_2.5x1.0mm_P0.5mm; MPN TPD4EUSB30DQAR; LCSC C90627
U45: ATECC608B-MAHCZ; DFN-8-1EP_3x2mm_P0.5mm_EP1.3x1.5mm; MPN ATECC608B-MAHCZ; LCSC C1518770
U46: CAT25512HU5I-GT3; DFN-8-1EP_3x2mm_P0.5mm_EP0.9x1.4mm; MPN CAT25512HU5I-GT3; LCSC C463684
Y2: 25MHz; Crystal_SMD_2016-4Pin_2.0x1.6mm; MPN XL7EL89COI-111YLC-25M; LCSC C20617996
Y3: 24MHz; Crystal_SMD_2016-4Pin_2.0x1.6mm; MPN XL7EL89COI-111YLC-24M; LCSC C22434877
Y4: 32.768kHz; Crystal_SMD_2012-2Pin_2.0x1.2mm; MPN SX201232768K2GHCZ2T; LCSC C5271201

Connections:
+3V3: C101.2, C102.2, C103.1, C104.2, C105.2, C106.2, C107.2, C108.1, C109.2, C110.1, C111.2, C112.1, C113.2, C114.2, C115.2, C190.2, C191.2, J9.6, R54.2, R55.2, R57.2, R58.2, R59.1, R113.2, R116.1, R117.1, U16.5 (VDDA33), U16.10 (VDDA33), U16.15 (VDD33), U16.23 (VDD33), U16.29 (VDDA33), U16.36 (VDDA33), U17.15 (AVDD33), U17.21 (VDDIO), U17.29 (AVDD33), U18.13 (VDD), U18.64 (VDD), U45.8 (VCC), U46.3 (~WP), U46.7 (~HOLD), U46.8 (VCC); also elsewhere on the board
+5V: D7.2 (VDD), D8.2 (VDD), D9.2 (VDD), D10.2 (VDD), J9.8; also elsewhere on the board
/Controller/ETH_P0+: C123.2; also elsewhere on the board
/Controller/ETH_P0-: C124.2; also elsewhere on the board
/Controller/ETH_P1+: C125.2; also elsewhere on the board
/Controller/ETH_P1-: C126.2; also elsewhere on the board
/Controller/HUB_USB2_1_D+: U16.2 (USBDP_DN1/PRT_DIS_P1); also elsewhere on the board
/Controller/HUB_USB2_1_D-: U16.1 (USBDM_DN1/PRT_DIS_M1); also elsewhere on the board
/Controller/HUB_USB2_2_D+: U16.4 (USBDP_DN2/PRT_DIS_P2); also elsewhere on the board
/Controller/HUB_USB2_2_D-: U16.3 (USBDM_DN2/PRT_DIS_M2); also elsewhere on the board
/Controller/HUB_USB2_3_D+: U16.7 (USBDP_DN3/PRT_DIS_P3); also elsewhere on the board
/Controller/HUB_USB2_3_D-: U16.6 (USBDM_DN3/PRT_DIS_M3); also elsewhere on the board
/Controller/HUB_USB2_4_D+: U16.9 (USBDP_DN4/PRT_DIS_P4), U18.71 (PA10/PA12)
/Controller/HUB_USB2_4_D-: U16.8 (USBDM_DN4/PRT_DIS_M4), U18.70 (PA9/PA11)
/Controller/MDIR+: C126.1, U17.3 (MDIRP)
/Controller/MDIR-: C125.1, U17.4 (MDIRN)
/Controller/MDIT+: C124.1, U17.6 (MDITP)
/Controller/MDIT-: C123.1, U17.7 (MDITN)
/Controller/PA0_SPI2_SCK: U17.18 (SCK), U18.25 (PA0)
/Controller/PA1: U18.26 (PA1); also elsewhere on the board
/Controller/PA3: U18.28 (PA3); also elsewhere on the board
/Controller/PA4_ADC1_IN4: U18.29 (PA4); also elsewhere on the board
/Controller/PA6_I2C3_SDA: U18.31 (PA6); also elsewhere on the board
/Controller/PA7_I2C3_SCL: U18.32 (PA7); also elsewhere on the board
/Controller/PA15: U18.75 (PA15); also elsewhere on the board
/Controller/PB0_MCU_BUTTON: R113.1, SW1.1, U18.35 (PB0)
/Controller/PB1: U18.36 (PB1); also elsewhere on the board
/Controller/PB2_ADC1_IN10: U18.37 (PB2); also elsewhere on the board
/Controller/PB3_SPI3_SCK: J9.1, U18.91 (PB3), U46.6 (SCK)
/Controller/PB4_SPI3_MISO: J9.2, U18.92 (PB4), U46.2 (MISO)
/Controller/PB5_SPI3_MOSI: J9.4, U18.93 (PB5), U46.5 (MOSI)
/Controller/PB6: U18.98 (PB6); also elsewhere on the board
/Controller/PB8_I2C1_SCL: U18.100 (PB8); also elsewhere on the board
/Controller/PB9_I2C1_SDA: U18.1 (PB9); also elsewhere on the board
/Controller/PB10_ADC1_IN11: U18.49 (PB10); also elsewhere on the board
/Controller/PB11_ADC1_IN15: U18.50 (PB11); also elsewhere on the board
/Controller/PB12_ADC1_IN16: U18.51 (PB12); also elsewhere on the board
/Controller/PB13_I2C2_SCL: U18.52 (PB13); also elsewhere on the board
/Controller/PB14_I2C2_SDA: U18.53 (PB14); also elsewhere on the board
/Controller/PC0: U17.17 (SCS), U18.21 (PC0)
/Controller/PC1: U18.22 (PC1); also elsewhere on the board
/Controller/PC2_SPI2_MISO: U17.20 (SDO/MISO), U18.23 (PC2)
/Controller/PC3_SPI2_MOSI: U17.19 (SDI/MOSI), U18.24 (PC3)
/Controller/PC4_USART1_TX: U18.33 (PC4); also elsewhere on the board
/Controller/PC5_USART1_RX: U18.34 (PC5); also elsewhere on the board
/Controller/PC7: R117.2, U18.58 (PC7), U46.1 (~CS)
/Controller/PC8: U18.76 (PC8); also elsewhere on the board
/Controller/PC9: U18.77 (PC9); also elsewhere on the board
/Controller/PC10_USART4_TX: U18.2 (PC10); also elsewhere on the board
/Controller/PC11_USART4_RX: U18.3 (PC11); also elsewhere on the board
/Controller/PC12: U18.7 (PC12); also elsewhere on the board
/Controller/PC13: U18.8 (PC13); also elsewhere on the board
/Controller/PD4: U18.82 (PD4); also elsewhere on the board
/Controller/PD5_USART2_TX: U18.83 (PD5); also elsewhere on the board
/Controller/PD6_USART2_RX: U18.84 (PD6); also elsewhere on the board
/Controller/PD7: U18.85 (PD7); also elsewhere on the board
/Controller/PD8_USART3_TX: U18.59 (PD8); also elsewhere on the board
/Controller/PD9_USART3_RX: U18.60 (PD9); also elsewhere on the board
/Controller/PD10: U18.61 (PD10); also elsewhere on the board
/Controller/PD11_SPI3_INT: J9.5, U18.62 (PD11)
/Controller/PD12: U18.65 (PD12); also elsewhere on the board
/Controller/PD13: U18.66 (PD13); also elsewhere on the board
/Controller/PD14: U18.67 (PD14); also elsewhere on the board
/Controller/PD15: U18.68 (PD15); also elsewhere on the board
/Controller/PE0_SPI3_CS: J9.3, U18.94 (PE0)
/Controller/PE1: U18.95 (PE1); also elsewhere on the board
/Controller/PE2: U18.96 (PE2); also elsewhere on the board
/Controller/PE3_TIM3_CH1: D7.1 (DIN), U18.97 (PE3)
/Controller/PE4: U18.4 (PE4); also elsewhere on the board
/Controller/PE5: R57.1, U16.24 (SCL/SMBCLK/CFG_SEL0), U18.5 (PE5)
/Controller/PE6: R58.1, U16.22 (SDA/SMBDATA/NON_REM1), U18.6 (PE6)
/Controller/PE7: U18.40 (PE7); also elsewhere on the board
/Controller/PE8: U18.41 (PE8); also elsewhere on the board
/Controller/PE9: U18.42 (PE9); also elsewhere on the board
/Controller/PE10_USART5_TX: TP7.1 (1_1), U18.43 (PE10)
/Controller/PE11: U18.44 (PE11); also elsewhere on the board
/Controller/PE12: U18.45 (PE12); also elsewhere on the board
/Controller/PE13: U18.46 (PE13); also elsewhere on the board
/Controller/PE14: U18.47 (PE14); also elsewhere on the board
/Controller/PE15: U18.48 (PE15); also elsewhere on the board
/Controller/PF0: U18.15 (PF0); also elsewhere on the board
/Controller/PF1: R54.1, U16.26 (RESET_N), U18.16 (PF1)
/Controller/PF3: U18.18 (PF3); also elsewhere on the board
/Controller/PF4: U18.19 (PF4); also elsewhere on the board
/Controller/PF5: U18.20 (PF5); also elsewhere on the board
/Controller/PF6: U18.38 (PF6); also elsewhere on the board
/Controller/PF7: U18.39 (PF7); also elsewhere on the board
/Controller/PF8: U18.72 (PF8); also elsewhere on the board
/Controller/PF9_USART6_TX: R116.2, TP13.1 (1_1), U18.86 (PF9), U45.5 (SDA)
/Controller/PF10: U18.87 (PF10); also elsewhere on the board
/Controller/PF11: U18.88 (PF11); also elsewhere on the board
/Controller/PF12: R53.1, U17.27 (RSTB), U18.89 (PF12)
/Controller/PF13: U17.24 (INT), U18.90 (PF13)
/Controller/SWCLK: TP6.1 (1_1), U18.74 (PA14)
/Controller/SWDIO: TP5.1 (1_1), U18.73 (PA13)
/Controller/UCPD1_CC1: U18.55 (PA8), U18.56 (PA9/UCPD1_DBCC1); also elsewhere on the board
/Controller/UCPD1_CC2: U18.54 (PB15), U18.69 (PA10/UCPD1_DBCC2); also elsewhere on the board
/Controller/UCPD2_CC1: U18.78 (PD0), U18.79 (PD1); also elsewhere on the board
/Controller/UCPD2_CC2: U18.80 (PD2), U18.81 (PD3); also elsewhere on the board
/Controller/USB_PORT_D+: J8.A6 (D+), J8.B6 (D+), U16.31 (USBDP_UP), U19.1 (D1+), U19.10 (NC)
/Controller/USB_PORT_D-: J8.A7 (D-), J8.B7 (D-), U16.30 (USBDM_UP), U19.2 (D1-), U19.9 (NC)
/Controller/VBUS_DET: J8.A4 (VBUS), J8.A9 (VBUS), J8.B4 (VBUS), J8.B9 (VBUS), R51.1, U19.4 (D2+), U19.7 (NC)
/Controller/~MCU_RST: C117.2, R55.1, TP4.1 (1_1), U18.17 (PF2)
/LSCO: U18.27 (PA2); also elsewhere on the board
/Unit 1/CM_3V3: U18.99 (PB7); also elsewhere on the board
/Unit 2/CM_3V3: U18.30 (PA5); also elsewhere on the board
/Unit 3/CM_3V3: U18.57 (PC6); also elsewhere on the board
GND: C101.1, C102.1, C103.2, C104.1, C105.1, C106.1, C107.1, C108.2, C109.1, C110.2, C111.1, C112.2, C113.1, C114.1, C115.1, C116.1, C117.1, C118.1, C119.1, C120.1, C121.2, C122.2, C127.1, C128.1, C190.1, C191.1, D7.4 (VSS), D8.4 (VSS), D9.4 (VSS), D10.4 (VSS), J8.A1 (GND), J8.A12 (GND), J8.B1 (GND), J8.B12 (GND), J8.S1 (SHIELD), J9.7, Q1.2 (S), R52.2, R53.2, R56.2, R60.1, R61.2, R62.2, SW1.2, U16.11 (TEST), U16.37 (VSS), U17.5 (GND), U17.32 (GND), U17.33 (EP), U18.14 (VSS), U18.63 (VSS), U19.3 (GND), U19.8 (GND), U45.4 (GND), U45.9 (EP), U46.4 (GND), U46.9 (GND), Y2.2 (G), Y2.4 (G), Y3.2 (G), Y3.4 (G); also elsewhere on the board
unnamed: BT1.1 (+), Q1.1 (G), U18.11 (VBAT)
unnamed: BT1.2 (-), Q1.3 (D)
unnamed: D7.3 (DOUT), D8.1 (DIN)
unnamed: D8.3 (DOUT), D9.1 (DIN)
unnamed: D9.3 (DOUT), D10.1 (DIN)
unnamed: J8.A5 (CC1), R62.1
unnamed: J8.B5 (CC2), R61.1
unnamed: C122.1, U16.14 (CRFILT)
unnamed: R60.2, U16.25 (HS_IND/CFG_SEL1)
unnamed: C121.1, U16.34 (PLLFILT)
unnamed: R56.1, U16.35 (RBIAS)
unnamed: R59.2, U16.28 (SUSP_IND/LOCAL_PWR/NON_REM0)
unnamed: R51.2, R52.1, U16.27 (VBUS_DET)
unnamed: C119.2, U16.33 (XTALIN/CLKIN), Y3.1
unnamed: C120.2, U16.32 (XTALOUT), Y3.3
unnamed: C118.2, U17.1 (VDDK), U17.2 (RSVD)
unnamed: U17.30 (XI), Y2.3
unnamed: U17.31 (XO), Y2.1
unnamed: C127.2, U18.9 (PC14), Y4.2
unnamed: C128.2, U18.10 (PC15), Y4.1
unnamed: C116.2, U18.12 (VREF+)

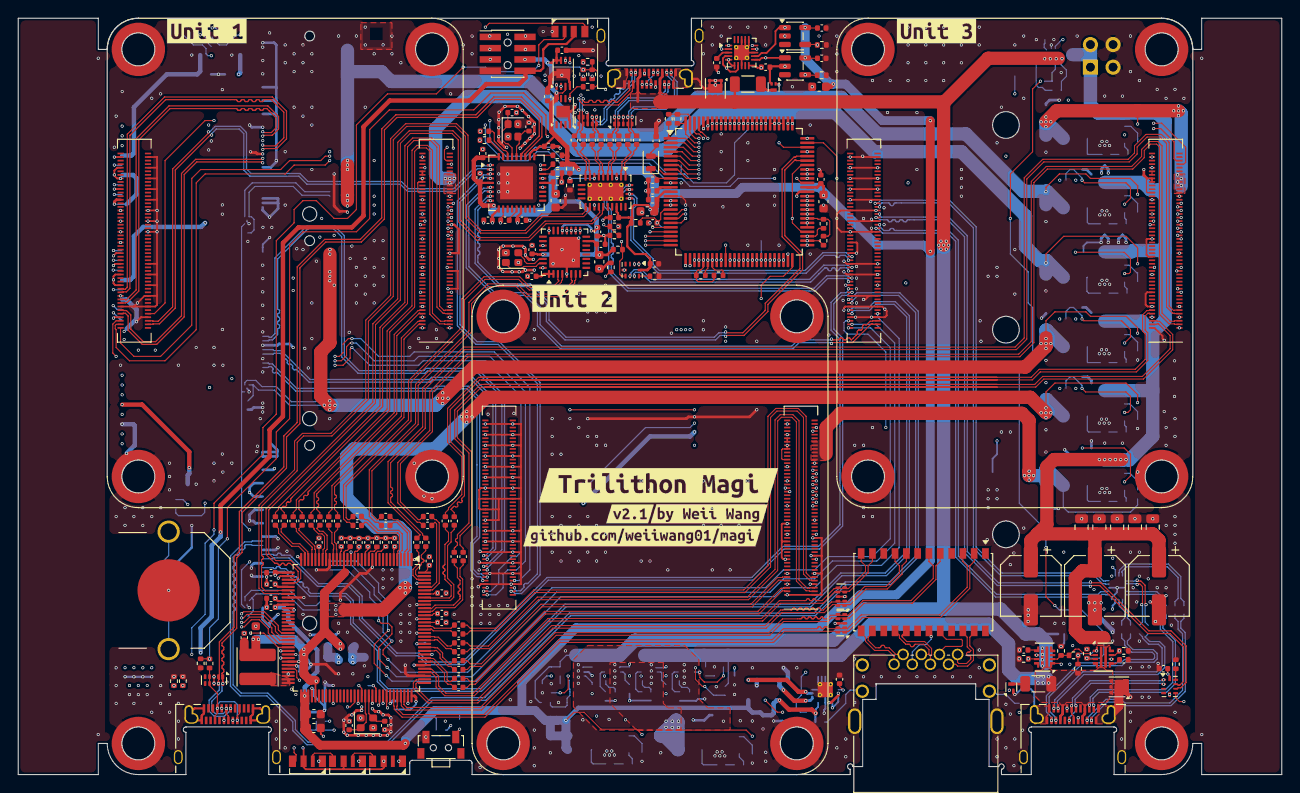
[picture p28: board Magi.kicad_pcb from above]

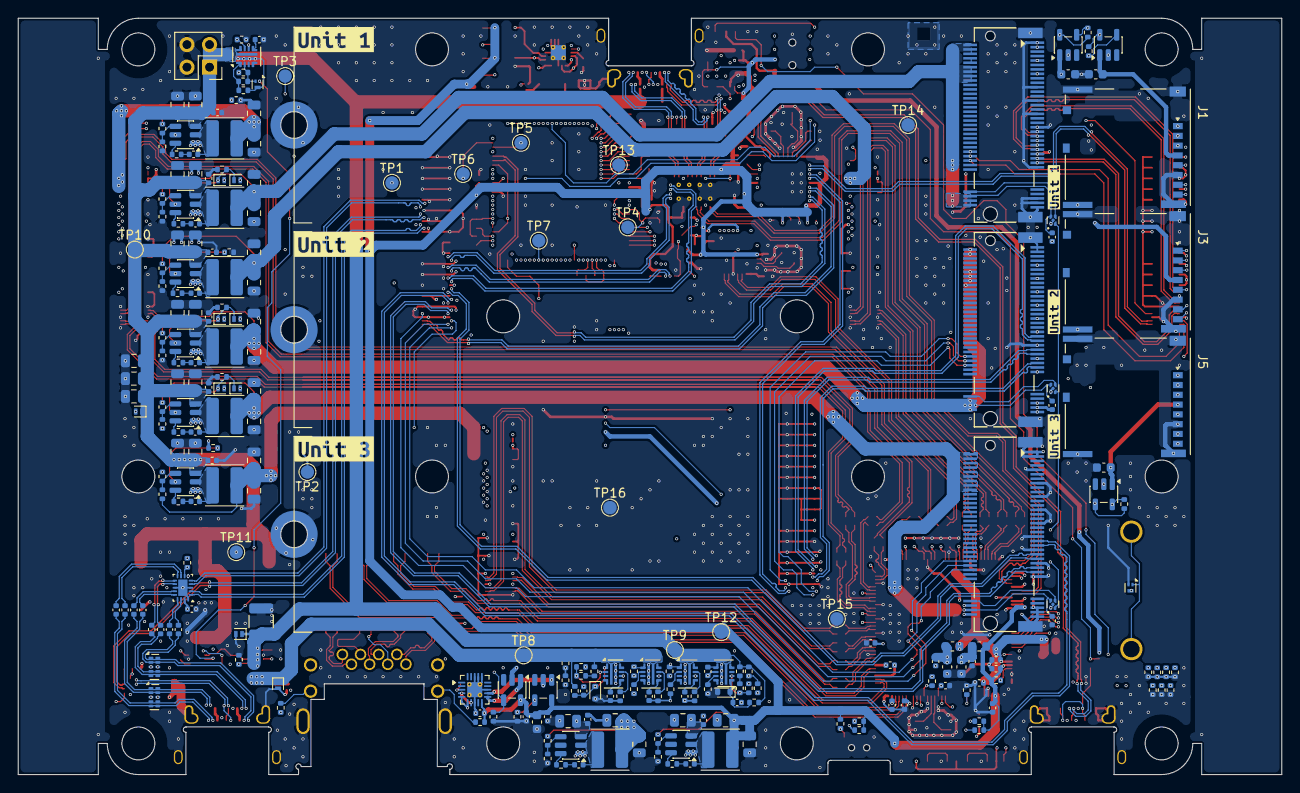
[picture p29: board Magi.kicad_pcb from below]

Board: 6 copper layers, 142.0 x 85.0 mm, 436 parts (244 on the bottom side), 406 nets.

Other parts of the board:
kibuzzard-6A5B14ED: G***; kibuzzard-6A5B14ED
kibuzzard-6A5B154C: G***; kibuzzard-6A5B154C
kibuzzard-6A5B1551: G***; kibuzzard-6A5B1551
kibuzzard-6AC565B3: G***; kibuzzard-6AC565B3
kibuzzard-69C4E3CF: G***; kibuzzard-69C4E3CF
kibuzzard-69C4E40D: G***; kibuzzard-69C4E40D
kibuzzard-69C4E42D: G***; kibuzzard-69C4E42D
kibuzzard-69C509A0: G***; kibuzzard-69C509A0
kibuzzard-69C5095C: G***; kibuzzard-69C5095C
kibuzzard-69C5098A: G***; kibuzzard-69C5098A
kibuzzard-69C50949: G***; kibuzzard-69C50949
kibuzzard-69C50974: G***; kibuzzard-69C50974
kibuzzard-69C50981: G***; kibuzzard-69C50981
