weiiwang01/magi/firmware/Core/Inc/lwipopts.h

/**
  ******************************************************************************
  * @file    LwIP/LwIP_HTTP_Server_Netconn_RTOS/Inc/lwipopts.h
  * @author  MCD Application Team
  * @brief   lwIP Options Configuration.
  ******************************************************************************
  * @attention
  *
  * Copyright (c) 2016 STMicroelectronics.
  * All rights reserved.
  *
  * This software is licensed under terms that can be found in the LICENSE file
  * in the root directory of this software component.
  * If no LICENSE file comes with this software, it is provided AS-IS.
  *
  ******************************************************************************
  */
#ifndef __LWIPOPTS_H__
#define __LWIPOPTS_H__

/**
 * NO_SYS==1: Provides VERY minimal functionality. Otherwise,
 * use lwIP facilities.
 */
#define NO_SYS                  0

/* ---------- Memory options ---------- */
/* MEM_ALIGNMENT: should be set to the alignment of the CPU for which
   lwIP is compiled. 4 byte alignment -> define MEM_ALIGNMENT to 4, 2
   byte alignment -> define MEM_ALIGNMENT to 2. */
#define MEM_ALIGNMENT           4

/* MEM_SIZE: the size of the heap memory. If the application will send
a lot of data that needs to be copied, this should be set high. */
#define MEM_SIZE                (16*1024)

/* Relocate the LwIP RAM heap pointer */
// #define LWIP_RAM_HEAP_POINTER    (0x20048000)

/* MEMP_NUM_PBUF: the number of memp struct pbufs. If the application
   sends a lot of data out of ROM (or other static memory), this
   should be set high. */
#define MEMP_NUM_PBUF           10
/* MEMP_NUM_UDP_PCB: the number of UDP protocol control blocks. One
   per active UDP "connection". */
#define MEMP_NUM_UDP_PCB        6
/* MEMP_NUM_TCP_PCB: the number of simultaneously active TCP
   connections. */
#define MEMP_NUM_TCP_PCB        10
/* MEMP_NUM_TCP_PCB_LISTEN: the number of listening TCP
   connections. */
#define MEMP_NUM_TCP_PCB_LISTEN 5
/* MEMP_NUM_TCP_SEG: the number of simultaneously queued TCP
   segments. */
#define MEMP_NUM_TCP_SEG        TCP_SND_QUEUELEN
/* MEMP_NUM_SYS_TIMEOUT: the number of simulateously active
   timeouts. */
#define MEMP_NUM_SYS_TIMEOUT    (LWIP_NUM_SYS_TIMEOUT_INTERNAL + 16)


/* ---------- Pbuf options ---------- */
/* PBUF_POOL_SIZE: the number of buffers in the pbuf pool. */
#define PBUF_POOL_SIZE          8

/* PBUF_POOL_BUFSIZE: the size of each pbuf in the pbuf pool. */
#define PBUF_POOL_BUFSIZE       1524

/* ---------- IPv4 options ---------- */
#define LWIP_IPV4                1
#define LWIP_IGMP                1

/* ---------- IPv6 options ---------- */
#define LWIP_IPV6                1
#define LWIP_ICMP6               1
#define LWIP_IPV6_AUTOCONFIG     1
#define LWIP_IPV6_MLD            1
#define LWIP_IPV6_NUM_ADDRESSES  2

/* ---------- TCP options ---------- */
#define LWIP_TCP                1
#define TCP_TTL                 255

/* Controls if TCP should queue segments that arrive out of
   order. Define to 0 if your device is low on memory. */
#define TCP_QUEUE_OOSEQ         0

/* TCP Maximum segment size. */
#define TCP_MSS                 (1500 - 40)	  /* TCP_MSS = (Ethernet MTU - IP header size - TCP header size) */

/* TCP sender buffer space (bytes). */
#define TCP_SND_BUF             (4*TCP_MSS)

/* TCP receive window. */
#define TCP_WND                 (2*TCP_MSS)


/* ---------- ICMP options ---------- */
#define LWIP_ICMP                       1


/* ---------- DHCP options ---------- */
#define LWIP_DHCP               1


/* ---------- UDP options ---------- */
#define LWIP_UDP                1
#define UDP_TTL                 255


/* ---------- Statistics options ---------- */
#define LWIP_STATS 0

/* ---------- link callback options ---------- */
/* LWIP_NETIF_LINK_CALLBACK==1: Support a callback function from an interface
 * whenever the link changes (i.e., link down)
 */
#define LWIP_NETIF_LINK_CALLBACK        1
#define LWIP_NETIF_HOSTNAME             1
#define LWIP_NETIF_EXT_STATUS_CALLBACK  1
#define LWIP_NUM_NETIF_CLIENT_DATA      1

/* ---------- mDNS options ---------- */
#define LWIP_MDNS_RESPONDER             1
#define LWIP_MDNS_SEARCH                0

/*
   --------------------------------------
   ---------- Checksum options ----------
   --------------------------------------
*/

/* CHECKSUM_GEN_IP==1: Generate checksums in software for outgoing IP packets.*/
#define CHECKSUM_GEN_IP                 1
/* CHECKSUM_GEN_UDP==1: Generate checksums in software for outgoing UDP packets.*/
#define CHECKSUM_GEN_UDP                1
/* CHECKSUM_GEN_TCP==1: Generate checksums in software for outgoing TCP packets.*/
#define CHECKSUM_GEN_TCP                1
/* CHECKSUM_CHECK_IP==1: Check checksums in software for incoming IP packets.*/
#define CHECKSUM_CHECK_IP               1
/* CHECKSUM_CHECK_UDP==1: Check checksums in software for incoming UDP packets.*/
#define CHECKSUM_CHECK_UDP              1
/* CHECKSUM_CHECK_TCP==1: Check checksums in software for incoming TCP packets.*/
#define CHECKSUM_CHECK_TCP              1
/* CHECKSUM_CHECK_ICMP==1: Check checksums by hardware for incoming ICMP packets.*/
#define CHECKSUM_GEN_ICMP               1


/*
   ----------------------------------------------
   ---------- Sequential layer options ----------
   ----------------------------------------------
*/
/**
 * LWIP_NETCONN==1: Enable Netconn API (require to use api_lib.c)
 */
#define LWIP_NETCONN                    1

/*
   ------------------------------------
   ---------- Socket options ----------
   ------------------------------------
*/
/**
 * LWIP_SOCKET==1: Enable Socket API (require to use sockets.c)
 */
#define LWIP_SOCKET                     1

/*
   ------------------------------------
   ---------- LWIP_NETIF_API options ----------
   ------------------------------------
*/
/**
 * LWIP_NETIF_API==1: Enable NETIF API
 */
#define LWIP_NETIF_API                     1

/*
   ---------------------------------
   ---------- OS options ----------
   ---------------------------------
*/

#define TCPIP_THREAD_NAME              "TCP/IP"
#define LWIP_TCPIP_CORE_LOCKING         1
#define LWIP_TCPIP_CORE_LOCKING_INPUT   0
#define TCPIP_THREAD_STACKSIZE          4096
#define TCPIP_MBOX_SIZE                 6
#define DEFAULT_UDP_RECVMBOX_SIZE       6
#define DEFAULT_TCP_RECVMBOX_SIZE       6
#define DEFAULT_ACCEPTMBOX_SIZE         6
#define DEFAULT_THREAD_STACKSIZE        500
#define TCPIP_THREAD_PRIO               40



#endif /* __LWIPOPTS_H__ */
