weiiwang01/magi/firmware/Core/Src/main.c

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
/* Includes ------------------------------------------------------------------*/
#include "main.h"
#include "cmsis_os.h"
#include "usbpd.h"
#include "usb_device.h"

/* USER CODE BEGIN Includes */
#include "adc.h"
#include "cdc.h"
#include "config.h"
#include "log.h"
#include "network.h"
#include "crypto.h"
#include "console.h"
#include "switch.h"
#include "tcpm.h"
#include "timeout.h"
#include "unit.h"
#include "usb_hub.h"
#include "usbpd_dpm_core.h"
#include "ws2812.h"
/* USER CODE END Includes */


/* Definitions for defaultTask */
osThreadId_t defaultTaskHandle;
const osThreadAttr_t defaultTask_attributes = {
  .name = "defaultTask",
  .priority = (osPriority_t) osPriorityNormal,
  .stack_size = 512 * 4
};
void SystemClock_Config(void);
static void MX_GPIO_Init(void);
static void MX_DMA_Init(void);
static void MX_UCPD1_Init(void);
static void MX_UCPD2_Init(void);
void StartDefaultTask(void *argument);

/**
  * @brief  The application entry point.
  * @retval int
  */
int main(void)
{

  /* USER CODE BEGIN 1 */
  /* ES0548 2.2.10: cross-bank execution requires flash prefetch disabled. */
  __HAL_FLASH_PREFETCH_BUFFER_DISABLE();
  /* USER CODE END 1 */

  /* MCU Configuration--------------------------------------------------------*/

  /* Reset of all peripherals, Initializes the Flash interface and the Systick. */
  HAL_Init();

  /* Configure the system clock */
  SystemClock_Config();

  /* USER CODE BEGIN SysInit */
  timeout_timer_init();
  /* USER CODE END SysInit */

  /* Initialize all configured peripherals */
  MX_GPIO_Init();
  MX_DMA_Init();
  MX_UCPD1_Init();
  MX_UCPD2_Init();
  /* USER CODE BEGIN 2 */
  log_init();
  config_load();
  console_init();
  adc_init();
  usb_hub_init();
  ws2812_init();
  switch_init();
  /* USER CODE END 2 */

  /* Init scheduler */
  osKernelInitialize();
  /* USBPD initialisation ---------------------------------*/
  MX_USBPD_Init();

  /* USER CODE BEGIN RTOS_MUTEX */
  /* add mutexes, ... */
  /* USER CODE END RTOS_MUTEX */

  /* USER CODE BEGIN RTOS_SEMAPHORES */
  /* add semaphores, ... */
  /* USER CODE END RTOS_SEMAPHORES */

  /* USER CODE BEGIN RTOS_TIMERS */
  /* start timers, add new ones, ... */
  /* USER CODE END RTOS_TIMERS */

  /* USER CODE BEGIN RTOS_QUEUES */
  /* add queues, ... */
  /* USER CODE END RTOS_QUEUES */

  /* Create the thread(s) */
  /* creation of defaultTask */
  defaultTaskHandle = osThreadNew(StartDefaultTask, NULL, &defaultTask_attributes);

  /* USER CODE BEGIN RTOS_THREADS */
  unit_init();
  network_init();
  crypto_init();
  /* USER CODE END RTOS_THREADS */

  /* USER CODE BEGIN RTOS_EVENTS */
  /* add events, ... */
  /* USER CODE END RTOS_EVENTS */

  /* Start scheduler */
  osKernelStart();

  /* We should never get here as control is now taken by the scheduler */

  /* Infinite loop */
  /* USER CODE BEGIN WHILE */
  while (1)
  {
    /* USER CODE END WHILE */

    /* USER CODE BEGIN 3 */
  }
  /* USER CODE END 3 */
}

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
/* USER CODE BEGIN Header_StartDefaultTask */
/**
  * @brief  Function implementing the defaultTask thread.
  * @param  argument: Not used
  * @retval None
  */
/* USER CODE END Header_StartDefaultTask */
void StartDefaultTask(void *argument)
{
  /* init code for USB_Device */
  MX_USB_Device_Init();
  /* USER CODE BEGIN 5 */
  cdc_init();
  tcpm_sgmii_status_t last_sgmii_status = {0};

  /* Infinite loop */
  for(;;)
  {
    switch_port_status_t sgmii_status = {0};
    uint8_t r = 12, g = 0, b = 0;

    tcpm_sgmii_status_t sgmii = tcpm_get_sgmii_status(tcpm, TCPM_PORT_1);
    if (sgmii.cycles != last_sgmii_status.cycles
        || (!sgmii.active && last_sgmii_status.active))
    {
      if (0 == switch_disable_sgmii())
      {
        last_sgmii_status.cycles = sgmii.cycles;
        last_sgmii_status.active = false;
      }
    }
    else if (sgmii.active && !last_sgmii_status.active)
    {
      if (0 == switch_enable_sgmii(SWITCH_PROTOCOL_HSGMII,
                                   SWITCH_SPEED_2500M,
                                   SWITCH_DUPLEX_FULL))
      {
        last_sgmii_status.active = true;
      }
    }

    if (last_sgmii_status.active
        && (0 == switch_get_port_status(SWITCH_EXT_PORT0, &sgmii_status))
        && sgmii_status.link)
    {
      b = 8;
    }
    if (adc_get_usb_voltage(USB0) > 19000 || adc_get_usb_voltage(USB1) > 19000) {
      g = 8;
    }
    ws2812_set_rgb(0, r,g,b);
    timeout_sleep_ms(100);
  }
  /* USER CODE END 5 */
}

/**
  * @brief  Period elapsed callback in non blocking mode
  * @note   This function is called  when TIM17 interrupt took place, inside
  * HAL_TIM_IRQHandler(). It makes a direct call to HAL_IncTick() to increment
  * a global variable "uwTick" used as application time base.
  * @param  htim : TIM handle
  * @retval None
  */
void HAL_TIM_PeriodElapsedCallback(TIM_HandleTypeDef *htim)
{
  if (htim->Instance == TIM17)
  {
    HAL_IncTick();
  }
  /* USER CODE BEGIN Callback 1 */
  if (htim->Instance == TIM17)
  {
    USBPD_DPM_TimerCounter();
  }
  /* USER CODE END Callback 1 */
}

/**
  * @brief  This function is executed in case of error occurrence.
  * @retval None
  */
void Error_Handler(void)
{
  /* USER CODE BEGIN Error_Handler_Debug */
  /* User can add his own implementation to report the HAL error return state */
  __disable_irq();
  while (1)
  {
  }
  /* USER CODE END Error_Handler_Debug */
}
#ifdef USE_FULL_ASSERT
/**
  * @brief  Reports the name of the source file and the source line number
  *         where the assert_param error has occurred.
  * @param  file: pointer to the source file name
  * @param  line: assert_param error line source number
  * @retval None
  */
void assert_failed(uint8_t *file, uint32_t line)
{
  /* USER CODE BEGIN 6 */
  /* User can add his own implementation to report the file name and line number,
     ex: printf("Wrong parameters value: file %s on line %d\r\n", file, line) */
  /* USER CODE END 6 */
}
#endif /* USE_FULL_ASSERT */
