weiiwang01/magi/firmware/magi.ioc

Mcu.UserName=STM32G0B1VETx
PA10.Signal=UCPD1_DBCC2
PA2.Signal=RCC_LSCO
PA8.Signal=UCPD1_CC1
PA9.Signal=UCPD1_DBCC1
PB15.Signal=UCPD1_CC2
PD0.Signal=UCPD2_CC1
PD1.Signal=UCPD2_DBCC1
PD2.Signal=UCPD2_CC2
PD3.Signal=UCPD2_DBCC2
