weiiwang01/magi/firmware/Core/Inc/user_settings.h

#ifndef MAGI_USER_SETTINGS_H
#define MAGI_USER_SETTINGS_H

#define WOLFCRYPT_ONLY
#define WOLFSSL_WOLFSSH
#define FREERTOS
#define WOLFSSL_USER_IO
#define WOLFSSL_NO_SOCK
#define WOLFSSH_USER_IO
#define WOLFSSH_NO_AUTO_CHANNEL_EOF
#define WOLFSSH_TERM
#define NO_TERMIOS
#define WOLFSSL_NO_ATOMICS
#define NO_FILESYSTEM
#define WOLFSSH_NO_FILESYSTEM
#define NO_WRITEV
#define NO_DEV_RANDOM
#define NO_MAIN_DRIVER
#define NO_CRYPT_TEST
#define NO_CRYPT_BENCHMARK
#define NO_ERROR_STRINGS
#define NO_OLD_RNGNAME
#define WOLFSSL_IGNORE_FILE_WARN
#define WOLFSSL_SMALL_STACK
#define WOLFSSH_SMALL_STACK
#define SIZEOF_LONG_LONG 8
#define WOLFSSL_GENERAL_ALIGNMENT 4

/* Only P-256 math, with the small portable implementation for Cortex-M0+. */
#define HAVE_ECC
#define ECC_USER_CURVES
#define ECC_TIMING_RESISTANT
#define WOLFSSL_SP_MATH
#define WOLFSSL_HAVE_SP_ECC
#define WOLFSSL_SP_SMALL
#define SP_WORD_SIZE 32
#define WOLFSSL_ATECC608A
#define WOLFSSH_ATECC_HOSTKEY
#define ATECC_SLOT_AUTH_PRIV 1
#define WOLFSSL_ATECC_NO_ECDH_ENC

#define NO_RSA
#define NO_DH
#define NO_DSA
#define NO_DES3
#define NO_RC4
#define NO_MD4
#define NO_MD5
#define NO_SHA
#define NO_SHA512
#define NO_SHA256_ASM
#define NO_PWDBASED
#define NO_PSK
#define NO_CERTS
#define NO_ASN_TIME
#define NO_SESSION_CACHE
#define WOLFSSL_NO_TLS12
#define WOLFSSL_NO_TLS13
#define WOLFSSL_NO_SHAKE128
#define WOLFSSL_NO_SHAKE256

#define WOLFSSL_AES_COUNTER
#define WOLFSSL_AES_DIRECT
#define NO_AES_DECRYPT
#define NO_AES_CBC
#define NO_AES_192
#define NO_AES_256
#define AES_MAX_KEY_SIZE 128
#define WOLFSSL_BASE64_ENCODE

int atmel_get_random_block(unsigned char *output, unsigned int size);
#define ATMEL_GET_RANDOM_BLOCK_DEFINED
#define CUSTOM_RAND_GENERATE_SEED atmel_get_random_block

#define NO_WOLFSSH_CLIENT
#define WOLFSSH_NO_AES_CBC
#define WOLFSSH_NO_AES_GCM
#define WOLFSSH_NO_ECDSA_SHA2_NISTP384
#define WOLFSSH_NO_ECDSA_SHA2_NISTP521
#define WOLFSSH_NO_ECDH_SHA2_NISTP384
#define WOLFSSH_NO_ECDH_SHA2_NISTP521
#define DEFAULT_WINDOW_SZ 2048
#define DEFAULT_MAX_PACKET_SZ 2048
#define MAX_PACKET_SZ 4096
#define DEFAULT_HIGHWATER_MARK (64U * 1024U * 1024U)

#endif
