weiiwang01/magi/firmware/Core/Inc/board.h

#ifndef BOARD_H
#define BOARD_H

#include "main.h"

#if !defined(BOARD_VERSION) || (BOARD_VERSION != 0x0200 && BOARD_VERSION != 0x0201)
#error "BOARD_VERSION must be 0x0200 or 0x0201"
#endif

#define BOARD_UNIT_3V3_SENSE_IRQn EXTI4_15_IRQn

#if BOARD_VERSION == 0x0200
#define BOARD_BUTTON_GPIO_PORT GPIOD
#define BOARD_BUTTON_GPIO_PIN GPIO_PIN_6
#define BOARD_BUTTON_GPIO_CLK_ENABLE() __HAL_RCC_GPIOD_CLK_ENABLE()
#endif

#if BOARD_VERSION == 0x0201
#define BOARD_BUTTON_GPIO_PORT GPIOB
#define BOARD_BUTTON_GPIO_PIN GPIO_PIN_0
#define BOARD_BUTTON_GPIO_CLK_ENABLE() __HAL_RCC_GPIOB_CLK_ENABLE()

#define BOARD_CRYPTO_UART_INSTANCE USART6
#define BOARD_CRYPTO_UART_CLK_ENABLE() __HAL_RCC_USART6_CLK_ENABLE()
#define BOARD_CRYPTO_UART_CLK_DISABLE() __HAL_RCC_USART6_CLK_DISABLE()
#define BOARD_CRYPTO_UART_GPIO_PORT GPIOF
#define BOARD_CRYPTO_UART_GPIO_PIN GPIO_PIN_9
#define BOARD_CRYPTO_UART_GPIO_AF GPIO_AF3_USART6
#define BOARD_CRYPTO_UART_GPIO_CLK_ENABLE() __HAL_RCC_GPIOF_CLK_ENABLE()
#define BOARD_CRYPTO_UART_DMA_INSTANCE DMA2_Channel4
#define BOARD_CRYPTO_UART_DMA_REQUEST DMA_REQUEST_USART6_RX
#define BOARD_CRYPTO_UART_DMA_CLK_ENABLE() __HAL_RCC_DMA2_CLK_ENABLE()
#endif

#define BOARD_LOG_UART_INSTANCE USART5
#define BOARD_LOG_UART_CLK_ENABLE() __HAL_RCC_USART5_CLK_ENABLE()
#define BOARD_LOG_UART_IRQn USART3_4_5_6_LPUART1_IRQn

#define BOARD_LOG_UART_DMA_INSTANCE DMA2_Channel1
#define BOARD_LOG_UART_DMA_REQUEST DMA_REQUEST_USART5_TX
#define BOARD_LOG_UART_DMA_CLK_ENABLE() __HAL_RCC_DMA2_CLK_ENABLE()
#define BOARD_LOG_UART_DMA_IRQn DMA1_Ch4_7_DMA2_Ch1_5_DMAMUX1_OVR_IRQn

#define BOARD_LOG_UART_GPIO_PORT GPIOE
#define BOARD_LOG_UART_GPIO_PIN GPIO_PIN_10
#define BOARD_LOG_UART_GPIO_AF GPIO_AF3_USART5
#define BOARD_LOG_UART_GPIO_CLK_ENABLE() __HAL_RCC_GPIOE_CLK_ENABLE()

#define BOARD_WS2812_TIM_INSTANCE TIM3
#define BOARD_WS2812_TIM_CHANNEL TIM_CHANNEL_1
#define BOARD_WS2812_TIM_DMA_ID TIM_DMA_ID_CC1
#define BOARD_WS2812_TIM_CLK_ENABLE() __HAL_RCC_TIM3_CLK_ENABLE()

#define BOARD_WS2812_DMA_INSTANCE DMA2_Channel2
#define BOARD_WS2812_DMA_REQUEST DMA_REQUEST_TIM3_CH1

#define BOARD_WS2812_GPIO_PORT GPIOE
#define BOARD_WS2812_GPIO_PIN GPIO_PIN_3
#define BOARD_WS2812_GPIO_AF GPIO_AF1_TIM3
#define BOARD_WS2812_GPIO_CLK_ENABLE() __HAL_RCC_GPIOE_CLK_ENABLE()

#if BOARD_VERSION == 0x0200
#define BOARD_WS2812_GPIO_MODE GPIO_MODE_AF_OD
#endif
#if BOARD_VERSION == 0x0201
#define BOARD_WS2812_GPIO_MODE GPIO_MODE_AF_PP
#endif

#define BOARD_ADC_INSTANCE ADC1
#define BOARD_ADC_CLK_ENABLE() __HAL_RCC_ADC_CLK_ENABLE()

#define BOARD_ADC_DMA_INSTANCE DMA2_Channel3
#define BOARD_ADC_DMA_REQUEST DMA_REQUEST_ADC1

#define BOARD_ADC_USB0_VBUS_VOLTAGE_GPIO_PORT GPIOA
#define BOARD_ADC_USB0_VBUS_VOLTAGE_GPIO_CLK_ENABLE() __HAL_RCC_GPIOA_CLK_ENABLE()
#define BOARD_ADC_USB0_VBUS_VOLTAGE_GPIO_PIN GPIO_PIN_4
#define BOARD_ADC_USB0_VBUS_VOLTAGE_CHANNEL ADC_CHANNEL_4
#define BOARD_ADC_USB0_VBUS_VOLTAGE_RESULT_INDEX 0U

#define BOARD_ADC_USB0_INPUT_CURRENT_GPIO_PORT GPIOB
#define BOARD_ADC_USB0_INPUT_CURRENT_GPIO_CLK_ENABLE() __HAL_RCC_GPIOB_CLK_ENABLE()
#define BOARD_ADC_USB0_INPUT_CURRENT_GPIO_PIN GPIO_PIN_11
#define BOARD_ADC_USB0_INPUT_CURRENT_CHANNEL ADC_CHANNEL_15
#define BOARD_ADC_USB0_INPUT_CURRENT_RESULT_INDEX 5U

#define BOARD_ADC_USB1_VBUS_VOLTAGE_GPIO_PORT GPIOB
#define BOARD_ADC_USB1_VBUS_VOLTAGE_GPIO_CLK_ENABLE() __HAL_RCC_GPIOB_CLK_ENABLE()
#define BOARD_ADC_USB1_VBUS_VOLTAGE_GPIO_PIN GPIO_PIN_10
#define BOARD_ADC_USB1_VBUS_VOLTAGE_CHANNEL ADC_CHANNEL_11
#define BOARD_ADC_USB1_VBUS_VOLTAGE_RESULT_INDEX 2U

#define BOARD_ADC_USB1_INPUT_CURRENT_GPIO_PORT GPIOB
#define BOARD_ADC_USB1_INPUT_CURRENT_GPIO_CLK_ENABLE() __HAL_RCC_GPIOB_CLK_ENABLE()
#define BOARD_ADC_USB1_INPUT_CURRENT_GPIO_PIN GPIO_PIN_12
#define BOARD_ADC_USB1_INPUT_CURRENT_CHANNEL ADC_CHANNEL_16
#define BOARD_ADC_USB1_INPUT_CURRENT_RESULT_INDEX 6U

#define BOARD_ADC_USB1_OUTPUT_CURRENT_GPIO_PORT GPIOB
#define BOARD_ADC_USB1_OUTPUT_CURRENT_GPIO_CLK_ENABLE() __HAL_RCC_GPIOB_CLK_ENABLE()
#define BOARD_ADC_USB1_OUTPUT_CURRENT_GPIO_PIN GPIO_PIN_2
#define BOARD_ADC_USB1_OUTPUT_CURRENT_CHANNEL ADC_CHANNEL_10
#define BOARD_ADC_USB1_OUTPUT_CURRENT_RESULT_INDEX 1U

#define BOARD_ADC_TEMPERATURE_CHANNEL ADC_CHANNEL_TEMPSENSOR
#define BOARD_ADC_TEMPERATURE_RESULT_INDEX 3U

#define BOARD_ADC_VBAT_CHANNEL ADC_CHANNEL_VBAT
#define BOARD_ADC_VBAT_RESULT_INDEX 4U

#define BOARD_ADC_RESULT_COUNT 7U

#define BOARD_USB0_POWER_5V_ENABLE_GPIO_PORT GPIOA
#define BOARD_USB0_POWER_5V_ENABLE_GPIO_PIN GPIO_PIN_3
#define BOARD_USB0_POWER_5V_ENABLE_GPIO_CLK_ENABLE() __HAL_RCC_GPIOA_CLK_ENABLE()

#define BOARD_USB0_VBUS_DISCHARGE_GPIO_PORT GPIOE
#define BOARD_USB0_VBUS_DISCHARGE_GPIO_PIN GPIO_PIN_8
#define BOARD_USB0_VBUS_DISCHARGE_GPIO_CLK_ENABLE() __HAL_RCC_GPIOE_CLK_ENABLE()

#define BOARD_USB0_DATA_ENABLE_GPIO_PORT GPIOE
#define BOARD_USB0_DATA_ENABLE_GPIO_PIN GPIO_PIN_11
#define BOARD_USB0_DATA_ENABLE_GPIO_CLK_ENABLE() __HAL_RCC_GPIOE_CLK_ENABLE()

#define BOARD_USB0_DATA_POL_GPIO_PORT GPIOE
#define BOARD_USB0_DATA_POL_GPIO_PIN GPIO_PIN_9
#define BOARD_USB0_DATA_POL_GPIO_CLK_ENABLE() __HAL_RCC_GPIOE_CLK_ENABLE()

#define BOARD_USB1_POWER_5V_ENABLE_GPIO_PORT GPIOA
#define BOARD_USB1_POWER_5V_ENABLE_GPIO_PIN GPIO_PIN_1
#define BOARD_USB1_POWER_5V_ENABLE_GPIO_CLK_ENABLE() __HAL_RCC_GPIOA_CLK_ENABLE()

#define BOARD_USB1_POWER_20V_ENABLE_GPIO_PORT GPIOE
#define BOARD_USB1_POWER_20V_ENABLE_GPIO_PIN GPIO_PIN_12
#define BOARD_USB1_POWER_20V_ENABLE_GPIO_CLK_ENABLE() __HAL_RCC_GPIOE_CLK_ENABLE()

#define BOARD_USB1_VBUS_DISCHARGE_GPIO_PORT GPIOC
#define BOARD_USB1_VBUS_DISCHARGE_GPIO_PIN GPIO_PIN_9
#define BOARD_USB1_VBUS_DISCHARGE_GPIO_CLK_ENABLE() __HAL_RCC_GPIOC_CLK_ENABLE()

#define BOARD_USB1_HS_ENABLE_GPIO_PORT GPIOC
#define BOARD_USB1_HS_ENABLE_GPIO_PIN GPIO_PIN_1
#define BOARD_USB1_HS_ENABLE_GPIO_CLK_ENABLE() __HAL_RCC_GPIOC_CLK_ENABLE()

#define BOARD_USB1_SS_ENABLE_GPIO_PORT GPIOF
#define BOARD_USB1_SS_ENABLE_GPIO_PIN GPIO_PIN_5
#define BOARD_USB1_SS_ENABLE_GPIO_CLK_ENABLE() __HAL_RCC_GPIOF_CLK_ENABLE()

#define BOARD_USB1_SS_POL_GPIO_PORT GPIOC
#if BOARD_VERSION == 0x0200
#define BOARD_USB1_SS_POL_GPIO_PIN GPIO_PIN_12
#endif
#if BOARD_VERSION == 0x0201
#define BOARD_USB1_SS_POL_GPIO_PIN GPIO_PIN_13
#endif
#define BOARD_USB1_SS_POL_GPIO_CLK_ENABLE() __HAL_RCC_GPIOC_CLK_ENABLE()

#define BOARD_USB1_SS_AMSEL_GPIO_PORT GPIOF
#define BOARD_USB1_SS_AMSEL_GPIO_PIN GPIO_PIN_0
#define BOARD_USB1_SS_AMSEL_GPIO_CLK_ENABLE() __HAL_RCC_GPIOF_CLK_ENABLE()

#define BOARD_USB1_SS_EN_GPIO_PORT GPIOF
#define BOARD_USB1_SS_EN_GPIO_PIN GPIO_PIN_4
#define BOARD_USB1_SS_EN_GPIO_CLK_ENABLE() __HAL_RCC_GPIOF_CLK_ENABLE()

#define BOARD_USB_HUB_I2C_SCL_GPIO_PORT GPIOE
#define BOARD_USB_HUB_I2C_SCL_GPIO_PIN GPIO_PIN_5
#define BOARD_USB_HUB_I2C_SCL_GPIO_CLK_ENABLE() __HAL_RCC_GPIOE_CLK_ENABLE()

#define BOARD_USB_HUB_I2C_SDA_GPIO_PORT GPIOE
#define BOARD_USB_HUB_I2C_SDA_GPIO_PIN GPIO_PIN_6
#define BOARD_USB_HUB_I2C_SDA_GPIO_CLK_ENABLE() __HAL_RCC_GPIOE_CLK_ENABLE()

#if BOARD_VERSION == 0x0201
#define BOARD_USB_HUB_RESET_GPIO_PORT GPIOF
#define BOARD_USB_HUB_RESET_GPIO_PIN GPIO_PIN_1
#define BOARD_USB_HUB_RESET_GPIO_CLK_ENABLE() __HAL_RCC_GPIOF_CLK_ENABLE()
#endif

#define BOARD_USB_HUB_PORT_SWAP ((1U << 1U) | (1U << 2U))
#define BOARD_USB_HUB_PORT_MAP_12 0x32U
#define BOARD_USB_HUB_PORT_MAP_34 0x14U

#define BOARD_XPANDER_SPI_INSTANCE SPI3
#define BOARD_XPANDER_SPI_CLK_ENABLE() __HAL_RCC_SPI3_CLK_ENABLE()

#define BOARD_XPANDER_SPI_SCK_GPIO_PORT GPIOB
#define BOARD_XPANDER_SPI_SCK_GPIO_PIN GPIO_PIN_3
#define BOARD_XPANDER_SPI_SCK_GPIO_AF GPIO_AF9_SPI3
#define BOARD_XPANDER_SPI_SCK_GPIO_CLK_ENABLE() __HAL_RCC_GPIOB_CLK_ENABLE()

#define BOARD_XPANDER_SPI_MISO_GPIO_PORT GPIOB
#define BOARD_XPANDER_SPI_MISO_GPIO_PIN GPIO_PIN_4
#define BOARD_XPANDER_SPI_MISO_GPIO_AF GPIO_AF9_SPI3
#define BOARD_XPANDER_SPI_MISO_GPIO_CLK_ENABLE() __HAL_RCC_GPIOB_CLK_ENABLE()

#define BOARD_XPANDER_SPI_MOSI_GPIO_PORT GPIOB
#define BOARD_XPANDER_SPI_MOSI_GPIO_PIN GPIO_PIN_5
#define BOARD_XPANDER_SPI_MOSI_GPIO_AF GPIO_AF9_SPI3
#define BOARD_XPANDER_SPI_MOSI_GPIO_CLK_ENABLE() __HAL_RCC_GPIOB_CLK_ENABLE()

#define BOARD_XPANDER_CS_GPIO_PORT GPIOE
#define BOARD_XPANDER_CS_GPIO_PIN GPIO_PIN_0
#define BOARD_XPANDER_CS_GPIO_CLK_ENABLE() __HAL_RCC_GPIOE_CLK_ENABLE()

#define BOARD_CH390_SPI_INSTANCE SPI2
#define BOARD_CH390_SPI_CLK_ENABLE() __HAL_RCC_SPI2_CLK_ENABLE()

#define BOARD_CH390_SPI_SCK_GPIO_PORT GPIOA
#define BOARD_CH390_SPI_SCK_GPIO_PIN GPIO_PIN_0
#define BOARD_CH390_SPI_SCK_GPIO_AF GPIO_AF0_SPI2
#define BOARD_CH390_SPI_SCK_GPIO_CLK_ENABLE() __HAL_RCC_GPIOA_CLK_ENABLE()

#define BOARD_CH390_SPI_MISO_GPIO_PORT GPIOC
#define BOARD_CH390_SPI_MISO_GPIO_PIN GPIO_PIN_2
#define BOARD_CH390_SPI_MISO_GPIO_AF GPIO_AF1_SPI2
#define BOARD_CH390_SPI_MISO_GPIO_CLK_ENABLE() __HAL_RCC_GPIOC_CLK_ENABLE()

#define BOARD_CH390_SPI_MOSI_GPIO_PORT GPIOC
#define BOARD_CH390_SPI_MOSI_GPIO_PIN GPIO_PIN_3
#define BOARD_CH390_SPI_MOSI_GPIO_AF GPIO_AF1_SPI2
#define BOARD_CH390_SPI_MOSI_GPIO_CLK_ENABLE() __HAL_RCC_GPIOC_CLK_ENABLE()

#define BOARD_CH390_CS_GPIO_PORT GPIOC
#define BOARD_CH390_CS_GPIO_PIN GPIO_PIN_0
#define BOARD_CH390_CS_GPIO_CLK_ENABLE() __HAL_RCC_GPIOC_CLK_ENABLE()

#define BOARD_CH390_RESET_GPIO_PORT GPIOF
#define BOARD_CH390_RESET_GPIO_PIN GPIO_PIN_12
#define BOARD_CH390_RESET_GPIO_CLK_ENABLE() __HAL_RCC_GPIOF_CLK_ENABLE()

#define BOARD_CH390_INTERRUPT_GPIO_PORT GPIOF
#define BOARD_CH390_INTERRUPT_GPIO_PIN GPIO_PIN_13
#define BOARD_CH390_INTERRUPT_GPIO_CLK_ENABLE() __HAL_RCC_GPIOF_CLK_ENABLE()
#define BOARD_CH390_INTERRUPT_IRQn EXTI4_15_IRQn

#define BOARD_SWITCH_RESET_GPIO_PORT GPIOF
#define BOARD_SWITCH_RESET_GPIO_PIN GPIO_PIN_11
#define BOARD_SWITCH_RESET_GPIO_CLK_ENABLE() __HAL_RCC_GPIOF_CLK_ENABLE()

#define BOARD_SWITCH_SMI_SCL_GPIO_PORT GPIOF
#define BOARD_SWITCH_SMI_SCL_GPIO_PIN GPIO_PIN_10
#define BOARD_SWITCH_SMI_SCL_GPIO_CLK_ENABLE() __HAL_RCC_GPIOF_CLK_ENABLE()

#define BOARD_SWITCH_SMI_SDA_GPIO_PORT GPIOD
#define BOARD_SWITCH_SMI_SDA_GPIO_PIN GPIO_PIN_7
#define BOARD_SWITCH_SMI_SDA_GPIO_CLK_ENABLE() __HAL_RCC_GPIOD_CLK_ENABLE()

#define BOARD_UNIT1_POWER_GPIO_PORT GPIOD
#define BOARD_UNIT1_POWER_GPIO_PIN GPIO_PIN_10
#define BOARD_UNIT1_POWER_GPIO_CLK_ENABLE() __HAL_RCC_GPIOD_CLK_ENABLE()

#define BOARD_UNIT1_PCIE_POWER_GPIO_PORT GPIOD
#define BOARD_UNIT1_PCIE_POWER_GPIO_PIN GPIO_PIN_12
#define BOARD_UNIT1_PCIE_POWER_GPIO_CLK_ENABLE() __HAL_RCC_GPIOD_CLK_ENABLE()

#define BOARD_UNIT1_POWER_BUTTON_GPIO_PORT GPIOE
#define BOARD_UNIT1_POWER_BUTTON_GPIO_PIN GPIO_PIN_4
#define BOARD_UNIT1_POWER_BUTTON_GPIO_CLK_ENABLE() __HAL_RCC_GPIOE_CLK_ENABLE()

#define BOARD_UNIT1_RPIBOOT_GPIO_PORT GPIOC
#if BOARD_VERSION == 0x0200
#define BOARD_UNIT1_RPIBOOT_GPIO_PIN GPIO_PIN_13
#endif
#if BOARD_VERSION == 0x0201
#define BOARD_UNIT1_RPIBOOT_GPIO_PIN GPIO_PIN_12
#endif
#define BOARD_UNIT1_RPIBOOT_GPIO_CLK_ENABLE() __HAL_RCC_GPIOC_CLK_ENABLE()

#define BOARD_UNIT1_ACTIVITY_LED_GPIO_PORT GPIOF
#define BOARD_UNIT1_ACTIVITY_LED_GPIO_PIN GPIO_PIN_3
#define BOARD_UNIT1_ACTIVITY_LED_GPIO_CLK_ENABLE() __HAL_RCC_GPIOF_CLK_ENABLE()

#define BOARD_UNIT1_POWER_LED_GPIO_PORT GPIOB
#define BOARD_UNIT1_POWER_LED_GPIO_PIN GPIO_PIN_6
#define BOARD_UNIT1_POWER_LED_GPIO_CLK_ENABLE() __HAL_RCC_GPIOB_CLK_ENABLE()

#define BOARD_UNIT1_3V3_SENSE_GPIO_PORT GPIOB
#define BOARD_UNIT1_3V3_SENSE_GPIO_PIN GPIO_PIN_7
#define BOARD_UNIT1_3V3_SENSE_GPIO_CLK_ENABLE() __HAL_RCC_GPIOB_CLK_ENABLE()

#define BOARD_UNIT1_WS2812_INDEX 1U

#define BOARD_UNIT2_POWER_GPIO_PORT GPIOE
#define BOARD_UNIT2_POWER_GPIO_PIN GPIO_PIN_13
#define BOARD_UNIT2_POWER_GPIO_CLK_ENABLE() __HAL_RCC_GPIOE_CLK_ENABLE()

#define BOARD_UNIT2_PCIE_POWER_GPIO_PORT GPIOD
#define BOARD_UNIT2_PCIE_POWER_GPIO_PIN GPIO_PIN_4
#define BOARD_UNIT2_PCIE_POWER_GPIO_CLK_ENABLE() __HAL_RCC_GPIOD_CLK_ENABLE()

#define BOARD_UNIT2_POWER_BUTTON_GPIO_PORT GPIOF
#define BOARD_UNIT2_POWER_BUTTON_GPIO_PIN GPIO_PIN_6
#define BOARD_UNIT2_POWER_BUTTON_GPIO_CLK_ENABLE() __HAL_RCC_GPIOF_CLK_ENABLE()

#define BOARD_UNIT2_RPIBOOT_GPIO_PORT GPIOF
#define BOARD_UNIT2_RPIBOOT_GPIO_PIN GPIO_PIN_7
#define BOARD_UNIT2_RPIBOOT_GPIO_CLK_ENABLE() __HAL_RCC_GPIOF_CLK_ENABLE()

#define BOARD_UNIT2_ACTIVITY_LED_GPIO_PORT GPIOB
#define BOARD_UNIT2_ACTIVITY_LED_GPIO_PIN GPIO_PIN_1
#define BOARD_UNIT2_ACTIVITY_LED_GPIO_CLK_ENABLE() __HAL_RCC_GPIOB_CLK_ENABLE()

#define BOARD_UNIT2_POWER_LED_GPIO_PORT GPIOE
#define BOARD_UNIT2_POWER_LED_GPIO_PIN GPIO_PIN_7
#define BOARD_UNIT2_POWER_LED_GPIO_CLK_ENABLE() __HAL_RCC_GPIOE_CLK_ENABLE()

#define BOARD_UNIT2_3V3_SENSE_GPIO_PORT GPIOA
#define BOARD_UNIT2_3V3_SENSE_GPIO_PIN GPIO_PIN_5
#define BOARD_UNIT2_3V3_SENSE_GPIO_CLK_ENABLE() __HAL_RCC_GPIOA_CLK_ENABLE()

#define BOARD_CONSOLE_DMA_IRQn DMA1_Ch4_7_DMA2_Ch1_5_DMAMUX1_OVR_IRQn
#define BOARD_CONSOLE_DMA_CLK_ENABLE() __HAL_RCC_DMA1_CLK_ENABLE()

#define BOARD_UNIT1_CONSOLE_INSTANCE USART4
#define BOARD_UNIT1_CONSOLE_CLK_ENABLE() __HAL_RCC_USART4_CLK_ENABLE()
#define BOARD_UNIT1_CONSOLE_IRQn USART3_4_5_6_LPUART1_IRQn
#define BOARD_UNIT1_CONSOLE_GPIO_PORT GPIOC
#define BOARD_UNIT1_CONSOLE_TX_PIN GPIO_PIN_10
#define BOARD_UNIT1_CONSOLE_RX_PIN GPIO_PIN_11
#define BOARD_UNIT1_CONSOLE_GPIO_AF GPIO_AF1_USART4
#define BOARD_UNIT1_CONSOLE_GPIO_CLK_ENABLE() __HAL_RCC_GPIOC_CLK_ENABLE()
#define BOARD_UNIT1_CONSOLE_DMA_INSTANCE DMA1_Channel5
#define BOARD_UNIT1_CONSOLE_DMA_REQUEST DMA_REQUEST_USART4_TX

#define BOARD_UNIT2_CONSOLE_INSTANCE USART1
#define BOARD_UNIT2_CONSOLE_CLK_ENABLE() __HAL_RCC_USART1_CLK_ENABLE()
#define BOARD_UNIT2_CONSOLE_IRQn USART1_IRQn
#define BOARD_UNIT2_CONSOLE_GPIO_PORT GPIOC
#define BOARD_UNIT2_CONSOLE_TX_PIN GPIO_PIN_4
#define BOARD_UNIT2_CONSOLE_RX_PIN GPIO_PIN_5
#define BOARD_UNIT2_CONSOLE_GPIO_AF GPIO_AF1_USART1
#define BOARD_UNIT2_CONSOLE_GPIO_CLK_ENABLE() __HAL_RCC_GPIOC_CLK_ENABLE()
#define BOARD_UNIT2_CONSOLE_DMA_INSTANCE DMA1_Channel6
#define BOARD_UNIT2_CONSOLE_DMA_REQUEST DMA_REQUEST_USART1_TX

#define BOARD_UNIT3_CONSOLE_INSTANCE USART3
#define BOARD_UNIT3_CONSOLE_CLK_ENABLE() __HAL_RCC_USART3_CLK_ENABLE()
#define BOARD_UNIT3_CONSOLE_IRQn USART3_4_5_6_LPUART1_IRQn
#define BOARD_UNIT3_CONSOLE_GPIO_PORT GPIOD
#define BOARD_UNIT3_CONSOLE_TX_PIN GPIO_PIN_8
#define BOARD_UNIT3_CONSOLE_RX_PIN GPIO_PIN_9
#define BOARD_UNIT3_CONSOLE_GPIO_AF GPIO_AF0_USART3
#define BOARD_UNIT3_CONSOLE_GPIO_CLK_ENABLE() __HAL_RCC_GPIOD_CLK_ENABLE()
#define BOARD_UNIT3_CONSOLE_DMA_INSTANCE DMA1_Channel7
#define BOARD_UNIT3_CONSOLE_DMA_REQUEST DMA_REQUEST_USART3_TX

#define BOARD_UNIT2_WS2812_INDEX 2U

#define BOARD_UNIT3_POWER_GPIO_PORT GPIOD
#define BOARD_UNIT3_POWER_GPIO_PIN GPIO_PIN_13
#define BOARD_UNIT3_POWER_GPIO_CLK_ENABLE() __HAL_RCC_GPIOD_CLK_ENABLE()

#define BOARD_UNIT3_PCIE_POWER_GPIO_PORT GPIOE
#define BOARD_UNIT3_PCIE_POWER_GPIO_PIN GPIO_PIN_14
#define BOARD_UNIT3_PCIE_POWER_GPIO_CLK_ENABLE() __HAL_RCC_GPIOE_CLK_ENABLE()

#define BOARD_UNIT3_POWER_BUTTON_GPIO_PORT GPIOD
#define BOARD_UNIT3_POWER_BUTTON_GPIO_PIN GPIO_PIN_14
#define BOARD_UNIT3_POWER_BUTTON_GPIO_CLK_ENABLE() __HAL_RCC_GPIOD_CLK_ENABLE()

#define BOARD_UNIT3_RPIBOOT_GPIO_PORT GPIOF
#define BOARD_UNIT3_RPIBOOT_GPIO_PIN GPIO_PIN_8
#define BOARD_UNIT3_RPIBOOT_GPIO_CLK_ENABLE() __HAL_RCC_GPIOF_CLK_ENABLE()

#define BOARD_UNIT3_ACTIVITY_LED_GPIO_PORT GPIOE
#define BOARD_UNIT3_ACTIVITY_LED_GPIO_PIN GPIO_PIN_15
#define BOARD_UNIT3_ACTIVITY_LED_GPIO_CLK_ENABLE() __HAL_RCC_GPIOE_CLK_ENABLE()

#define BOARD_UNIT3_POWER_LED_GPIO_PORT GPIOD
#define BOARD_UNIT3_POWER_LED_GPIO_PIN GPIO_PIN_15
#define BOARD_UNIT3_POWER_LED_GPIO_CLK_ENABLE() __HAL_RCC_GPIOD_CLK_ENABLE()

#define BOARD_UNIT3_3V3_SENSE_GPIO_PORT GPIOC
#define BOARD_UNIT3_3V3_SENSE_GPIO_PIN GPIO_PIN_6
#define BOARD_UNIT3_3V3_SENSE_GPIO_CLK_ENABLE() __HAL_RCC_GPIOC_CLK_ENABLE()

#define BOARD_UNIT3_WS2812_INDEX 3U

#endif /* BOARD_H */
