weiiwang01/magi/bootloader/Core/Inc/openbootloader_conf.h

#ifndef OPENBOOTLOADER_CONF_H
#define OPENBOOTLOADER_CONF_H
#include "stm32g0xx_hal.h"
#define INTERFACES_SUPPORTED 1U
#define OPENBL_DEFAULT_MEM FLASH_START_ADDRESS
#define FLASH_START_ADDRESS 0x08010000U
#define FLASH_END_ADDRESS 0x08078000U
#define AREA_ERROR 0U
#define FLASH_AREA 1U
#define RDP_LEVEL_0 OB_RDP_LEVEL_0
#define RDP_LEVEL_1 OB_RDP_LEVEL_1
#endif
