weiiwang01/magi/bootloader/Core/Inc/flash_interface.h

/**
  ******************************************************************************
  * @file    flash_interface.h
  * @author  MCD Application Team
  * @brief   Header for flash_interface.c module
  ******************************************************************************
  * @attention
  *
  * Copyright (c) 2020 STMicroelectronics.
  * All rights reserved.
  *
  * This software is licensed under terms that can be found in the LICENSE file
  * in the root directory of this software component.
  * If no LICENSE file comes with this software, it is provided AS-IS.
  *
  ******************************************************************************
  */

/* Define to prevent recursive inclusion -------------------------------------*/
#ifndef FLASH_INTERFACE_H
#define FLASH_INTERFACE_H

/* Includes ------------------------------------------------------------------*/
#include <stdbool.h>
#include "common_interface.h"
#include "openbl_mem.h"
/* Exported types ------------------------------------------------------------*/
/* Exported constants --------------------------------------------------------*/

/* Exported macro ------------------------------------------------------------*/
/* Exported functions ------------------------------------------------------- */
static inline bool flash_range_valid(uint32_t address, uint32_t length)
{
  return address >= FLASH_START_ADDRESS && address < FLASH_END_ADDRESS &&
         length <= FLASH_END_ADDRESS - address;
}

void OPENBL_FLASH_JumpToAddress(uint32_t Address);
void OPENBL_FLASH_Lock(void);
uint8_t OPENBL_FLASH_Read(uint32_t Address);
void OPENBL_FLASH_Write(uint32_t Address, uint8_t *Data, uint32_t DataLength);
void OPENBL_FLASH_Unlock(void);
ErrorStatus OPENBL_FLASH_MassErase(uint8_t *p_Data, uint32_t DataLength);
ErrorStatus OPENBL_FLASH_Erase(uint8_t *p_Data, uint32_t DataLength);
extern OPENBL_MemoryTypeDef FLASH_Descriptor;

#endif /* FLASH_INTERFACE_H */
