weiiwang01/magi/(commit log)

2024-10-29 Magi v1.0
    [Control.kicad_sch, EthernetSwitch.kicad_sch, Magi.kicad_sch, Power.kicad_sch, Unit1A.kicad_sch, Unit1B.kicad_sch, Unit2A.kicad_sch, Unit2B.kicad_sch]
2024-11-12 Upload the case design for Magi v1.0
    [Magi-Body.step, Magi-Lid.step]
2026-08-09 (migrate) Implement ADC system
2026-08-09 (migrate) Add ADC source in CMakeLists.txt
2026-08-09 (migrate) Implement ws2812 LED
2026-08-09 (migrate) Implement USB data and power switch
2026-08-10 (migrate) Add bitbang i2c and USB2514 configuration
2026-08-11 (migrate) Add STM32G0 drivers
2026-08-11 (migrate) Add RTL8367S driver
2026-08-12 (migrate) Add unit 3v3 rail sensing
2026-09-09 (migrate) Update rtl switch api
2026-09-10 (migrate) Implement USB CDC driver
2026-09-13 (migrate) Add CH390 driver
2026-09-20 (migrate) Implement console relay
2026-09-27 Magi v2.0
    [Connector.kicad_sch, Control.kicad_sch, Controller.kicad_sch, EthernetSwitch.kicad_sch, Magi-Body.step, Magi-Lid.step, Magi.kicad_pcb, Magi.kicad_sch]
2026-10-10 Add USB-C power status command
2026-10-11 Add stm32-mw-openbl
2026-10-19 Ignore non-printable and escape sequences in cmd shell
2026-10-21 Use LED to indicate bootloader errors
2026-10-22 Update schematic PDF
2026-11-09 Fix button definition in bootloader
